ECE-412-Capstone-Sensor-Suite/Team-20-Sensor-Suite/Firmware/Py Scripts/readme.md

*OAP LOGGER* :
This is where we connect to the manager and receive and organize sensor data sent for the OAP(on-chip application) that we loaded onto the motes.
