ECE-412-Capstone-Sensor-Suite/Team-20-Sensor-Suite/Firmware/wind-sensor-to-PC-fan-Arduino--master/README.md

# wind-sensor-to-PC-fan-Arduino-
code for connecting wind sensor (Wind Sensor Rev. C) to array of PC fans with Arduino
