ECE-412-Capstone-Sensor-Suite/Team-20-Sensor-Suite/Project Weekly Meetings/412 Week 1  Meet .pptx

## 412 Week 1 Progress

by: Yousef Alkhelaifi, Calvin Xaybanha, Yikun Wang, Yudi Bao, Brandon Garcia

## Brandon’s Review

Completed:
- Added a paragraph on “Why” this device/system is being created.
- Added a paragraph on the Market analysis
- Created a rough draft of the Block 1 diagram.
- Added a few requirements
In progress:
- Research on what sensors to purchase
- Research on the Smartmesh IP
- Set schedule

## Yudi’s Review

Completed:
Search for smartmesh IP development environment
Search for several code samples about connecting sensors and arduino on github in order to build my things
(But still don’t know we should use smartmesh IP or arduino+wifi model to build system)
In progress:
Build the code frame according to requirements
Research different sensors that we should use

## Calvin’s Review

Completed:
- Added some project requirements
- Added a few sentences to the design specification
In Progress:
- Research on sensors + SmartMesh IP

## Yousef review

Completed:
- Created framework for PDS
- Rough Redrafted the Functional decomposition diagram to include a micro controller and highlight the interaction between the housing and the sensors
- Wrote an introduction to the PDS
In progress:
- Create a more detailed L1 diagram
- Finish the Gantt chart
- Decide which part of the project i want to lead

## Yikun Wang

Completed:
In progress:
- Research on low power supply(but still have no ideas of researching)
