ECE-412-Capstone-Sensor-Suite/Team-20-Sensor-Suite/Project Weekly Meetings/412 Week 4 Meet.pptx

## 412 Week 4 Progress

by: Yousef Alkhelaifi, Calvin Xaybanha, Yikun Wang, Yudi Bao, Brandon Garcia

## Yousef Al-Khelaifi

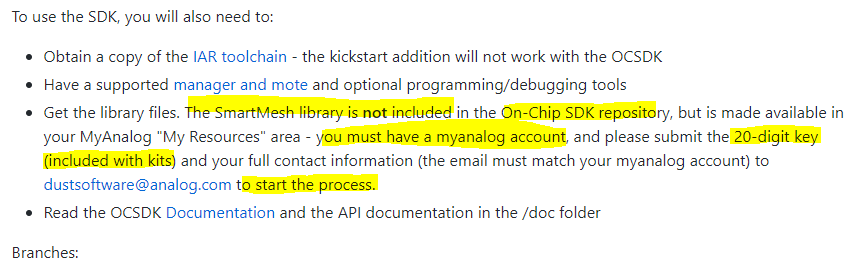
[picture p15: figure]

Completed
- Smartmesh IP BOM research to find get the basic set of components needed for cheapest price
- Microcontroller research [ Texas instruments - MSP432P401]
  - Development board - $19.99
  - Roughly 100 pins and great low power performance (80uA/Mhz)
  - TI supports debugging and programming only through Code composer studio
  - Might be too complex, if we are willing to invest the time of learning this complex chip, why not invest the time to learning using LTP5900 chip as primary microcontroller.
- Finalized initial peak-power consumption table
- Found some worrying thing on dust cloud

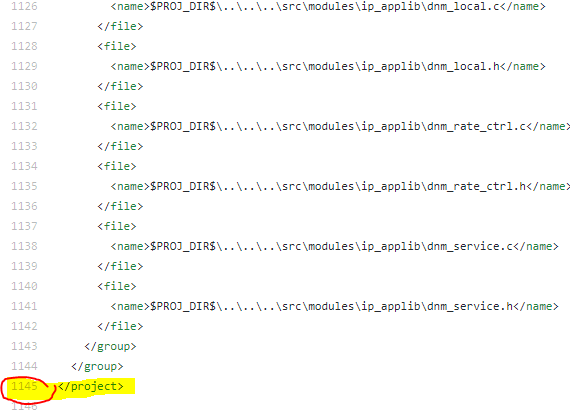
[picture p16: figure]
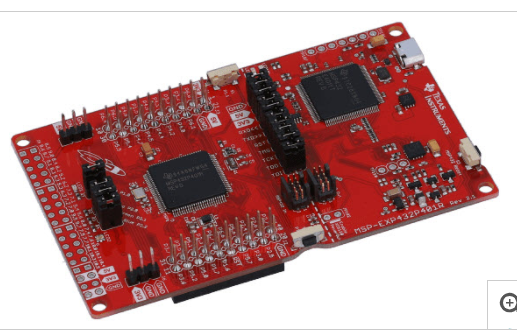
[picture p17: figure]

## Extra stuff

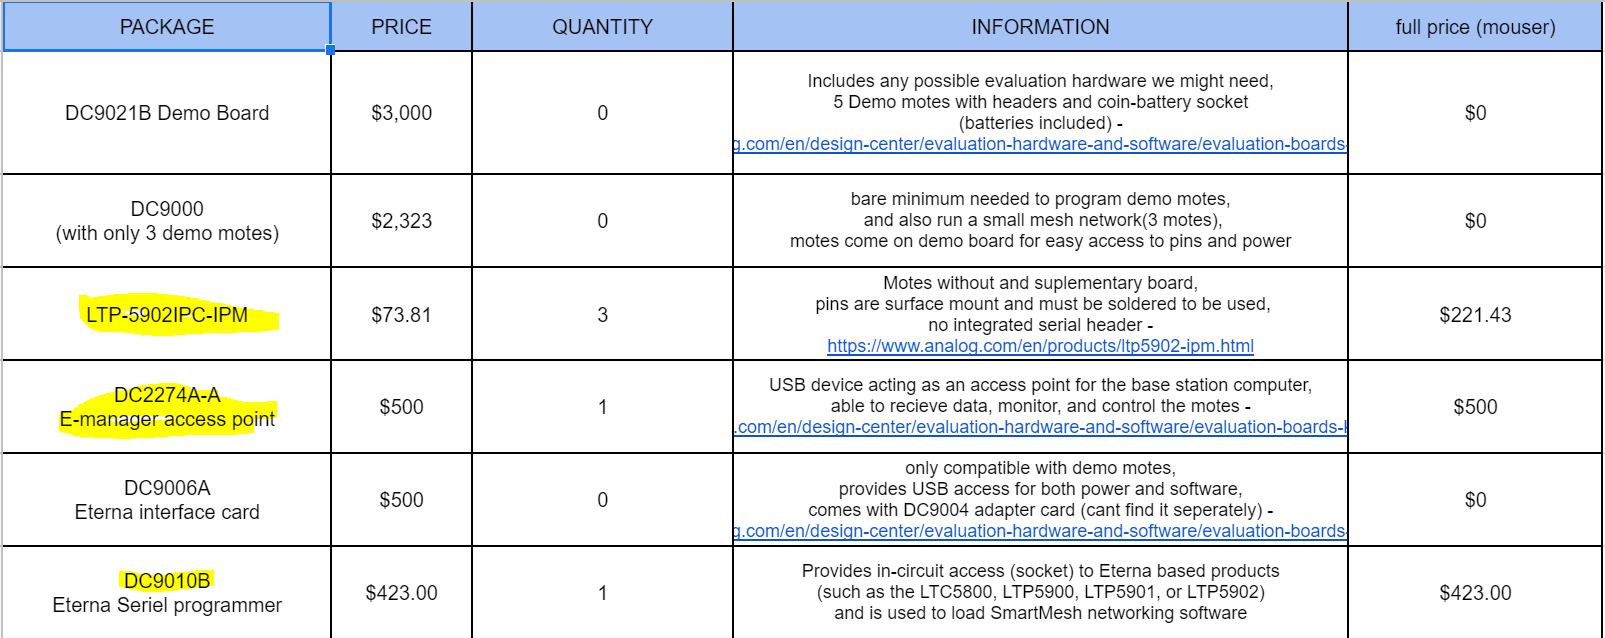
[picture p18: figure]

In Progress:
- Hands on testing with smart mesh hardware
- Researching SPI and I2C communication

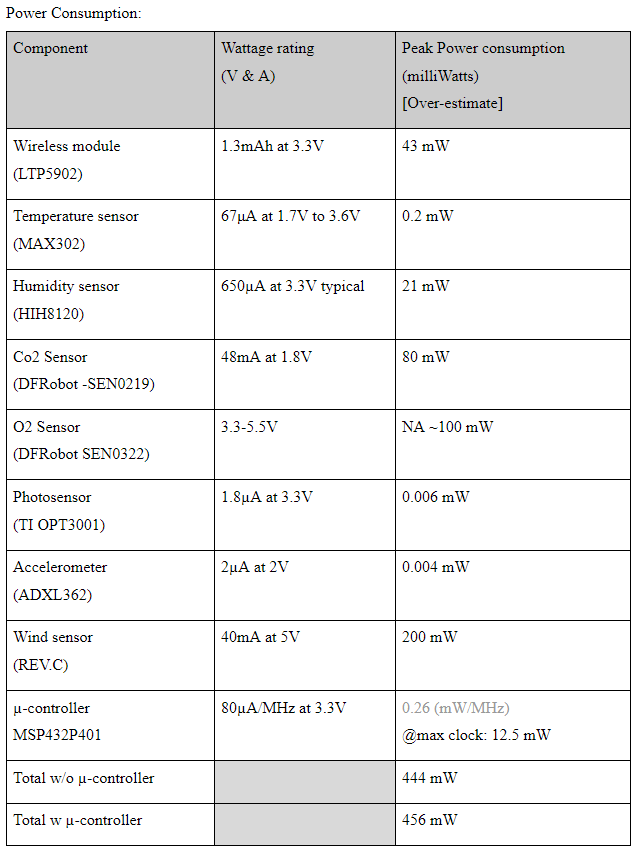
[picture p19: figure]

## Calvin Xaybanha

Completed:
- Rough Project Schedule outlined
Inprogress:
- Review and revise Project Design Specifications

## Yudi Bao

Completed:
- First version of Product Schedule
- Configure virtual machine for Emanager running
In progress:
- Continue to configure Smartmesh SDK part to
Win XP system by following the document of
SmartMesh WirelessHART Easy Start Guide

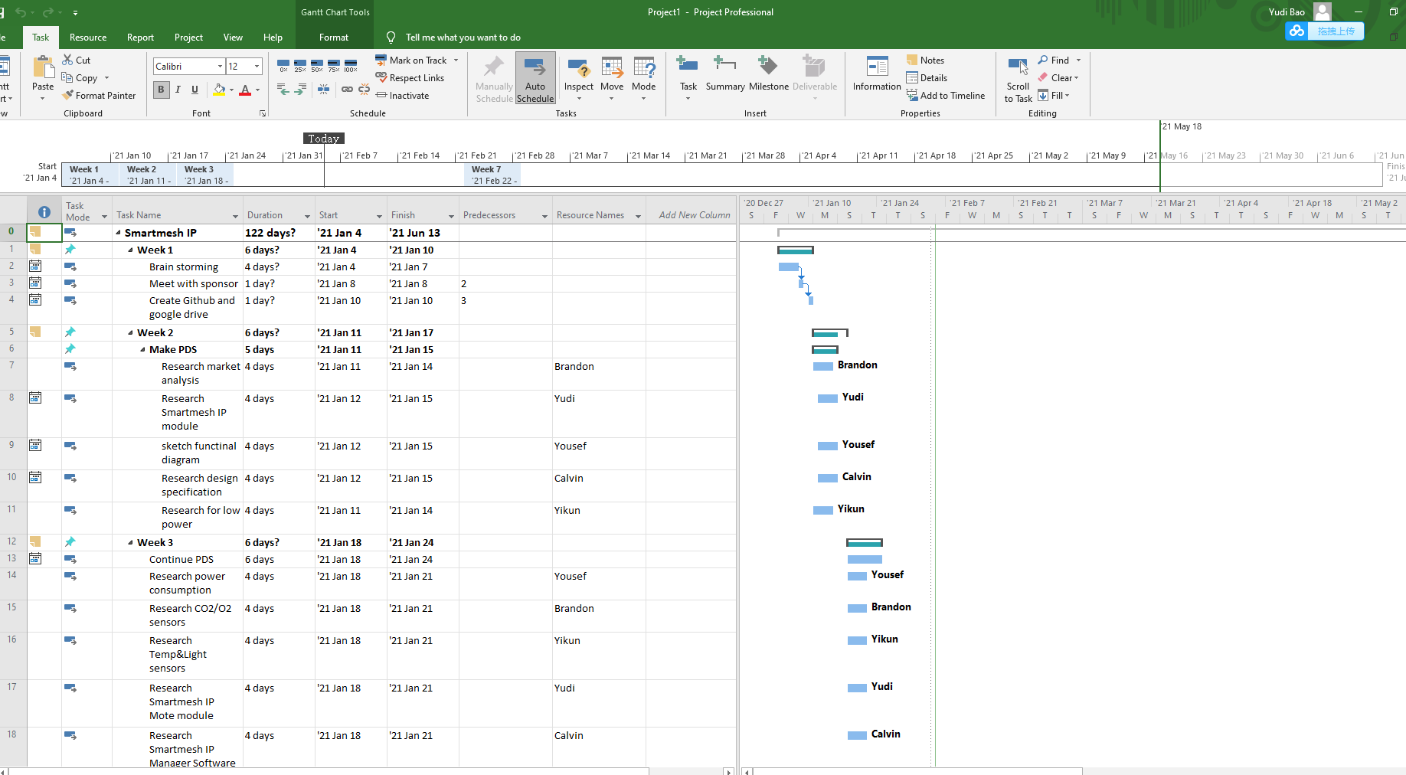
[picture p20: figure]
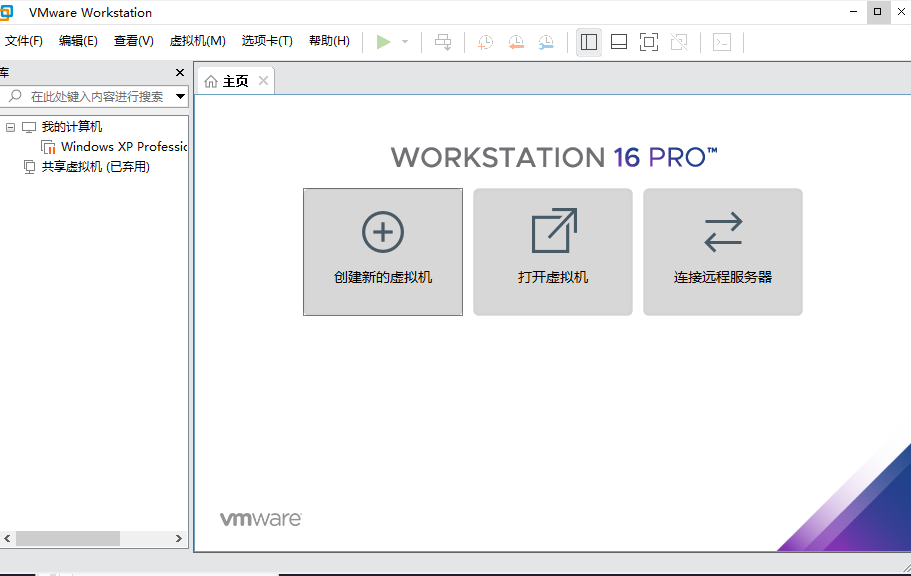
[picture p21: figure]

## Slide 6

The 1st project schedule:
1.Add missions from Week 1 to Week 22 to build frame of our work
2.Try to give all groups an even distribution of tasks

## VMware Workstation Pro 16 For Win XP operating system

According to document, Smartmesh SDK can match with Win XP, that’s why we need virtual machine(VM) to meet the requirement of software running.
1.find resource of .iso document 2. Search for activate code
3.upload Smartmesh SDK file to VM

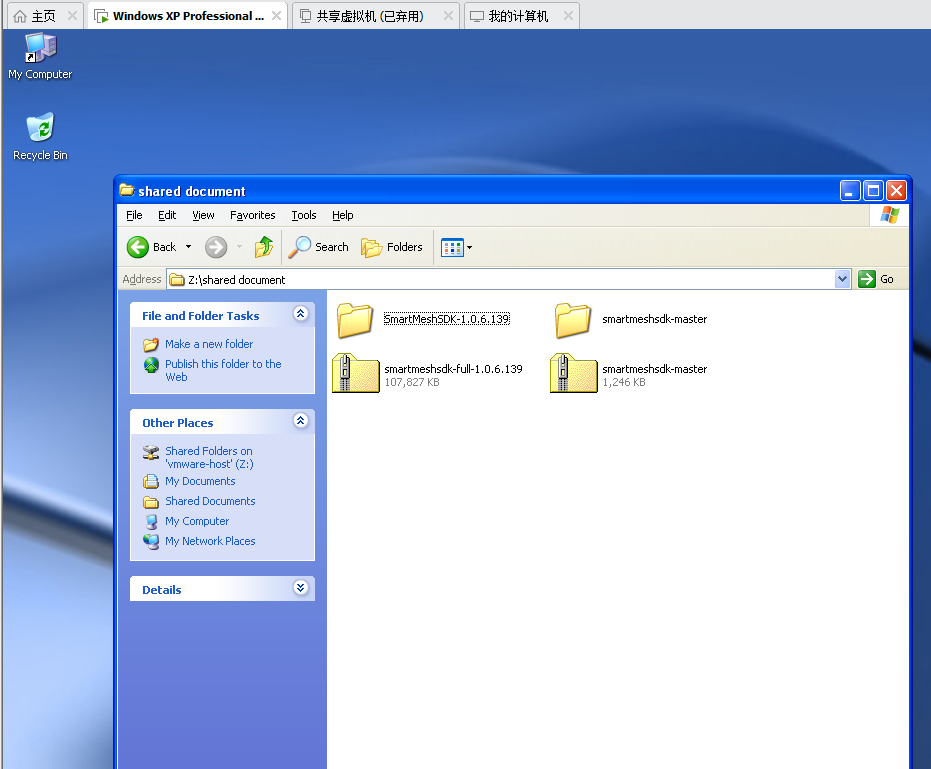
[picture p22: figure]
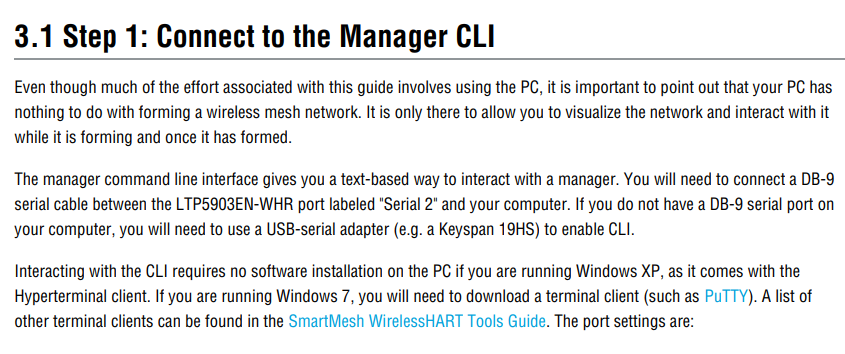
[picture p23: figure]

## Brandon Garcia

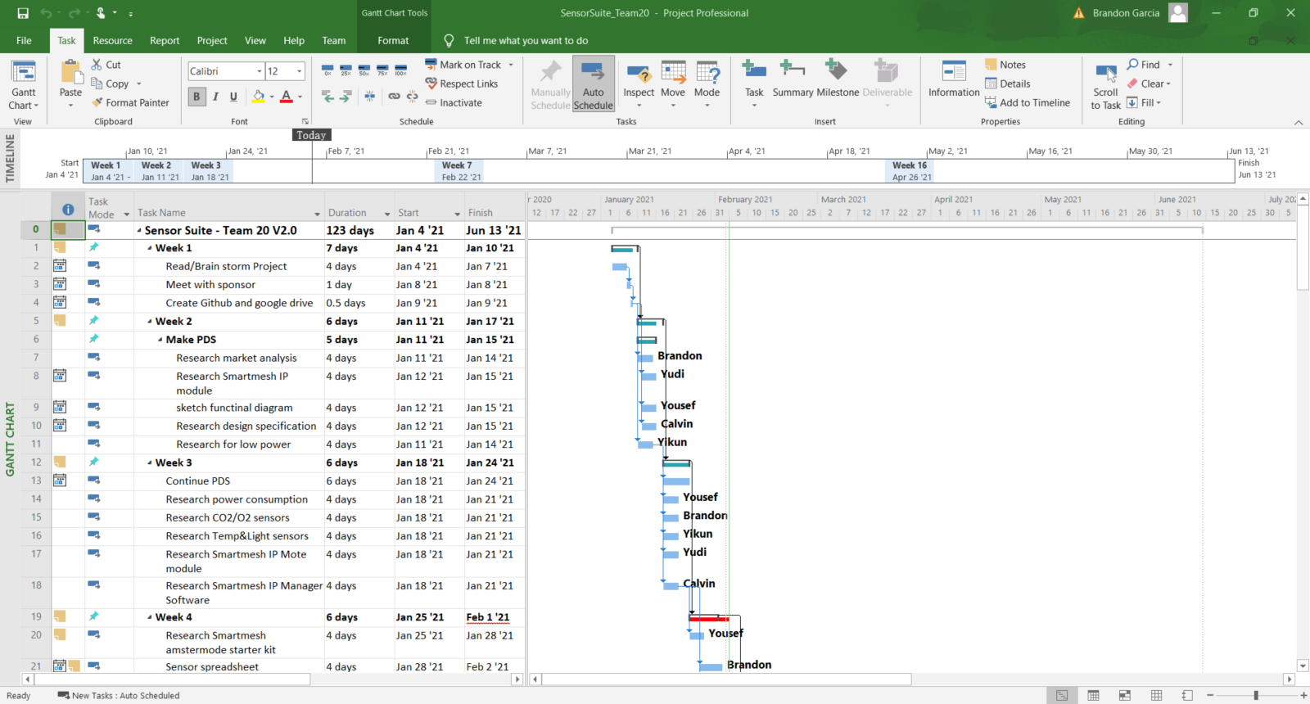
[picture p24: figure]

Completed:
- Final Draft of Project schedule
- Helped with Vibration Sensor search
- Finalize BOM for sensors
In Progress:
- Need PDS approval
- Github/Documentation Upload

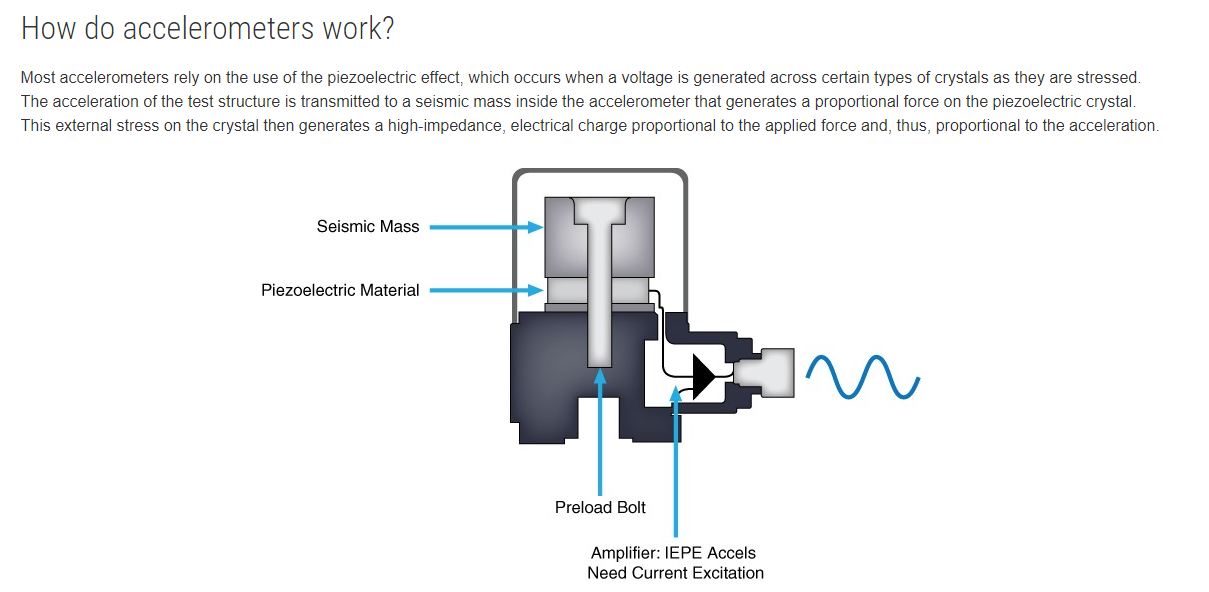
[picture p25: figure]

## CN CO2 Sensor- DFR Rebrand!

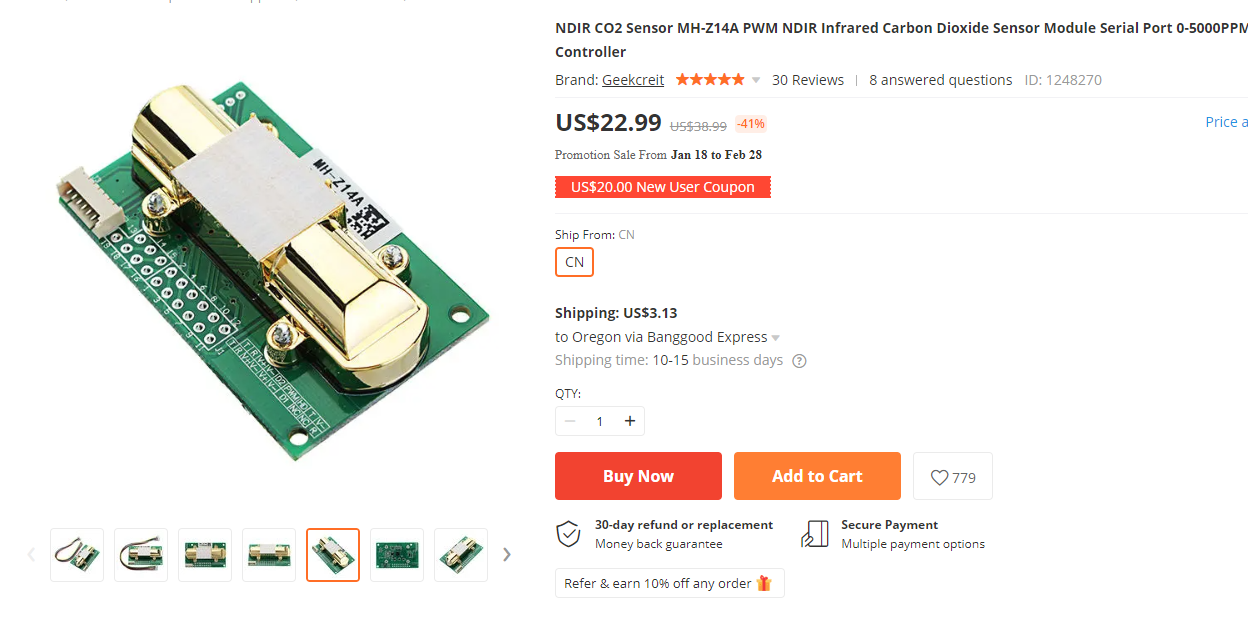
[picture p26: figure]

## Yikun Wang

Completed:
- Research on Vibration Sensor
Inprogress:
- Research on water contact sensor because of the supply power requirement
- Research on the code of our sensor_finding some similar examples

## Piezoelectric Sensor(Vibration)

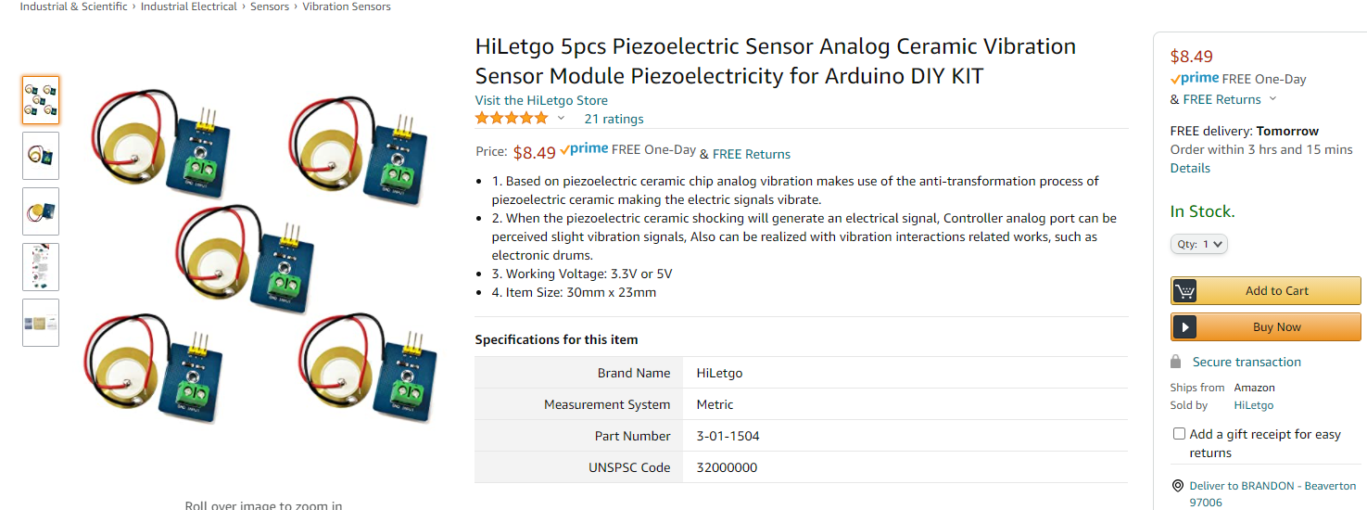
[picture p27: figure]
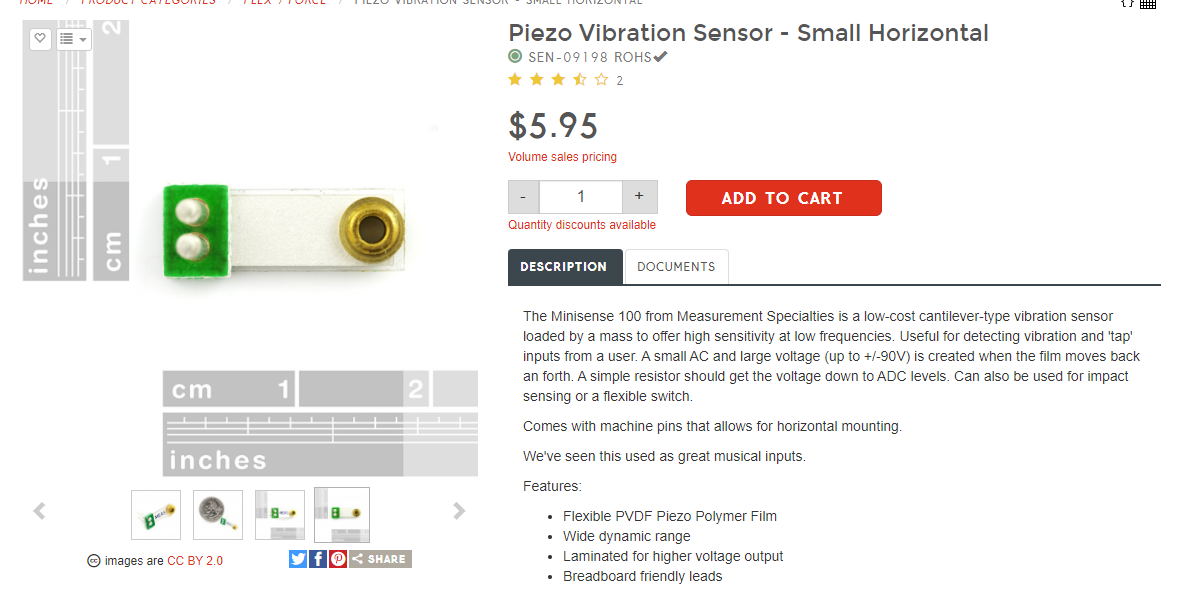
[picture p28: figure]
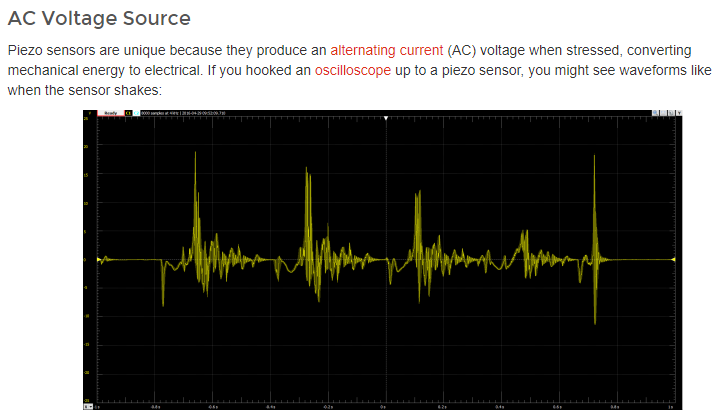
[picture p29: figure]
