ECE-412-Capstone-Sensor-Suite/Team-20-Sensor-Suite/Project Schedule/SensorSuite_Team20_V2.0.pdf

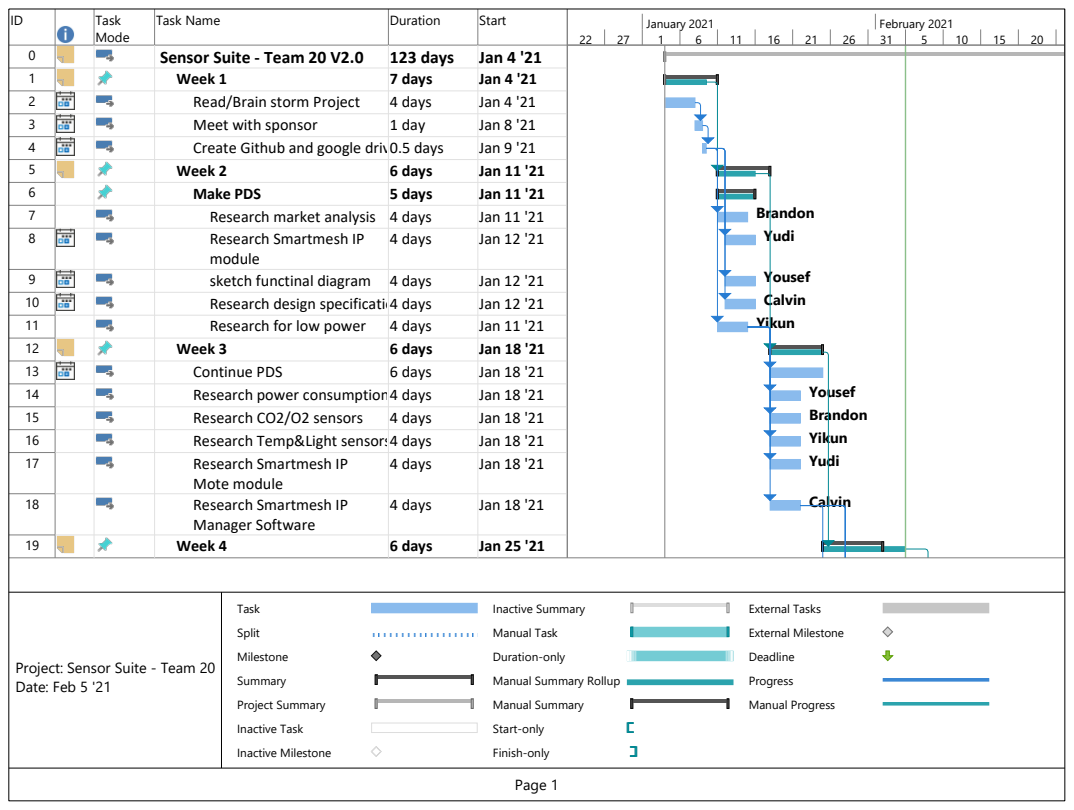
[picture p38: page 1]
Task; Mode; Task Name; Duration; Start; Sensor Suite - Team 20 V2.0; 123 days; Jan 4 '21; Week 1; 7 days; Read/Brain storm Project; 4 days; Meet with sponsor; 1 day; Jan 8 '21; Create Github and google drive0.5 days; Jan 9 '21; Week 2; 6 days; Jan 11 '21; Make PDS; 5 days; Research market analysis; Research Smartmesh IP; module; Jan 12 '21; sketch functinal diagram; Research design specification4 days; Research for low power; Week 3; Jan 18 '21; Continue PDS; Research power consumption4 days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

Project: Sensor Suite - Team 20
Date: Feb 5 '21

Manual Summary Rollup

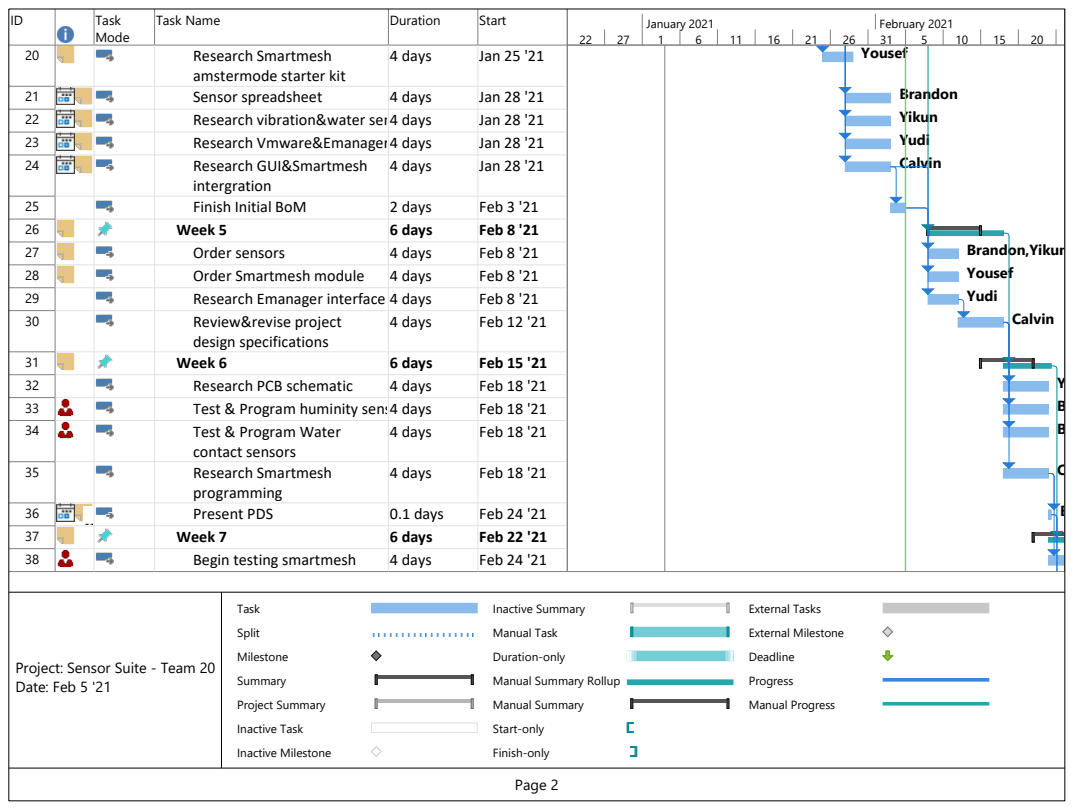
[picture p39: page 2]
Mode; Research Smartmesh; 4 days; Jan 25 '21; Sensor spreadsheet; Jan 28 '21; Research vibration&water sensors 4 days; Research Vmware&Emanager4 days; Research GUI&Smartmesh; intergration; Finish Initial BoM; 2 days; Feb 3 '21; Week 5; 6 days; Feb 8 '21; Order sensors; Order Smartmesh module; Research Emanager interface 4 days; Review&revise project; design specifications; Feb 12 '21; Week 6; Feb 15 '21; Research PCB schematic; Feb 18 '21; Test & Program huminity sensors 4 days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

amstermode starter kit

Brandon,Yikun,Yousef,Yudi,Calvin

Project: Sensor Suite - Team 20
Date: Feb 5 '21

Manual Summary Rollup

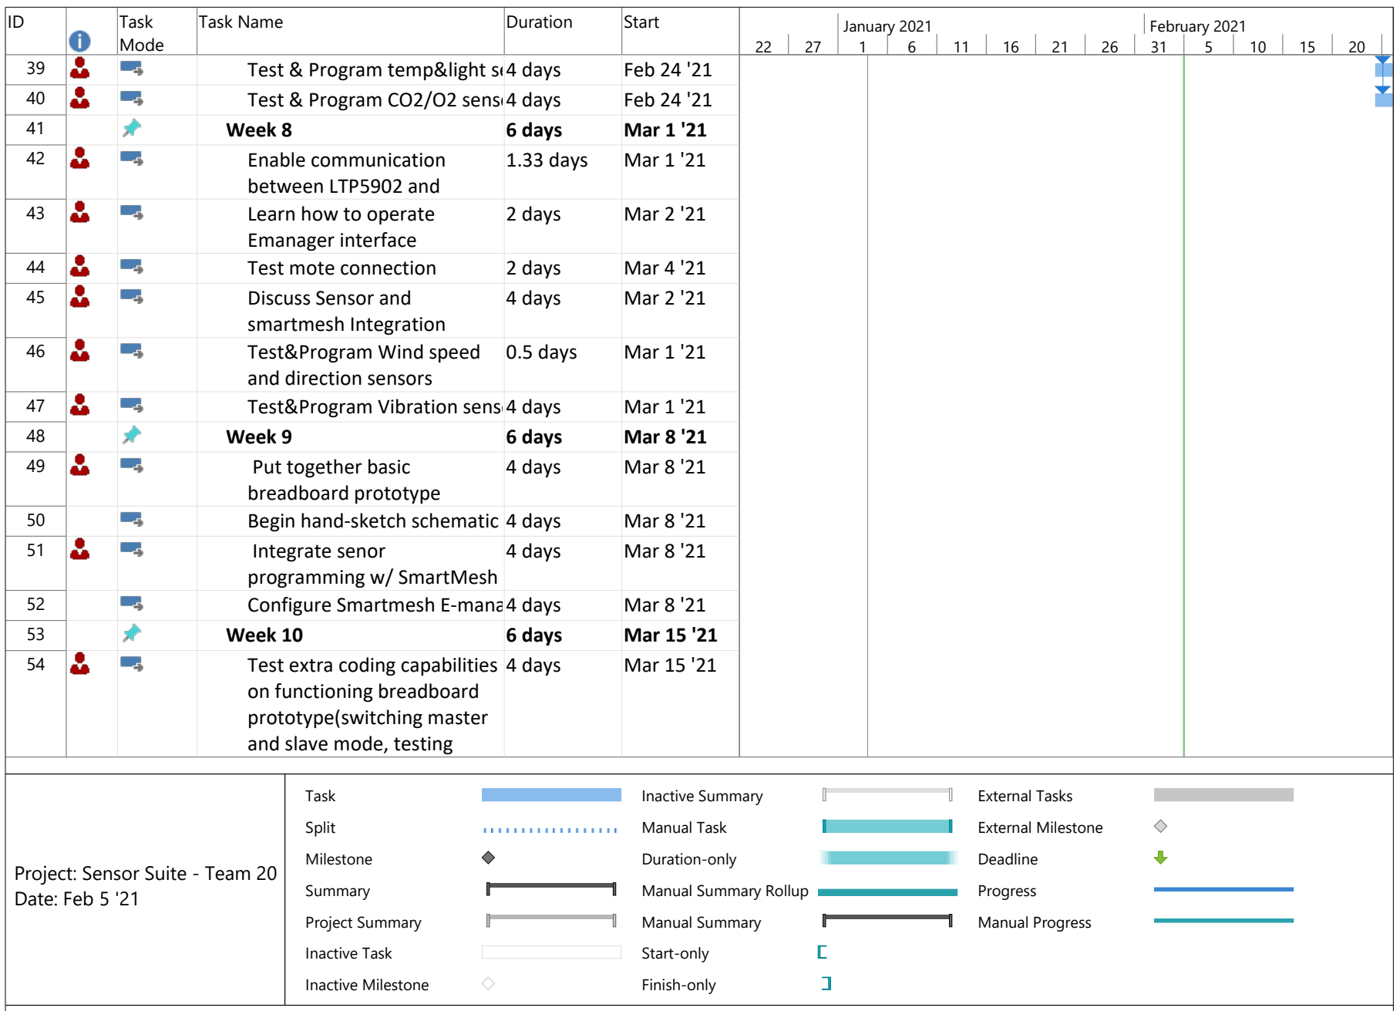
[picture p40: figure]
Mode; Week 8; 6 days; Mar 1 '21; Enable communication; between LTP5902 and; 1.33 days; Learn how to operate; Emanager interface; 2 days; Mar 2 '21; Test mote connection; Mar 4 '21; Discuss Sensor and; smartmesh Integration; 4 days; Test&Program Wind speed; and direction sensors; 0.5 days; Test&Program Vibration sensors 4 days; Week 9; Mar 8 '21; Put together basic; breadboard prototype; Begin hand-sketch schematic; Integrate senor; programming w/ SmartMesh; Configure Smartmesh E-manager 4 days; Week 10; Mar 15 '21; Test extra coding capabilities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

39 | Test & Program temp&light sensors 4 days | Feb 24 '21
40 | Test & Program CO2/O2 sensors 4 days | Feb 24 '21

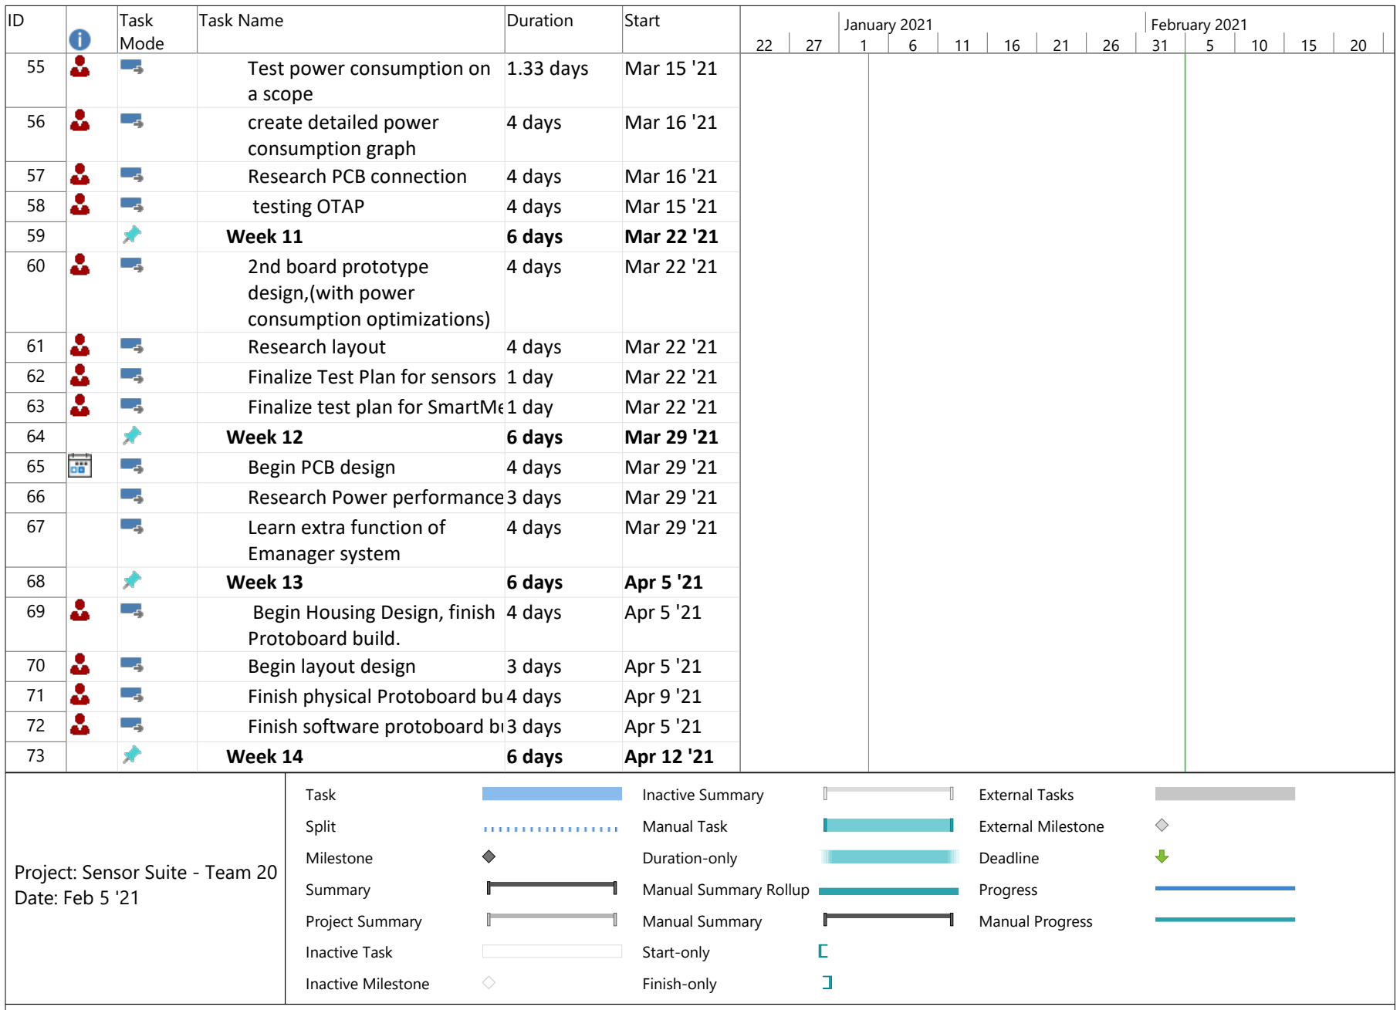
[picture p41: figure]
Mode; Test power consumption on; a scope; 1.33 days; Mar 15 '21; create detailed power; consumption graph; 4 days; Mar 16 '21; Research PCB connection; testing OTAP; Week 11; 6 days; Mar 22 '21; 2nd board prototype; design,(with power consumption optimizations); Research layout; Finalize Test Plan for sensors; 1 day; Week 12; Mar 29 '21; Begin PCB design; Research Power performance3 days; Learn extra function of; Emanager system; Week 13; Apr 5 '21; Begin Housing Design, finish; Protoboard build.; Begin layout design; 3 days; Finish physical Protoboard build4 days; Apr 9 '21; Week 14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

63 | Finalize test plan for SmartMesh1 day | Mar 22 '21
72 | Finish software protoboard build 3 ays | Apr 5 '21

Mode
74 | Begin Visual Dashboard | 4 days | Apr 12 '21
75 | Configure data-organizations system | 4 days | Apr 12 '21
76 | Finish coding on protoboard build | 4 days | Apr 12 '21
77 | Discuss PCB progress | 4 days | Apr 12 '21
78 | Week 15 | 6 days | Apr 19 '21
79 | Finalize PCB design and send files for fabrication | 4 days | Apr 19 '21
80 | FInalize Housing Design | 4 days | Apr 19 '21
81 | Finalize Power Source | 4 days | Apr 19 '21
82 | Discuss Documentation progress 1 day | Apr 19 '21
83 | Finish final BoM | 2 days | Apr 23 '21
84 | Week 16 | 6 days | Apr 26 '21
85 | Allow for shipping time for PCB fabrication | 4 days | Apr 27 '21
86 | Calculate theorical power consumption of 2nd propotype system | 4 days | Apr 27 '21
87 | Build 2nd prototype in real environment | 4 days | Apr 26 '21
88 | Week 17 | 6 days | May 3 '21
22 | 27 | 1 | 6 | 11 | 16 | 21 | 26 | 31 | 5 | 10 | 15 | 20

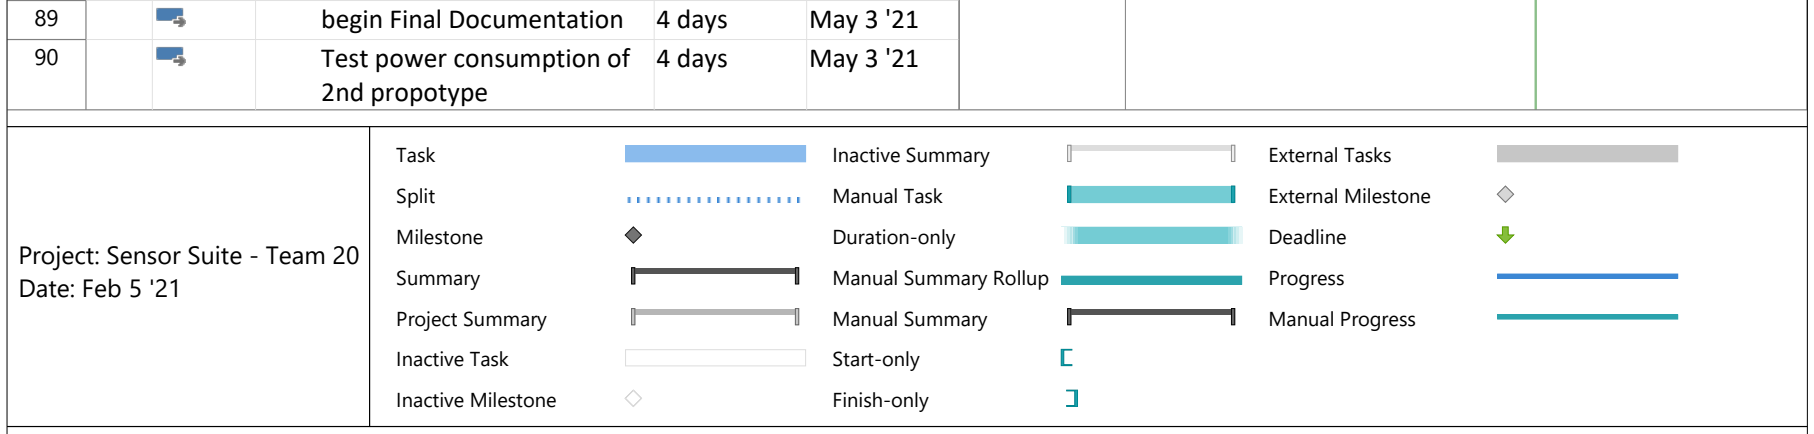
[picture p42: figure]
begin Final Documentation; 4 days; May 3 '21; Test power consumption of; 2nd propotype; Task; Split; Milestone; Summary; Project Summary; Inactive Task; Inactive Milestone; Inactive Summary; Manual Task; Duration-only; Manual Summary Rollup; Manual Summary; Start-only; Finish-only; External Tasks; External Milestone; Deadline; Progress; Manual Progress; Project: Sensor Suite - Team 20 Date: Feb 5 '21

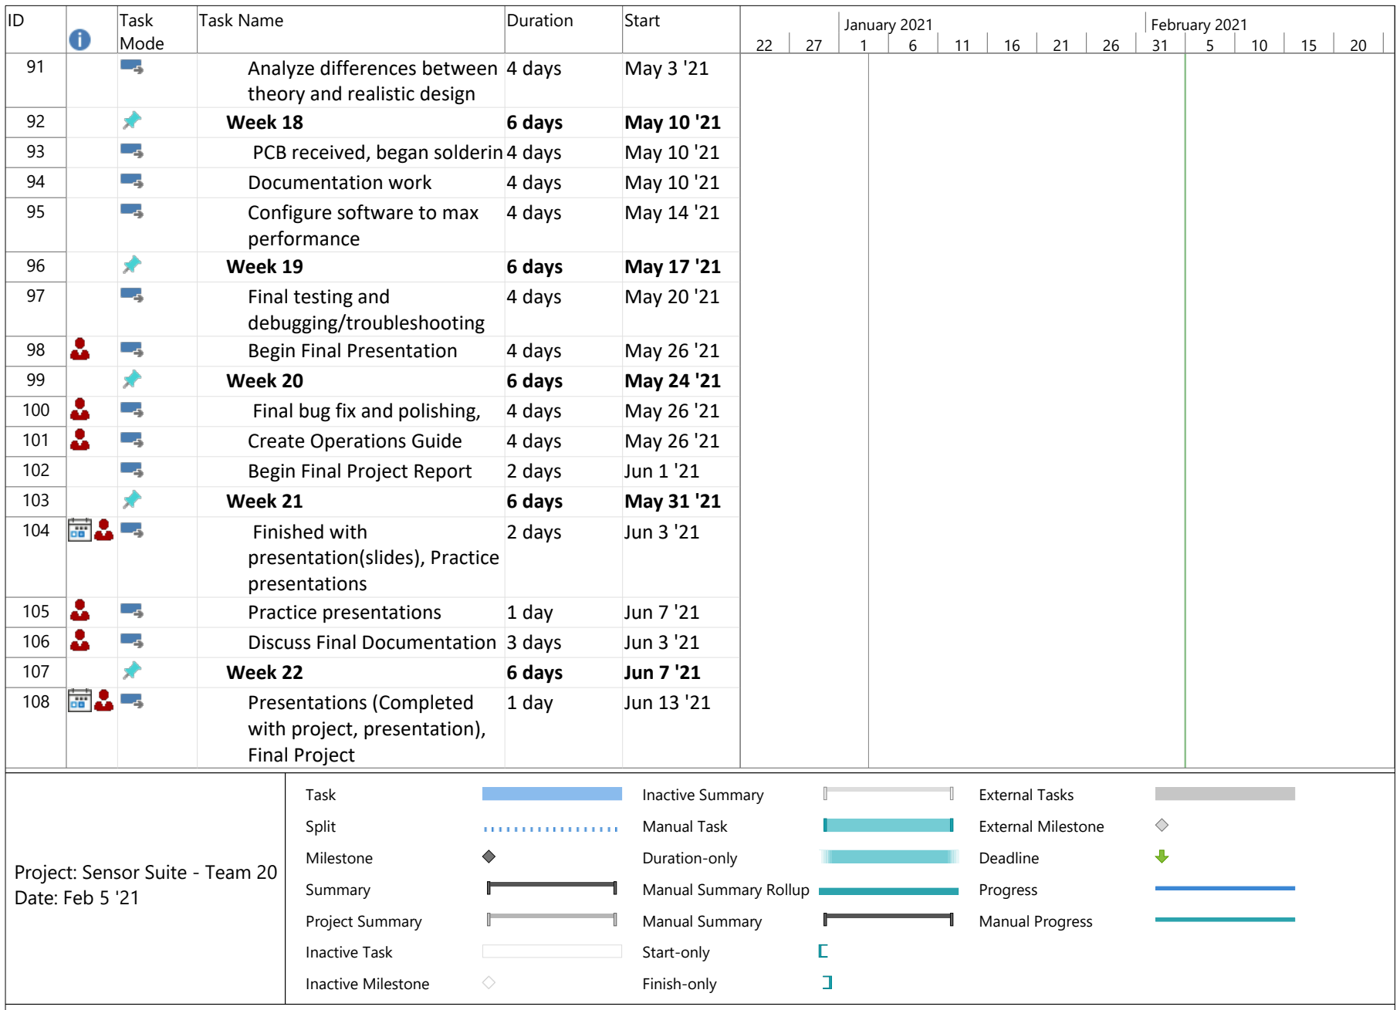
[picture p43: figure]
Mode; Analyze differences between; theory and realistic design; 4 days; May 3 '21; Week 18; 6 days; May 10 '21; PCB received, began soldering4 days; Documentation work; Configure software to max; performance; May 14 '21; Week 19; May 17 '21; Final testing and; debugging/troubleshooting; May 20 '21; Begin Final Presentation; May 26 '21; Week 20; May 24 '21; Final bug fix and polishing,; Create Operations Guide; Begin Final Project Report; 2 days; Jun 1 '21; Week 21; May 31 '21; Finished with; presentation(slides), Practice presentations; Jun 3 '21; Practice presentations; 1 day; Jun 7 '21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

Mode
109 | Second Team evaluation | 1 day | Jun 13 '21
22 | 27 | 1 | 6 | 11 | 16 | 21 | 26 | 31 | 5 | 10 | 15 | 20

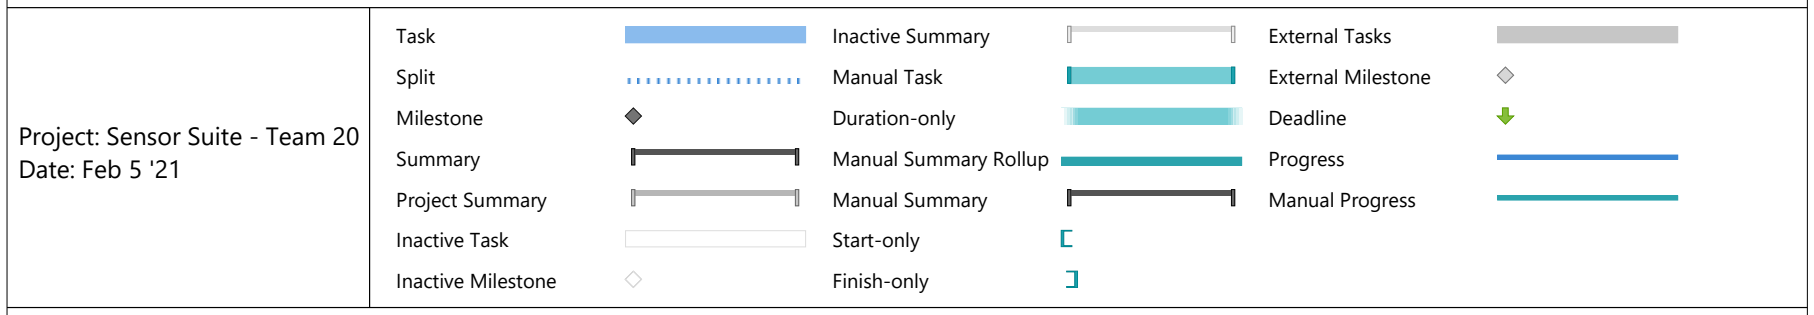
[picture p44: figure]
Task; Split; Milestone; Summary; Project Summary; Inactive Task; Inactive Milestone; Inactive Summary; Manual Task; Duration-only; Manual Summary Rollup; Manual Summary; Start-only; Finish-only; External Tasks; External Milestone; Deadline; Progress; Manual Progress; Project: Sensor Suite - Team 20 Date: Feb 5 '21

25 | 2 | 7 | 12 | 17 | 22 | 27 | 1 | 6 | 11 | 16 | 21 | 26 | 1 | 6 | 11 | 16 | 21 | 26 | 31 | 5 | 10 | 15 | 20 | 25 | 30 | 5 | 10
March 2021 | April 2021 | May 2021 | June 2021 | July 2021

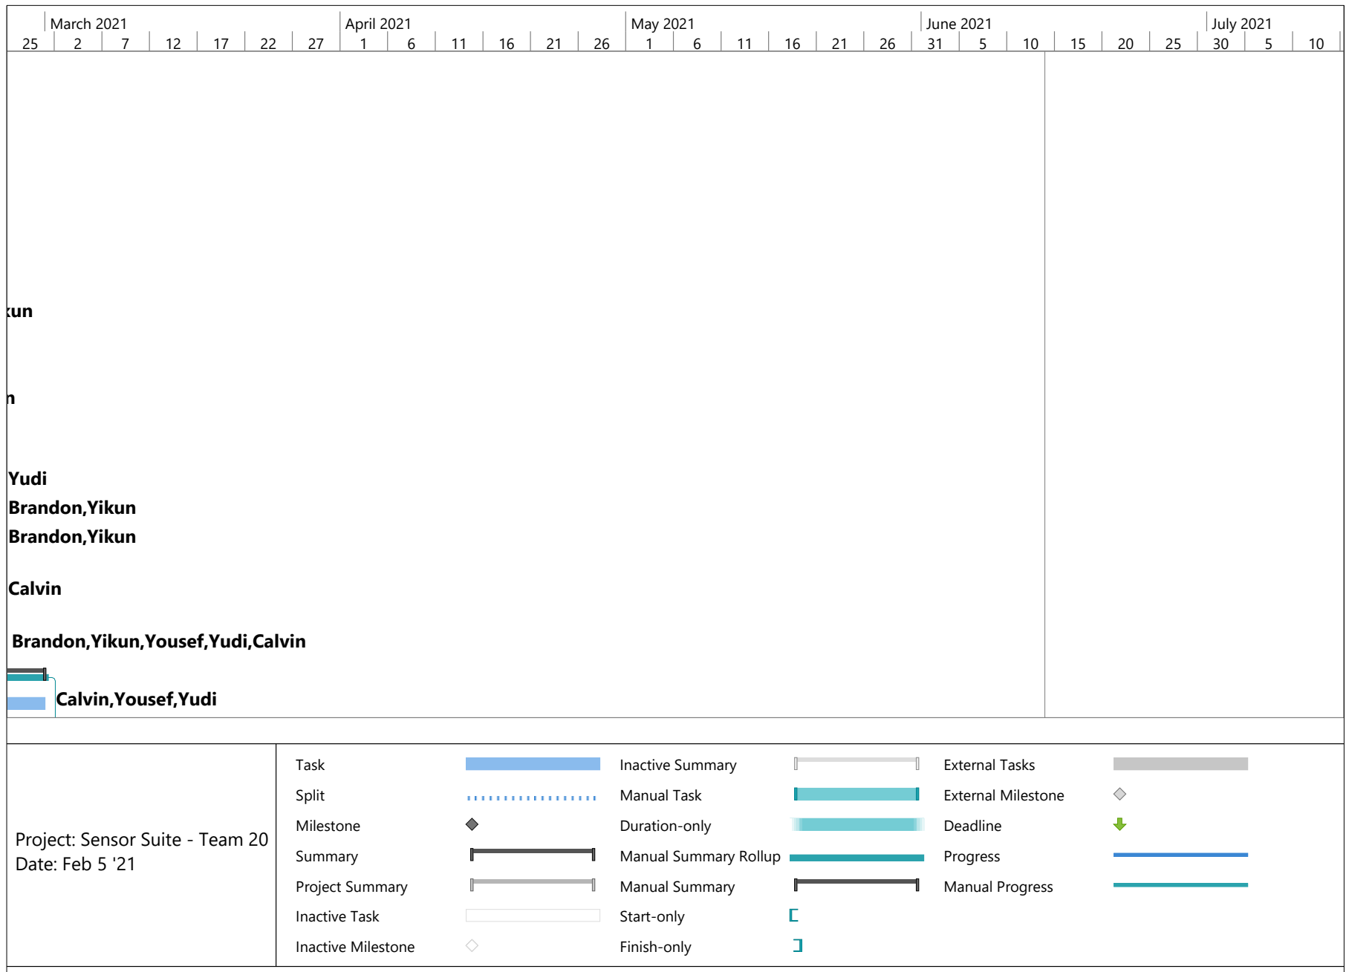
[picture p45: figure]
Brandon,Yikun; Yousef; Yudi; Calvin; Brandon,Yikun,Yousef,Yudi,Calvin; Calvin,Yousef,Yudi; Task; Split; Milestone; Summary; Project Summary; Inactive Task; Inactive Milestone; Inactive Summary; Manual Task; Duration-only; Manual Summary Rollup; Manual Summary; Start-only; Finish-only; External Tasks; External Milestone; Deadline; Progress; Manual Progress; Project: Sensor Suite - Team 20 Date: Feb 5 '21
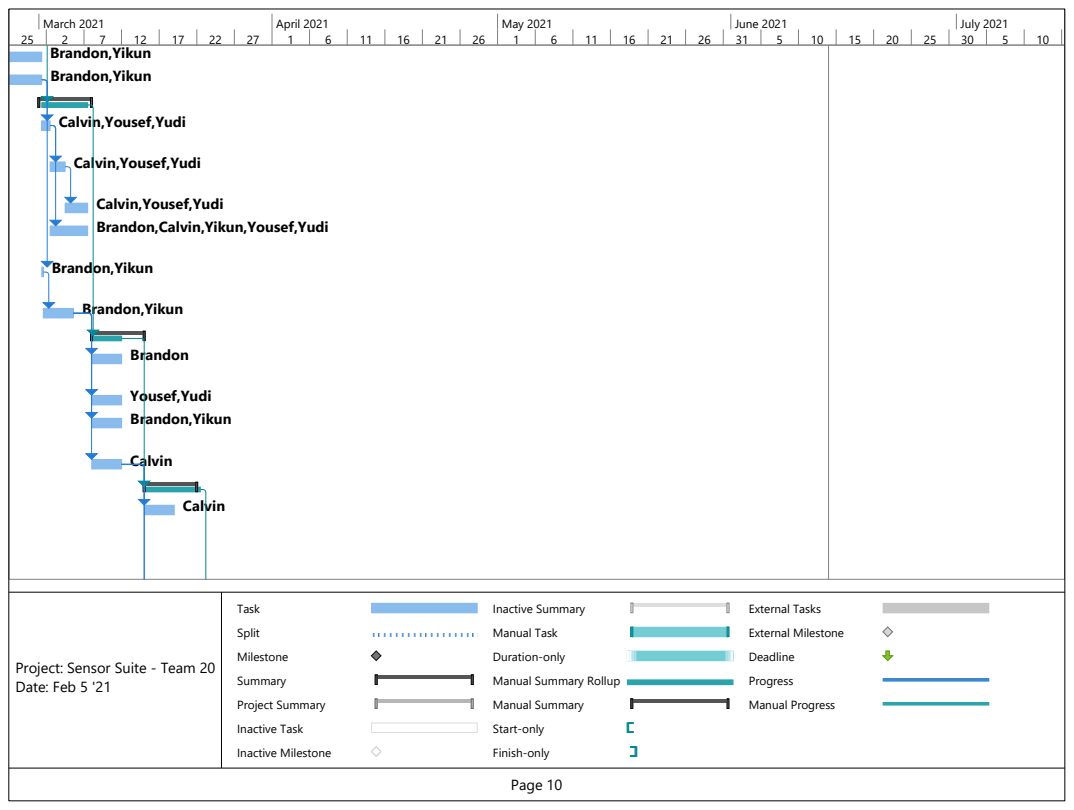
[picture p46: page 10]
Brandon,Yikun; Brandon; Yousef,Yudi; Calvin; Task; Split; Milestone; Summary; Project Summary; Inactive Task; Inactive Milestone; Inactive Summary; Manual Task; Duration-only; Manual Summary; Start-only; Finish-only; External Tasks; External Milestone; Deadline; Progress; Manual Progress

Calvin,Yousef,Yudi

Brandon,Calvin,Yikun,Yousef,Yudi

Project: Sensor Suite - Team 20
Date: Feb 5 '21

Manual Summary Rollup

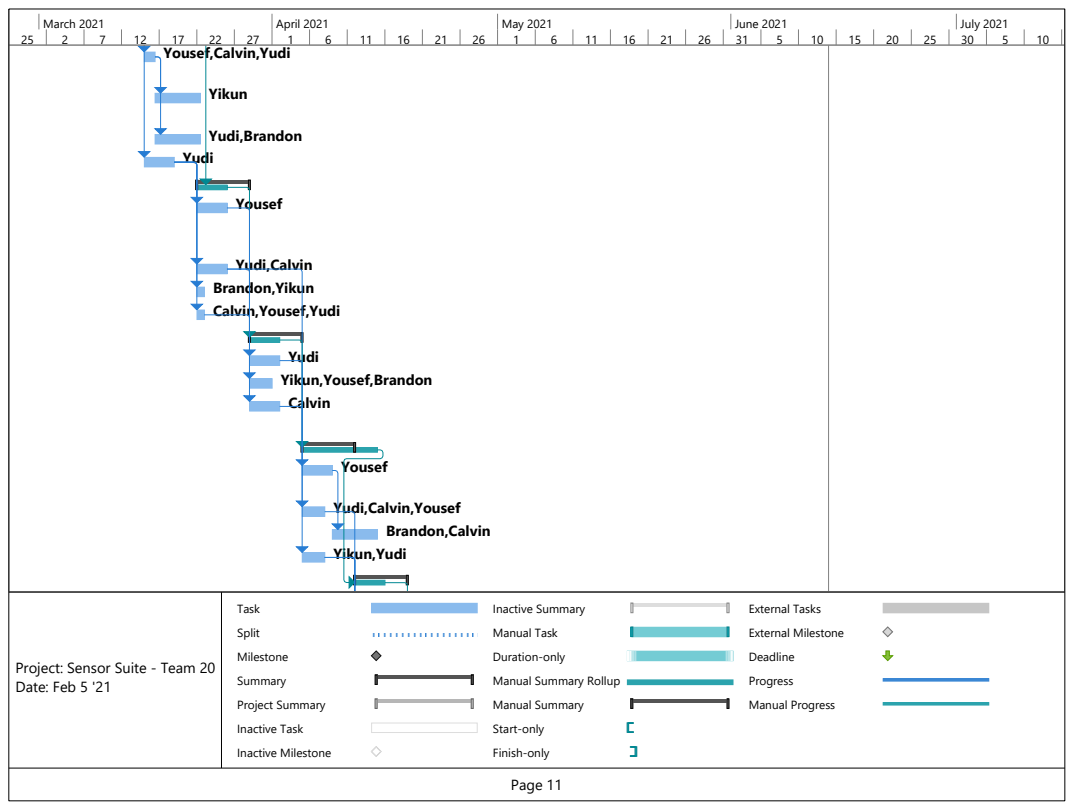
[picture p47: page 11]
Yikun; Yudi,Brandon; Yudi; Yousef; Brandon,Calvin; Yikun,Yudi; Task; Split; Milestone; Summary; Project Summary; Inactive Task; Inactive Milestone; Inactive Summary; Manual Task; Duration-only; Manual Summary; Start-only; Finish-only; External Tasks; External Milestone; Deadline; Progress; Manual Progress

Yousef,Calvin,Yudi

Yudi,Calvin
Brandon,Yikun
Calvin,Yousef,Yudi

Yudi
Yikun,Yousef,Brandon
Calvin

Yudi,Calvin,Yousef

Project: Sensor Suite - Team 20
Date: Feb 5 '21

Manual Summary Rollup

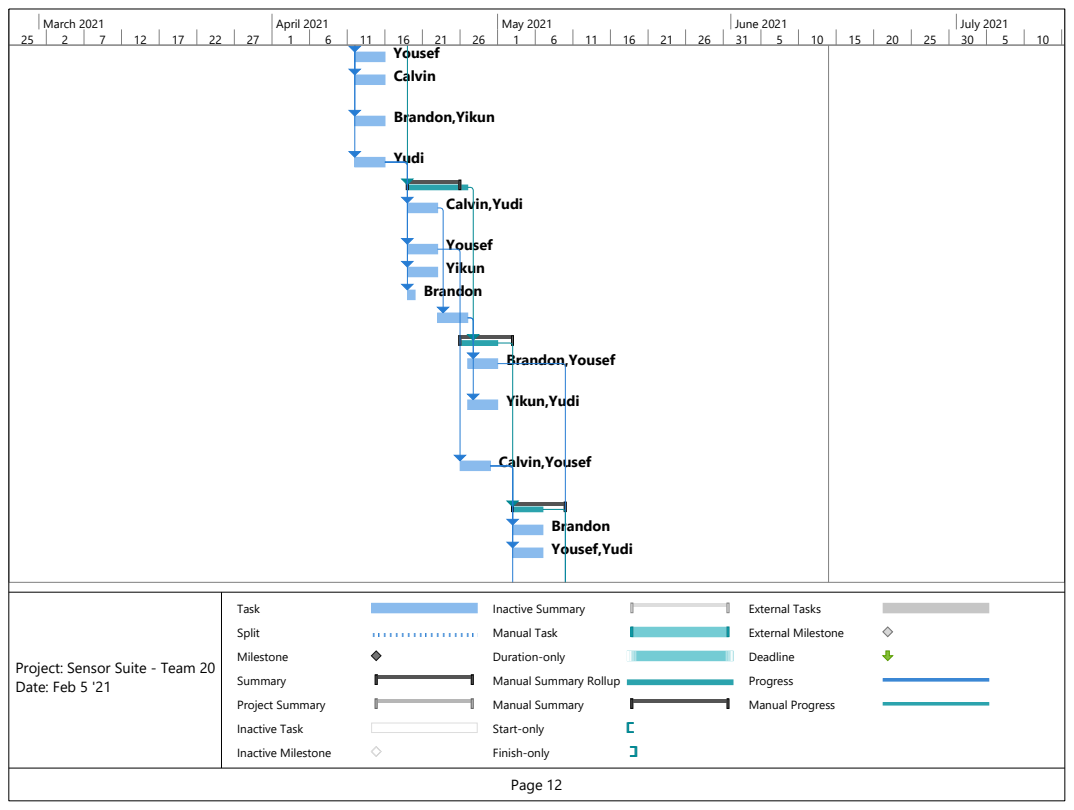
[picture p48: page 12]
Yousef; Calvin; Brandon,Yikun; Yudi; Calvin,Yudi; Yikun; Brandon; Brandon,Yousef; Yikun,Yudi; Calvin,Yousef; Yousef,Yudi; Task; Split; Milestone; Summary; Project Summary; Inactive Task; Inactive Milestone; Inactive Summary; Manual Task; Duration-only; Manual Summary; Start-only; Finish-only; External Tasks; External Milestone; Deadline; Progress; Manual Progress

Project: Sensor Suite - Team 20
Date: Feb 5 '21

Manual Summary Rollup

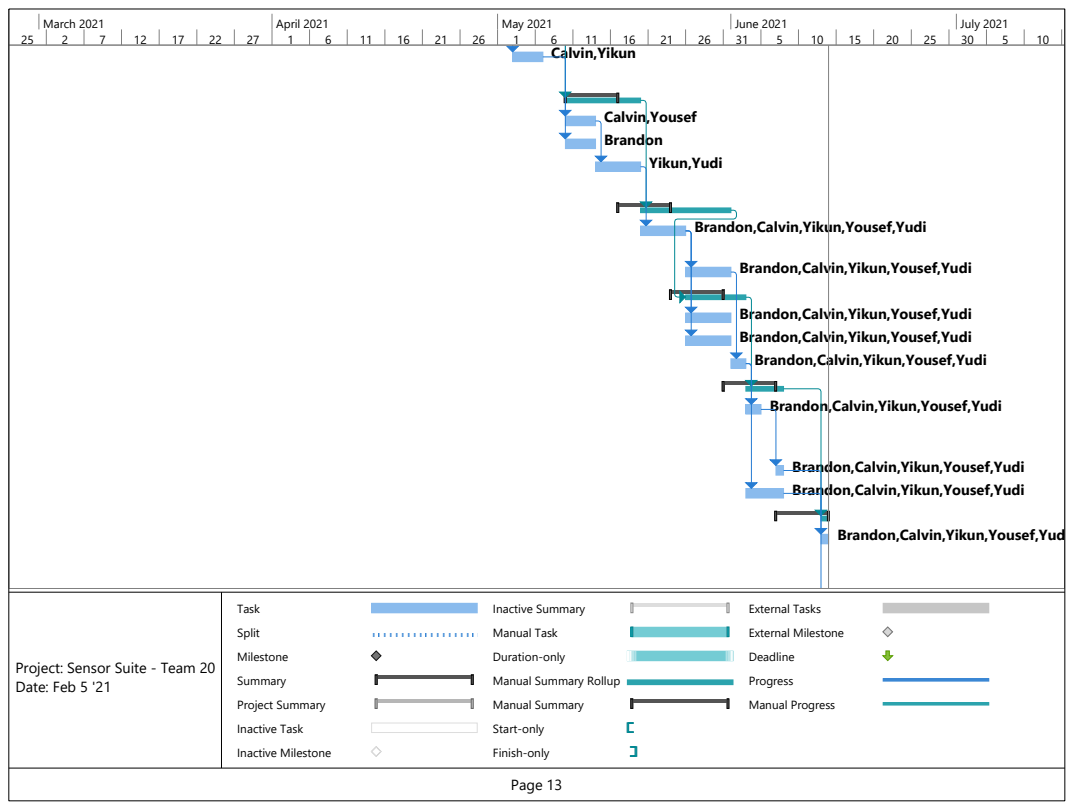
[picture p49: page 13]
Calvin,Yikun; Calvin,Yousef; Brandon; Yikun,Yudi; Task; Split; Milestone; Summary; Project Summary; Inactive Task; Inactive Milestone; Inactive Summary; Manual Task; Duration-only; Manual Summary; Start-only; Finish-only; External Tasks; External Milestone; Deadline; Progress; Manual Progress

Brandon,Calvin,Yikun,Yousef,Yudi

Project: Sensor Suite - Team 20
Date: Feb 5 '21

Manual Summary Rollup

Brandon,Calvin,Yikun,Yousef,Yudi

25 | 2 | 7 | 12 | 17 | 22 | 27 | 1 | 6 | 11 | 16 | 21 | 26 | 1 | 6 | 11 | 16 | 21 | 26 | 31 | 5 | 10 | 15 | 20 | 25 | 30 | 5 | 10
