ECE-412-Capstone-Sensor-Suite/Team-20-Sensor-Suite/Firmware/Network Back-end/node-red examples/Basic event flow.PNG

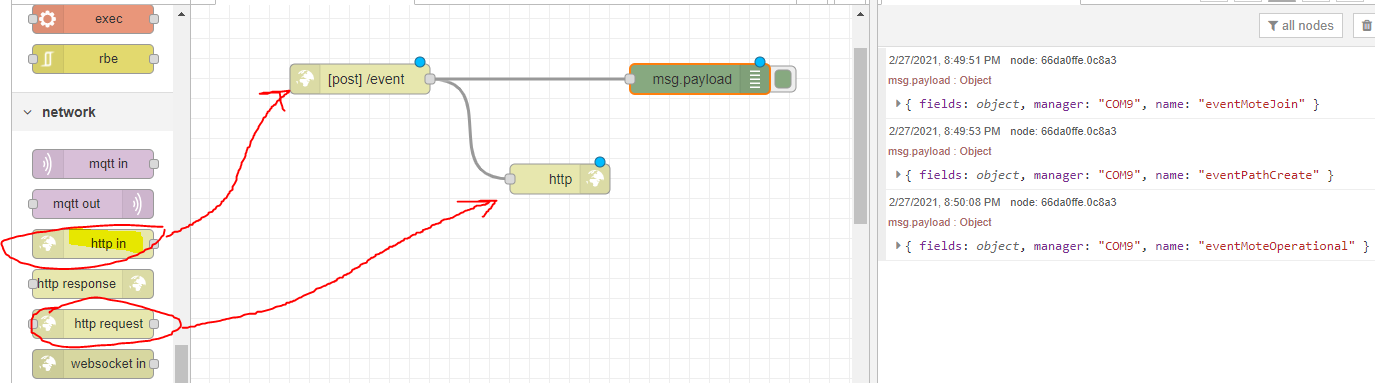
Firmware/Network Back-end/node-red examples/Basic event flow.PNG
