ECE-412-Capstone-Sensor-Suite/Team-20-Sensor-Suite/Firmware/Py Scripts/data visualization/Organization_Part_2.7/Temperature.png

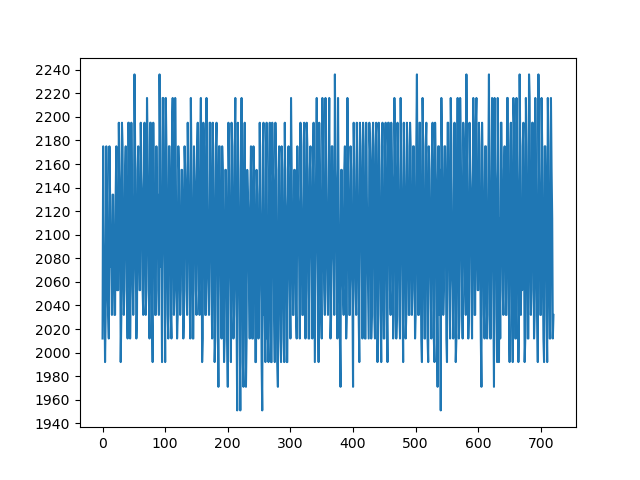
Firmware/Py Scripts/data visualization/Organization_Part_2.7/Temperature.png
