ECE-412-Capstone-Sensor-Suite/Team-20-Sensor-Suite/Firmware/Py Scripts/data visualization/Presenation_Part_2.7/plot_show.png

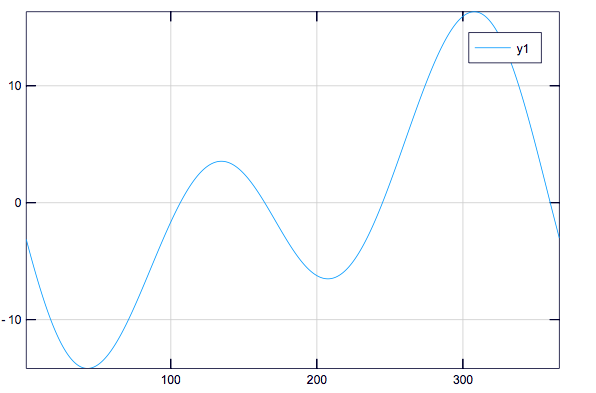
Firmware/Py Scripts/data visualization/Presenation_Part_2.7/plot_show.png
