ECE-412-Capstone-Sensor-Suite/Team-20-Sensor-Suite/Design Files/mote+cc3200_AutomaticBOM.txt

Partlist exported from C:/Users/Yesoooof/Documents/GitHub/Team-20-Sensor-Suite/Design Files/mote+cc3200.sch at 5/24/2021 5:36 PM

Part   Value             Device            Package                        Description                                                                                                                                              ALTERNATEPARTNUMBER ARROW_PART_NUMBER ARROW_PRICE-STOCK COMPTYPE CREATED_BY    DESCRIPTION                                                                                                                                              DIGIKEY_PART_NUMBER HEIGHT MANUF MANUFACTURER      MANUFACTURER_NAME     MANUFACTURER_PART_NUMBER MOUNTTYPE MOUSER_PART_NUMBER MOUSER_PRICE-STOCK                                                                                            MPN              PACKAGE  PACKAGEREFERENCE PARTNUM  PARTNUMBER     PIN_COUNT POPULARITY REFDES ROHS SPICEMODEL SPICEPREFIX TYPE VALUE   
AC1    ADXL345           ADXL345           CC-14-1                        3-Axis Accelerometer IC                                                                                                                                                                                                                 3-Axis Accelerometer IC                                                                                                                                                      mm                             Analog Devices        ADXL345                            N/A                https://www.mouser.co.uk/ProductDetail/Analog-Devices/ADXL345?qs=5aG0NVq1C4y%252BItyqaAF9pQ%3D%3D                                                                                                                                                     
BATT_1 BATTERY_BR1225/FA BATTERY_BR1225/FA BATTERY_BR1225/FA              BATT LITH COIN 3V                                                                                                                                                                                                                                                                                                                                                                                                                                                                                                                                                                                                                                                                                                                                                                     
BATT_2 12BH23P-GR        12BH23P-GR        12BH23PGR                      Cylindrical Battery Contacts, Clips, Holders & Springs CR123A HOLDER                                                                                                                                                                    Cylindrical Battery Contacts, Clips, Holders & Springs CR123A HOLDER                                                                                                         15.6mm                         Eagle Plastic Devices 12BH23P-GR                         12BH23P-GR         https://www.mouser.co.uk/ProductDetail/Eagle-Plastic-Devices/12BH23P-GR/?qs=AQlKX63v8RtoPEbnxYQ6dg%3D%3D                                                                                                                                              
C1     10 uF             CC1808            C1808                          CAPACITOR, European symbol                                                                                                                                                                                                                                                                                                                                                                                                                                                                                                                                                                                                                                                                                                                        NONE       C                        
C2     10 uF             CC1808            C1808                          CAPACITOR, European symbol                                                                                                                                                                                                                                                                                                                                                                                                                                                                                                                                                                                                                                                                                                                        NONE       C                        
C3     0.1uF             C5/3.5            C5B3.5                         CAPACITOR                                                                                                                                                                                                                                                                                                                                                                                                                                                                                                                                                                                                                                                                                                                  3                                                          
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
D1     SP1002-01JTG      SP1002-01JTG      SOT132P220X110-3N              Littelfuse SP1002-01JTG, Dual-Element Bi-Directional TVS Diode Array, 3-Pin SC-70                                                                                                                                                       Littelfuse SP1002-01JTG, Dual-Element Bi-Directional TVS Diode Array, 3-Pin SC-70                                                                                            1.1mm                          LITTELFUSE            SP1002-01JTG                       576-SP1002-01JTG   https://www.mouser.co.uk/ProductDetail/Littelfuse/SP1002-01JTG?qs=Xb8IjHhkxj6pIS6%252BgvMqKQ%3D%3D                                                                                                                                                    
HDR1   87831-1020        87831-1020        SHDR10W55P200_2X5_1265X630X640 Header 2.00mm Milli-Grid, vert, TH, 10w Molex MILLI-GRID Series, Series Number 87831, 2mm Pitch 10 Way 2 Row Straight PCB Header, Solder Termination, 2A                                                                                Header 2.00mm Milli-Grid, vert, TH, 10w Molex MILLI-GRID Series, Series Number 87831, 2mm Pitch 10 Way 2 Row Straight PCB Header, Solder Termination, 2A                     6.4mm                          Molex                 87831-1020                         538-87831-1020     https://www.mouser.co.uk/ProductDetail/Molex/87831-1020?qs=8PELaTI4Pt8k%2F%2FV9vKeYIg%3D%3D                                                                                                                                                           
IC1    TPS6306X          TPS6306X          S-PWSON-N10                    TPS6306x High Input Voltage, Buck-Boost Converter With 2-A Switch Current                                                                                                                                                                                                                                                                                                                                                   TI                                                                                                                                                                                                                                                           TPS6306X                                                                             TPS6306X
IC2    W25Q80DLSNIG_TR   W25Q80DLSNIG_TR   SOIC127P600X175-8N             2.5V AND 3V 8M-BIT SERIAL FLASH MEMORY WITH DUAL AND QUAD SPI                                                                                                                                                                           2.5V AND 3V 8M-BIT SERIAL FLASH MEMORY WITH DUAL AND QUAD SPI                                                                                                                1.75mm                         Winbond               W25Q80DLSNIG TR                    454-W25Q80DLSNIGTR https://www.mouser.co.uk/ProductDetail/Winbond/W25Q80DLSNIG-TR?qs=qSfuJ%252Bfl%2Fd4EQ3sPamYlCg%3D%3D                                                                                                                                                  
JP1                      PINHD-2X3/90      2X03/90                        PIN HEADER                                                                                                                                                                                                                                                                                                                                                                                                                                                                                                                                                                                                                                                                                                                 2                                                          
JP2                      RR0201            R0201                          RESISTOR, European symbol                                                                                                                                                                                                                                                                                                                                                                                                                                                                                                                                                                                                                                                                                                                         NONE       R                        
JP3                      RR0201            R0201                          RESISTOR, European symbol                                                                                                                                                                                                                                                                                                                                                                                                                                                                                                                                                                                                                                                                                                                         NONE       R                        
L1     1 uH              L0204/7           0204/7                         INDUCTOR, European symbol                                                                                                                                                                                                                                                                                                                                                                                                                                                                                                                                                                                                                                                                                                                         NONE       L                        
L2     2.2 uH            L-EUL3216C        L3216C                         INDUCTOR, European symbol                                                                                                                                                                                                                                                                                                                                                                                                                                                                                                                                                                                                                                                                                                  2                                 L                        
L3     2.2 uH            L-EUL3216C        L3216C                         INDUCTOR, European symbol                                                                                                                                                                                                                                                                                                                                                                                                                                                                                                                                                                                                                                                                                                  2                                 L                        
LED1   156120RS75000     156120RS75000     LEDM3216X130N                  Wurth Elektronik 156120RS75000, WL-SMRW Series Red LED, 624 nm, 3216 (1206) Clear, Rectangle Lens SMD Package                                                                                                                           Wurth Elektronik 156120RS75000, WL-SMRW Series Red LED, 624 nm, 3216 (1206) Clear, Rectangle Lens SMD Package                                                                1.3mm                          Wurth Elektronik      156120RS75000                      710-156120RS75000  https://www.mouser.co.uk/ProductDetail/Wurth-Elektronik/156120RS75000?qs=2kOmHSv6VfTlw4DhG%252BTIQw%3D%3D                                                                                                                                             
PB1    FSMSM             FSMSM             FSMSM                          Tactile switch,SMT,SPST,rect black act Black Button Tactile Switch, SPST 50 mA@ 24 V dc 1.07mm                                                                                                                                          Tactile switch,SMT,SPST,rect black act Black Button Tactile Switch, SPST 50 mA@ 24 V dc 1.07mm                                                                               mm                             TE Connectivity       FSMSM                              506-FSMSM          https://www.mouser.co.uk/ProductDetail/TE-Connectivity-Alcoswitch/FSMSM?qs=UhRTNahLC3yPLf3YjzjKAA%3D%3D                                                                                                                                               
Q1     FQU20N06LTU       FQU20N06LTU       TO229P250X658X985-3P           Trans MOSFET N-CH 60V 17.2A 3-Pin IPAK                                                                                                                                                                                                  Trans MOSFET N-CH 60V 17.2A 3-Pin IPAK                                                                                                                                       2.5mm                          ON Semiconductor      FQU20N06LTU                        512-FQU20N06LTU    https://www.mouser.co.uk/ProductDetail/ON-Semiconductor-Fairchild/FQU20N06LTU?qs=bfRUmXT2lZisvT2ROxlO3Q%3D%3D                                                                                                                                         
Q2     FQU20N06LTU       FQU20N06LTU       TO229P250X658X985-3P           Trans MOSFET N-CH 60V 17.2A 3-Pin IPAK                                                                                                                                                                                                  Trans MOSFET N-CH 60V 17.2A 3-Pin IPAK                                                                                                                                       2.5mm                          ON Semiconductor      FQU20N06LTU                        512-FQU20N06LTU    https://www.mouser.co.uk/ProductDetail/ON-Semiconductor-Fairchild/FQU20N06LTU?qs=bfRUmXT2lZisvT2ROxlO3Q%3D%3D                                                                                                                                         
Q3     FQU20N06LTU       FQU20N06LTU       TO229P250X658X985-3P           Trans MOSFET N-CH 60V 17.2A 3-Pin IPAK                                                                                                                                                                                                  Trans MOSFET N-CH 60V 17.2A 3-Pin IPAK                                                                                                                                       2.5mm                          ON Semiconductor      FQU20N06LTU                        512-FQU20N06LTU    https://www.mouser.co.uk/ProductDetail/ON-Semiconductor-Fairchild/FQU20N06LTU?qs=bfRUmXT2lZisvT2ROxlO3Q%3D%3D                                                                                                                                         
Q4     FQU20N06LTU       FQU20N06LTU       TO229P250X658X985-3P           Trans MOSFET N-CH 60V 17.2A 3-Pin IPAK                                                                                                                                                                                                  Trans MOSFET N-CH 60V 17.2A 3-Pin IPAK                                                                                                                                       2.5mm                          ON Semiconductor      FQU20N06LTU                        512-FQU20N06LTU    https://www.mouser.co.uk/ProductDetail/ON-Semiconductor-Fairchild/FQU20N06LTU?qs=bfRUmXT2lZisvT2ROxlO3Q%3D%3D                                                                                                                                         
Q5     DMN2004WK-7       DMN2004WK-7       SC70-3_DCK                                                                                                                                                                                                                                                                                                                                                                                                                                                                                                                                                                                                                                                                                                                                                                                                           
R1     100K              R-US_0207/10      0207/10                        RESISTOR, American symbol                                                                                                                                                                                                                                                                                                                                                                                                                                                                                                                                                                                                                                                                                                                                                             
R2     270               WSLP1206R0500FEA  RES_1206                       RES 0.05 OHM 1% 1W 1206                                                                                                                                                                                                   PCBLayout.com                                                                                                                                                          WSLP-.05TR-ND                    Vishay Dale                                                                                                                                                                                                 WSLP1206R0500FEA SMD 1206                                                                                                               
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
S1     EG1224            EG1224            EG1224                         E-SWITCH - EG1224 - SWITCH, SLIDE, SPDT, 500mA, 15V, PCB                                                                                                                                                                                E-SWITCH - EG1224 - SWITCH, SLIDE, SPDT, 500mA, 15V, PCB                                                                                                                     8.5mm                          E-Switch              EG1224                             612-EG1224         https://www.mouser.co.uk/ProductDetail/E-Switch/EG1224/?qs=HKd%2Fp3M7KlUMARNITVNimA%3D%3D                                                                                                                                                             
U2     Value             CC3200R1M2RGCR    RGC0064A                                                                                                                                                                                CC3200R1M2RGC                                           IC                                                                                                                                                                                                               Texas Instruments                                                SMT                                                                                                                                                                  RGC0064A                  CC3200R1M2RGCR 65                   RefDes Y                           TYPE Value   
U3     LTP5902           LTP5902           LTP5902-MMCX                                                                                                                                                                                                                                                                                                                                                                                                                                                                                                                                                                                                                                                                                                                                                                                                         
U4     WIND              WIND              WIND                                                                                                                                                                                                                                                                                                                                                                                                                                                                                                                                                                                                                                                                                                                                                                                                                 
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
Y1     32.768 KHz        KX-13             7.0X5.0                        Quartz Crystals (MHz) SMD:
