ECE-412-Capstone-Sensor-Suite/Team-20-Sensor-Suite/Design Files/mote+cc3200v8.pdf

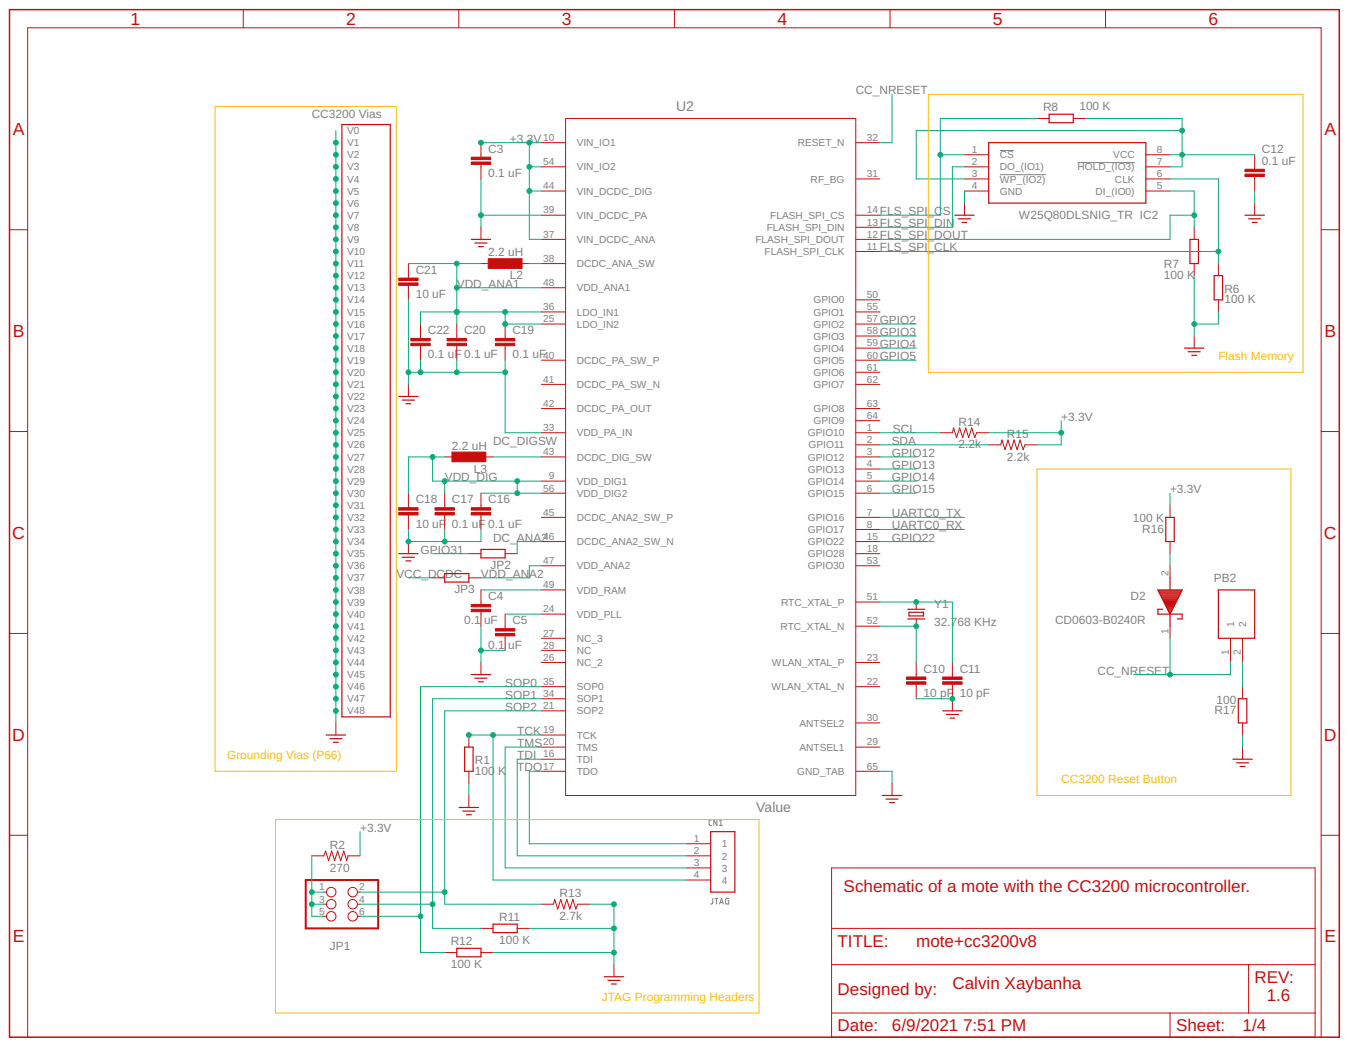
[picture p70: page 1]

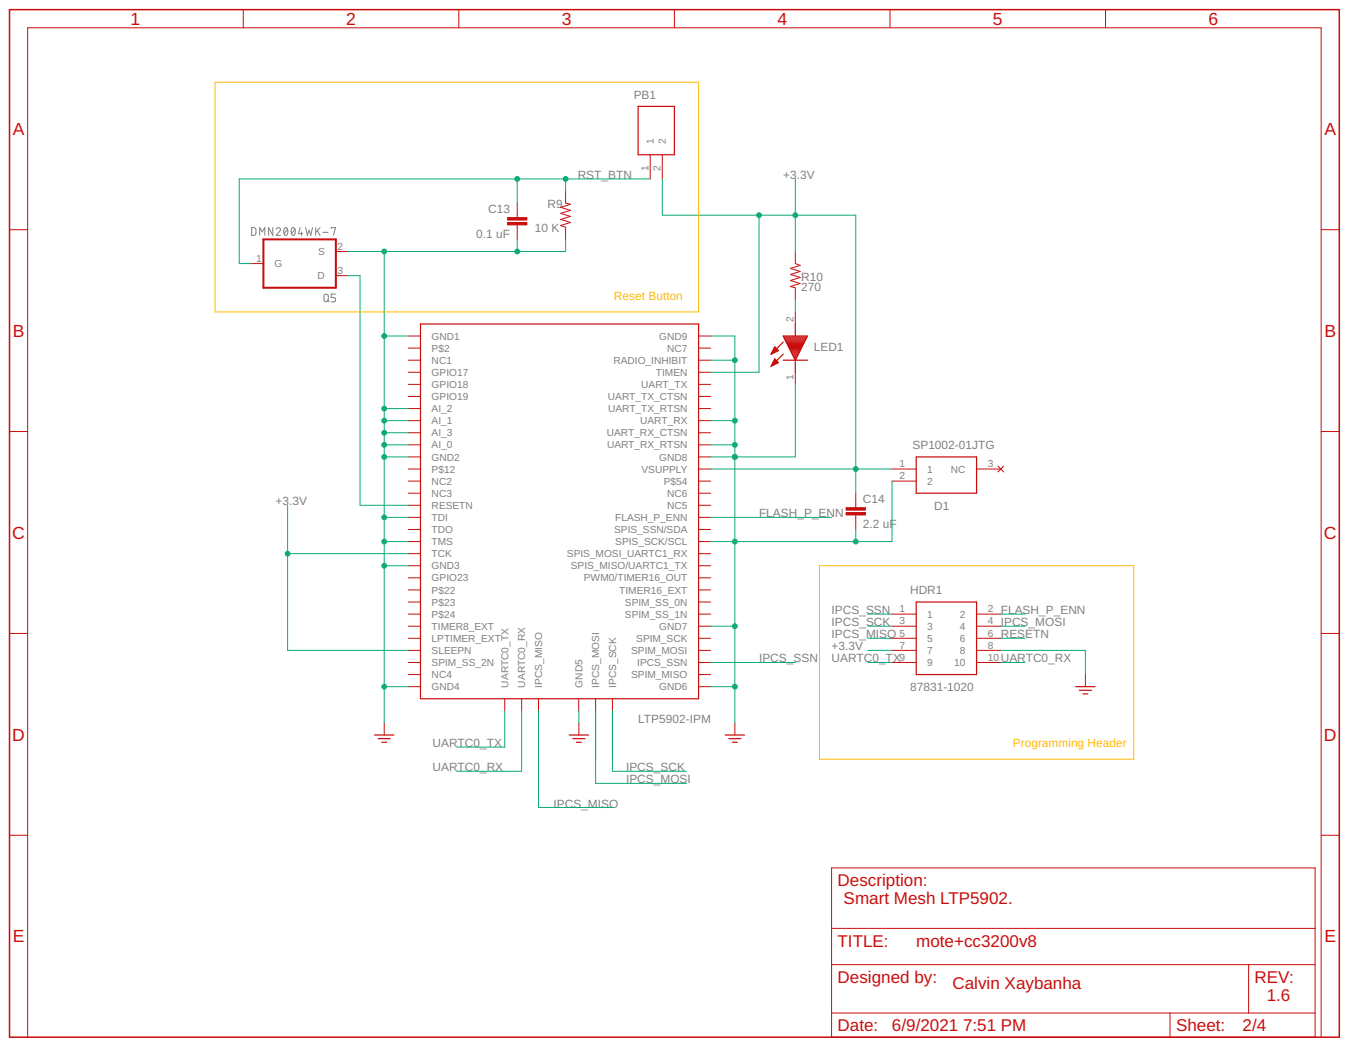
[picture p71: page 2]

Designed by: Calvin Xaybanha | REV: 1.6

Date: 6/9/2021 7:51 PM | Sheet: 2/4

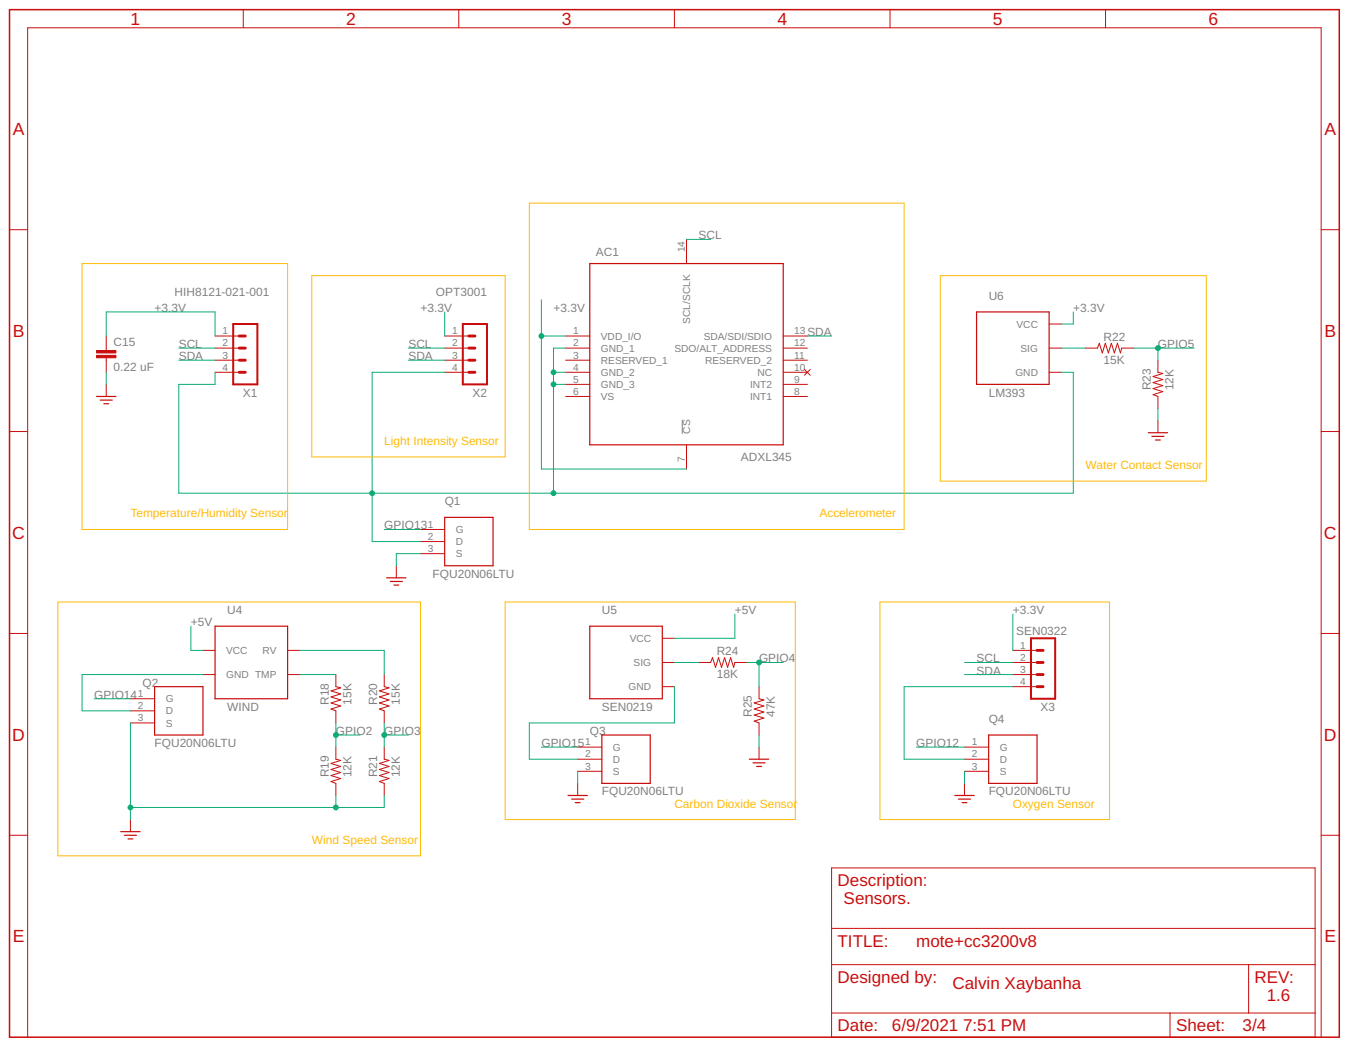
[picture p72: page 3]

Designed by: Calvin Xaybanha | REV: 1.6

Date: 6/9/2021 7:51 PM | Sheet: 3/4

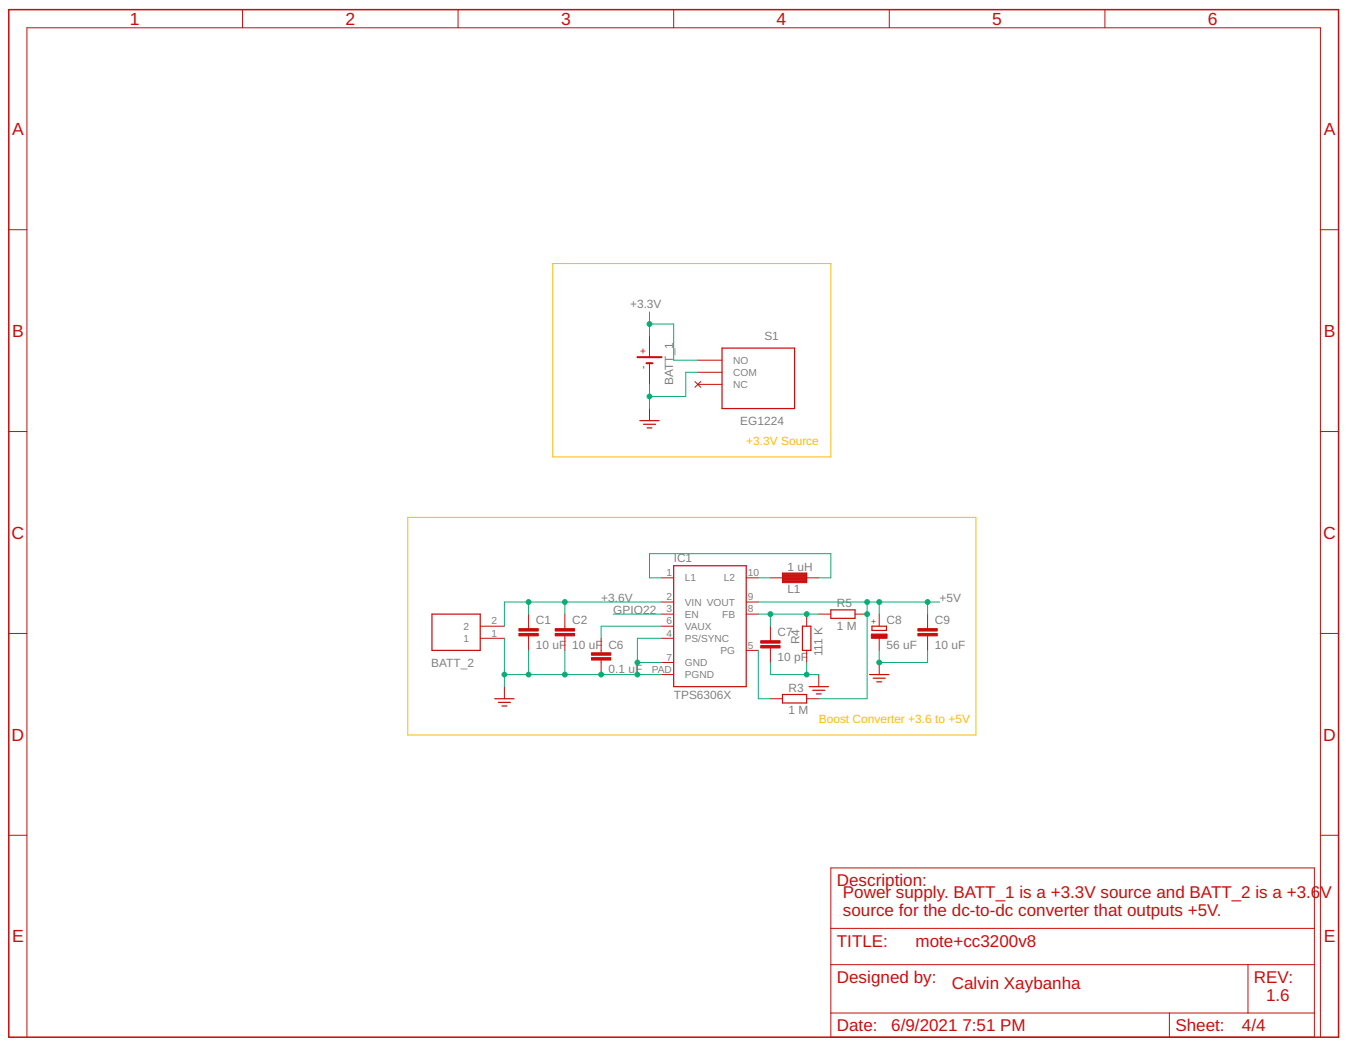
[picture p73: page 4]

Description:
Power supply. BATT_1 is a +3.3V source and BATT_2 is a +3.6V
source for the dc-to-dc converter that outputs +5V.

Designed by: Calvin Xaybanha | REV: 1.6

Date: 6/9/2021 7:51 PM | Sheet: 4/4
