ECE-412-Capstone-Sensor-Suite/Team-20-Sensor-Suite/Design Files/mote+cc3200v7.pdf

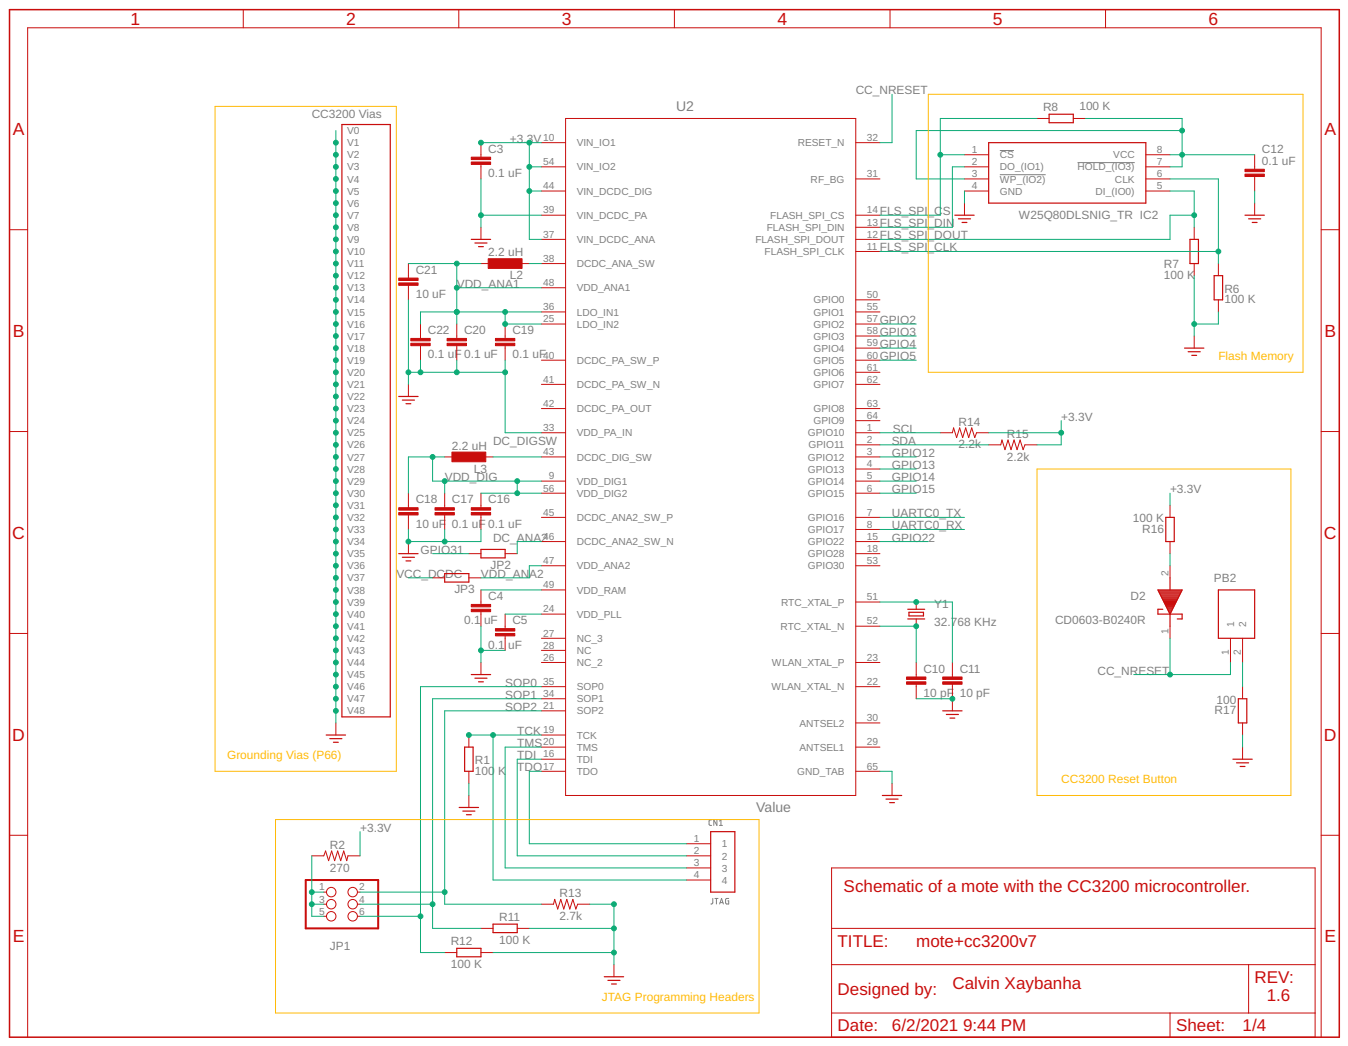
[picture p74: page 1]

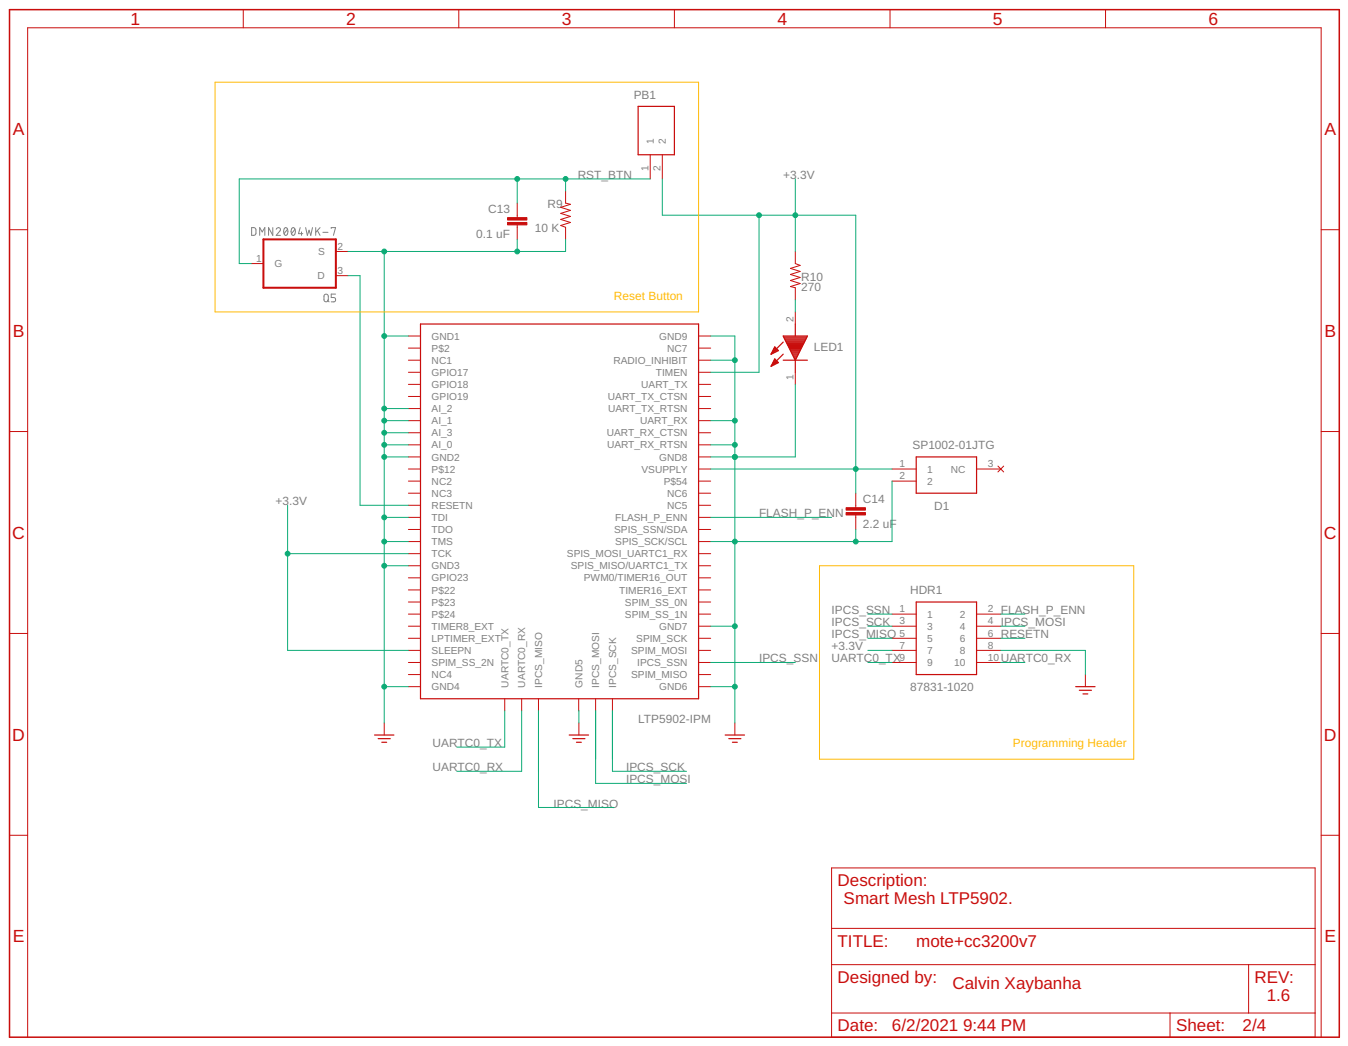
[picture p75: page 2]

Designed by: Calvin Xaybanha | REV: 1.6

Date: 6/2/2021 9:44 PM | Sheet: 2/4

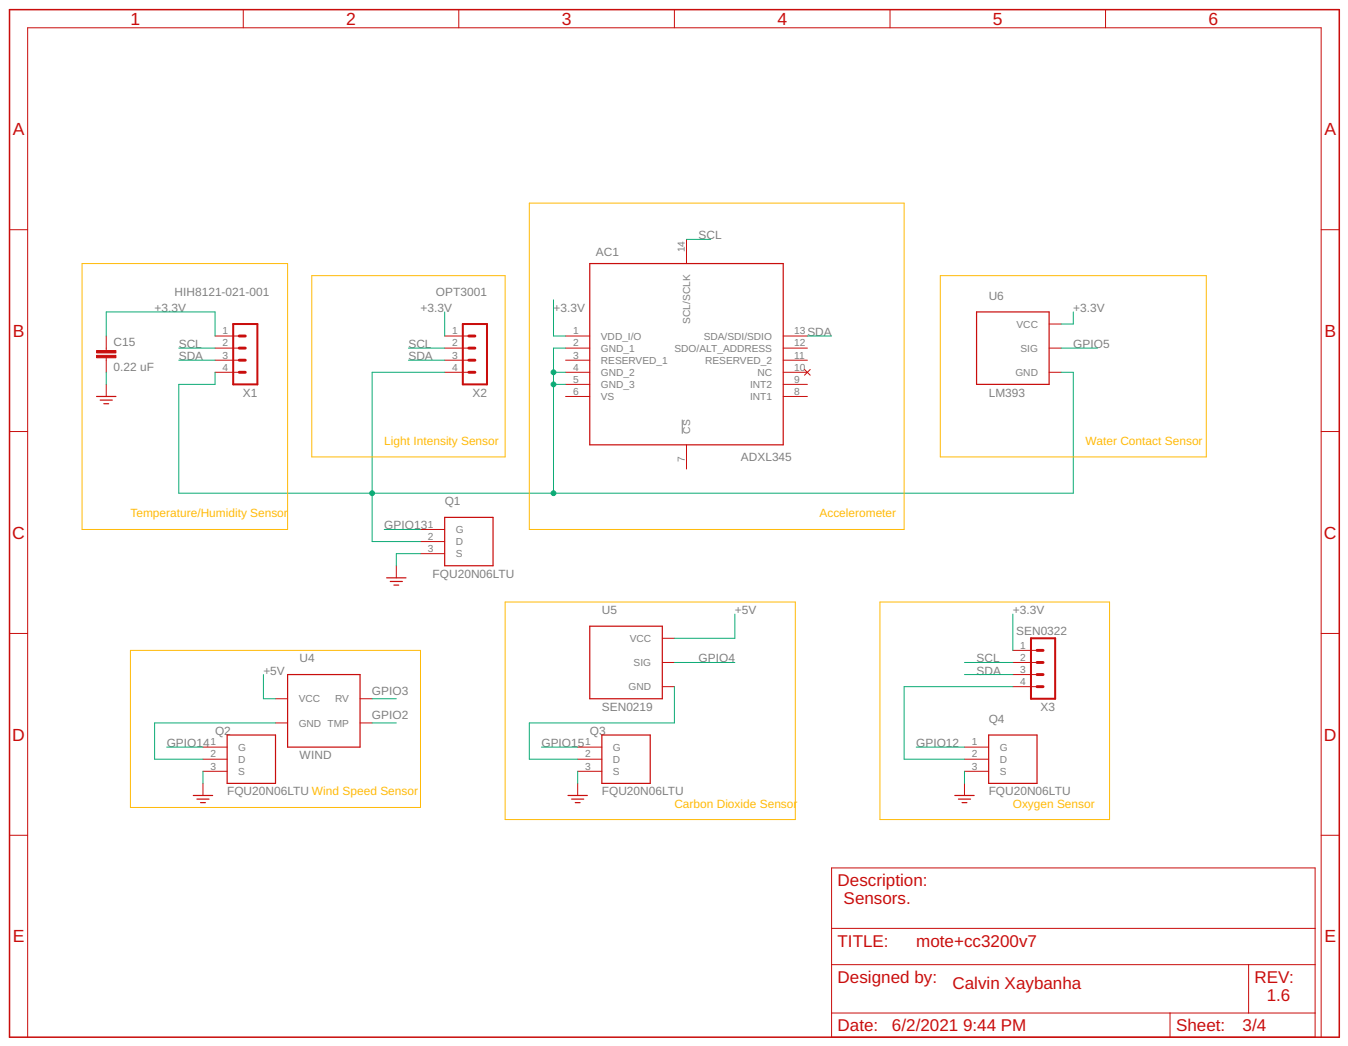
[picture p76: page 3]

Designed by: Calvin Xaybanha | REV: 1.6

Date: 6/2/2021 9:44 PM | Sheet: 3/4

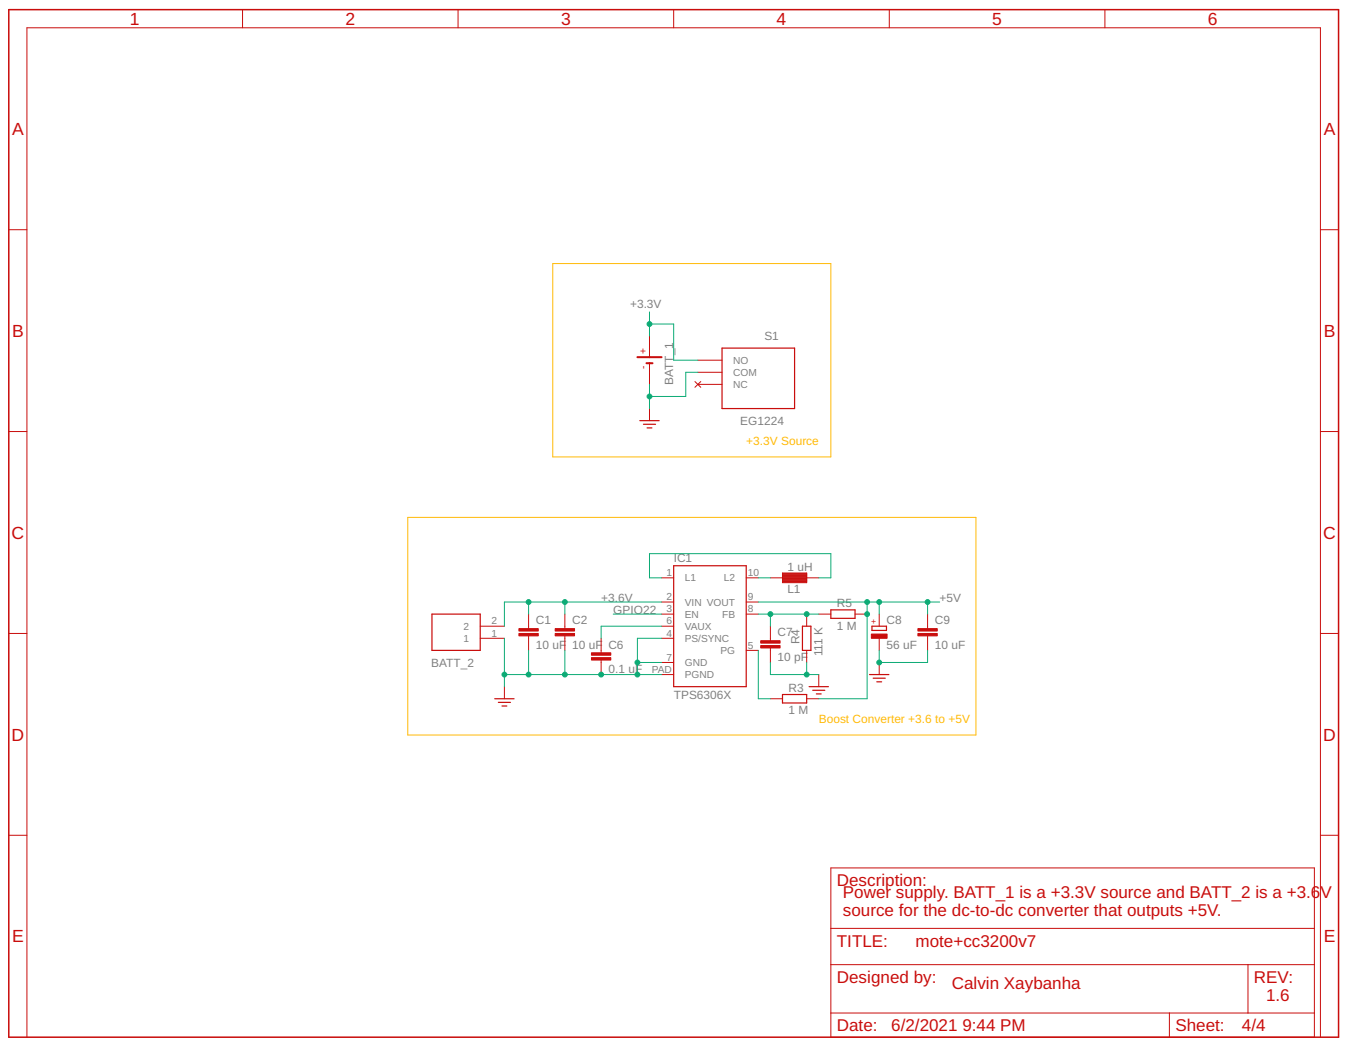
[picture p77: page 4]

Description:
Power supply. BATT_1 is a +3.3V source and BATT_2 is a +3.6V
source for the dc-to-dc converter that outputs +5V.

Designed by: Calvin Xaybanha | REV: 1.6

Date: 6/2/2021 9:44 PM | Sheet: 4/4
