ECE-412-Capstone-Sensor-Suite/Team-20-Sensor-Suite/Design Files/mote+cc3200v6.pdf

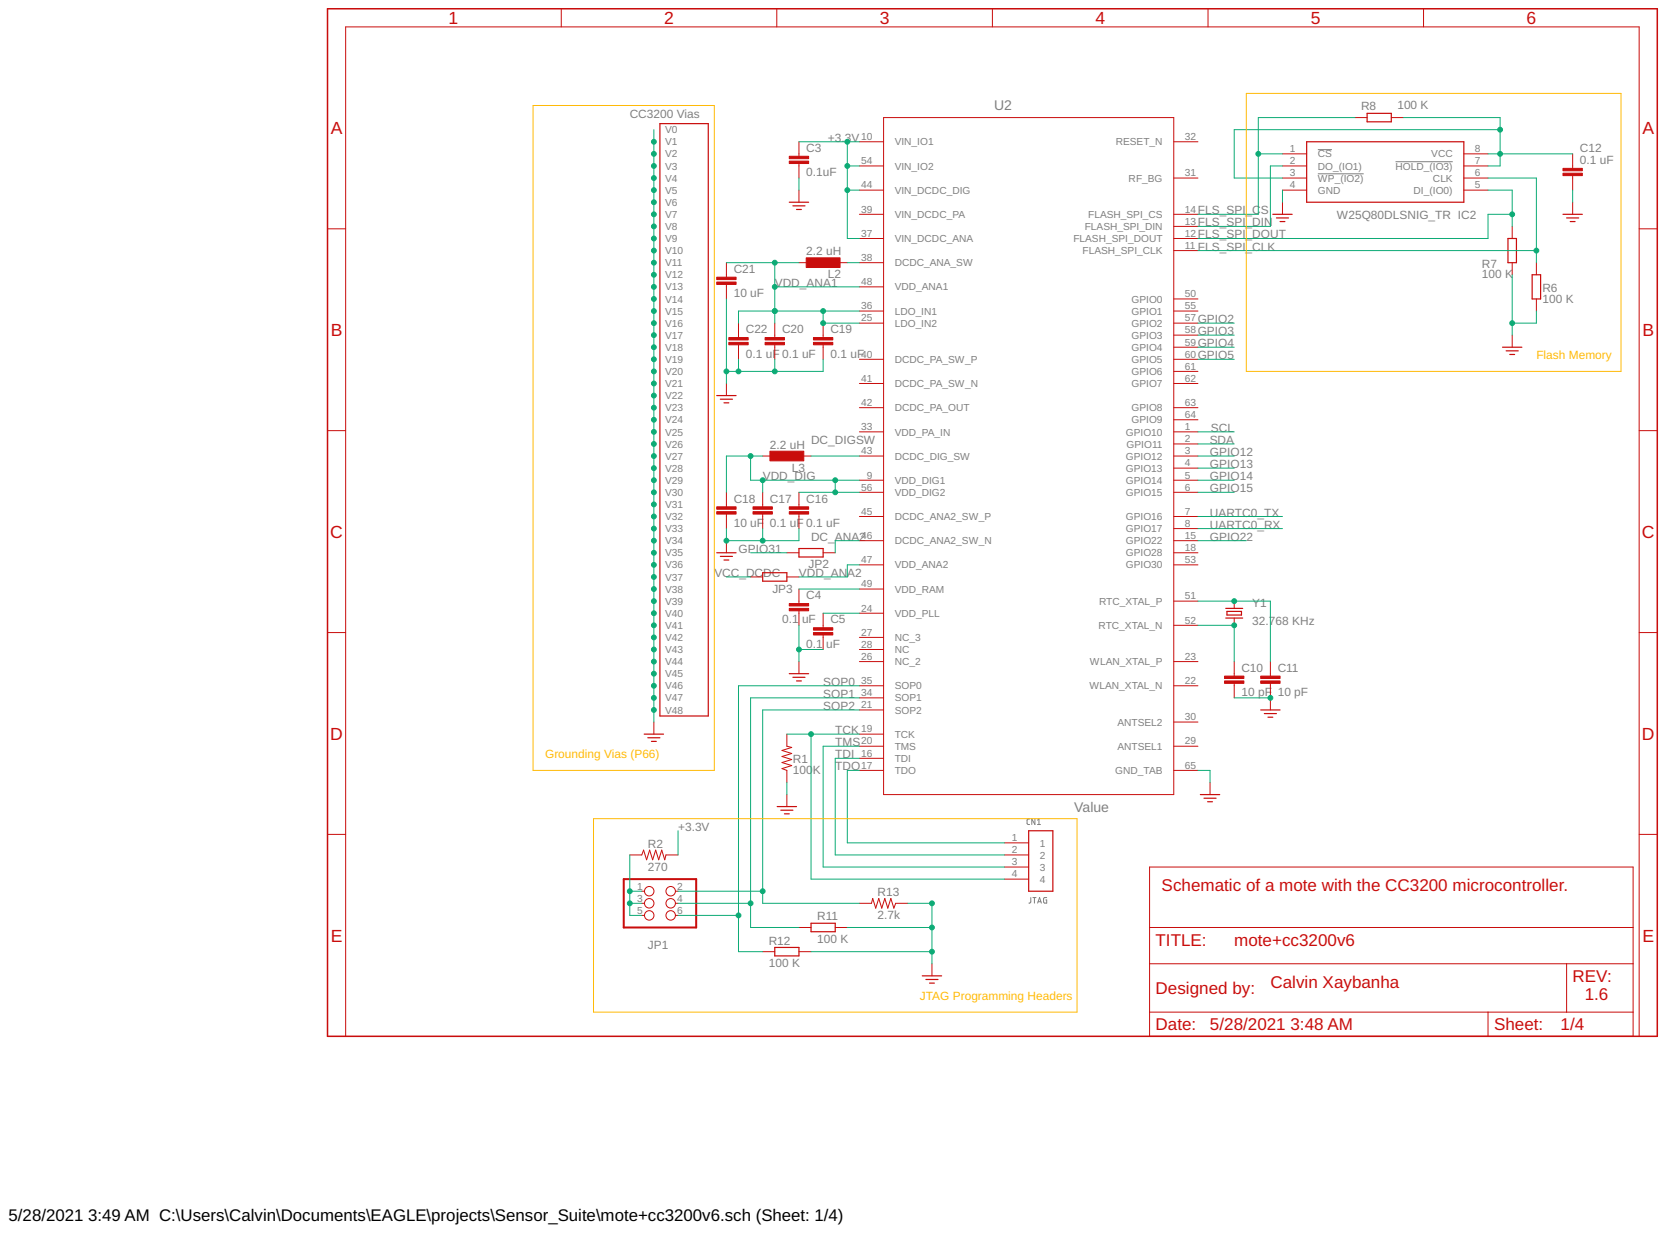
[picture p78: page 1]

50 55 57 GPIO3 GPIO2

Designed by: | REV:

Date: 5/28/2021 3:48 AM | Sheet: 1/4

5/28/2021 3:49 AM C:\Users\Calvin\Documents\EAGLE\projects\Sensor_Suite\mote+cc3200v6.sch (Sheet: 1/4)

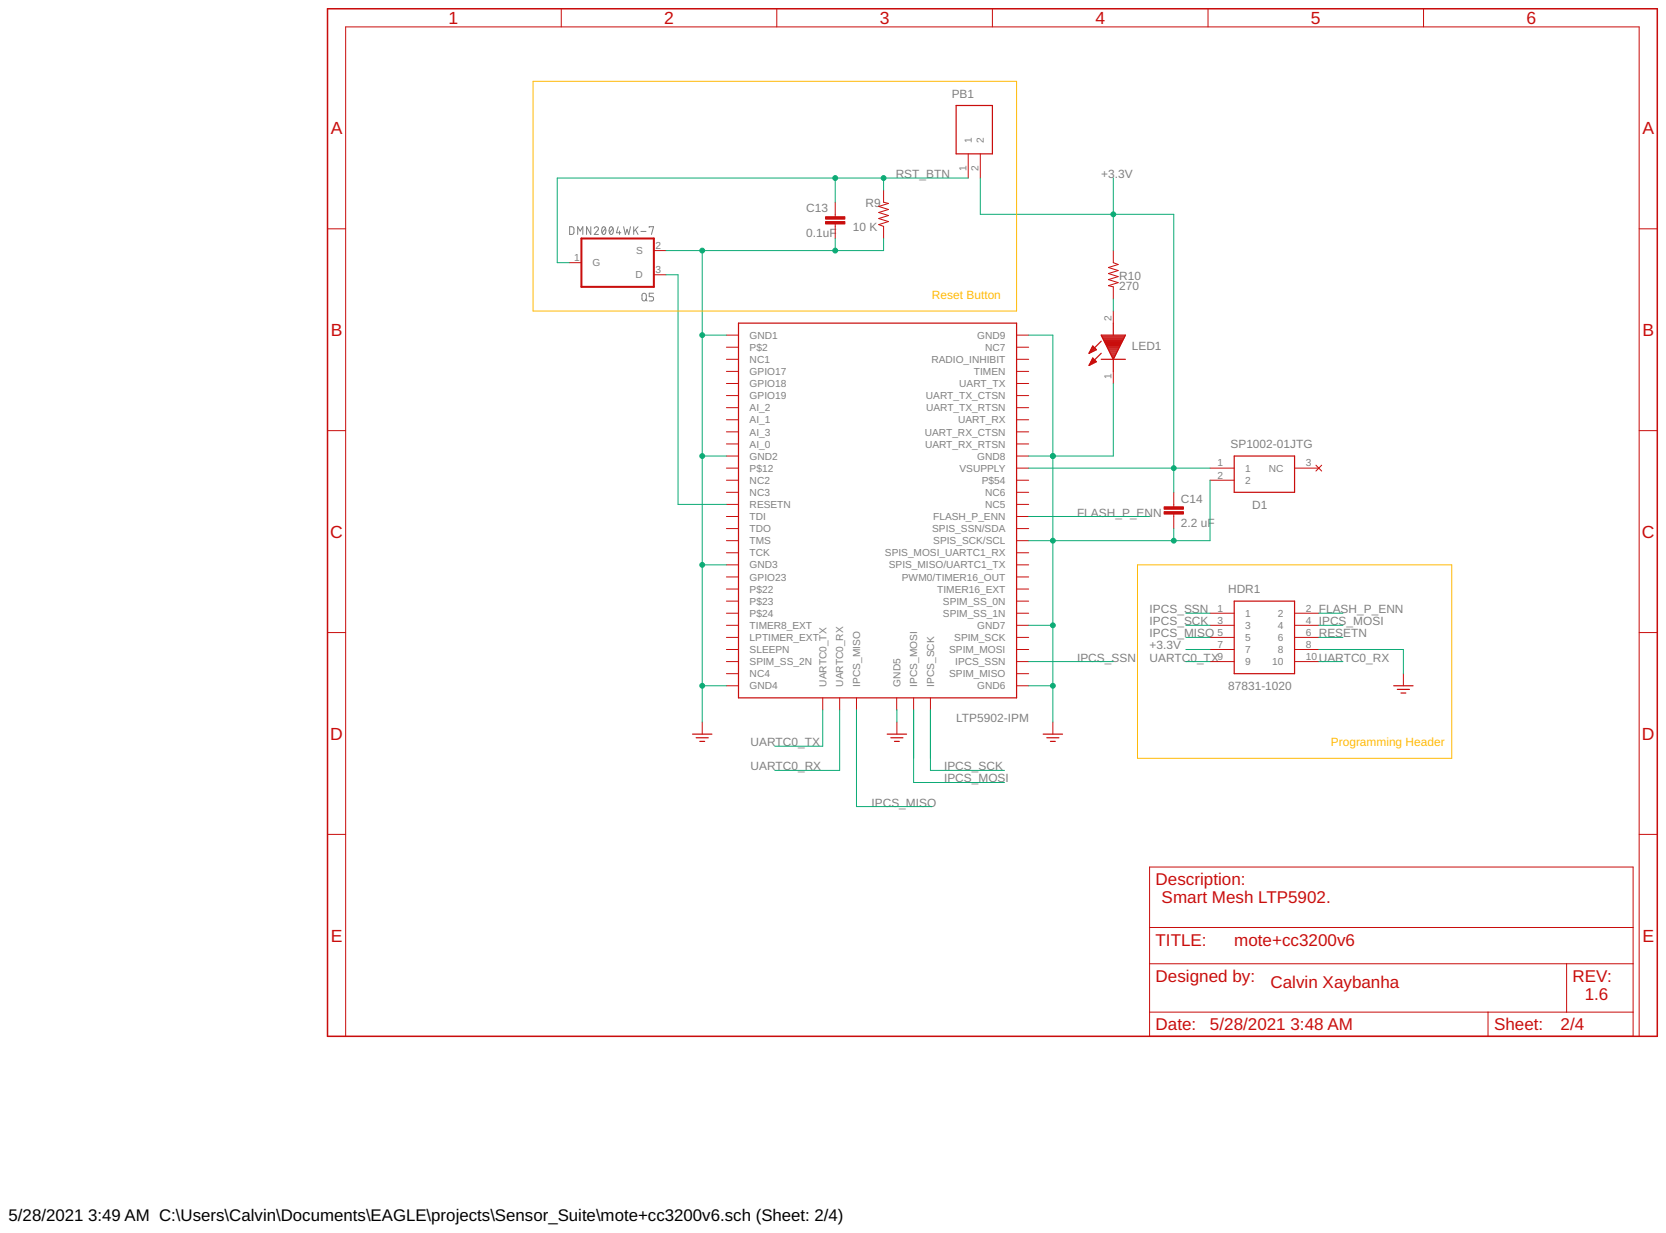
[picture p79: page 2]

Designed by: Calvin Xaybanha | REV: 1.6

Date: 5/28/2021 3:48 AM | Sheet: 2/4

5/28/2021 3:49 AM C:\Users\Calvin\Documents\EAGLE\projects\Sensor_Suite\mote+cc3200v6.sch (Sheet: 2/4)

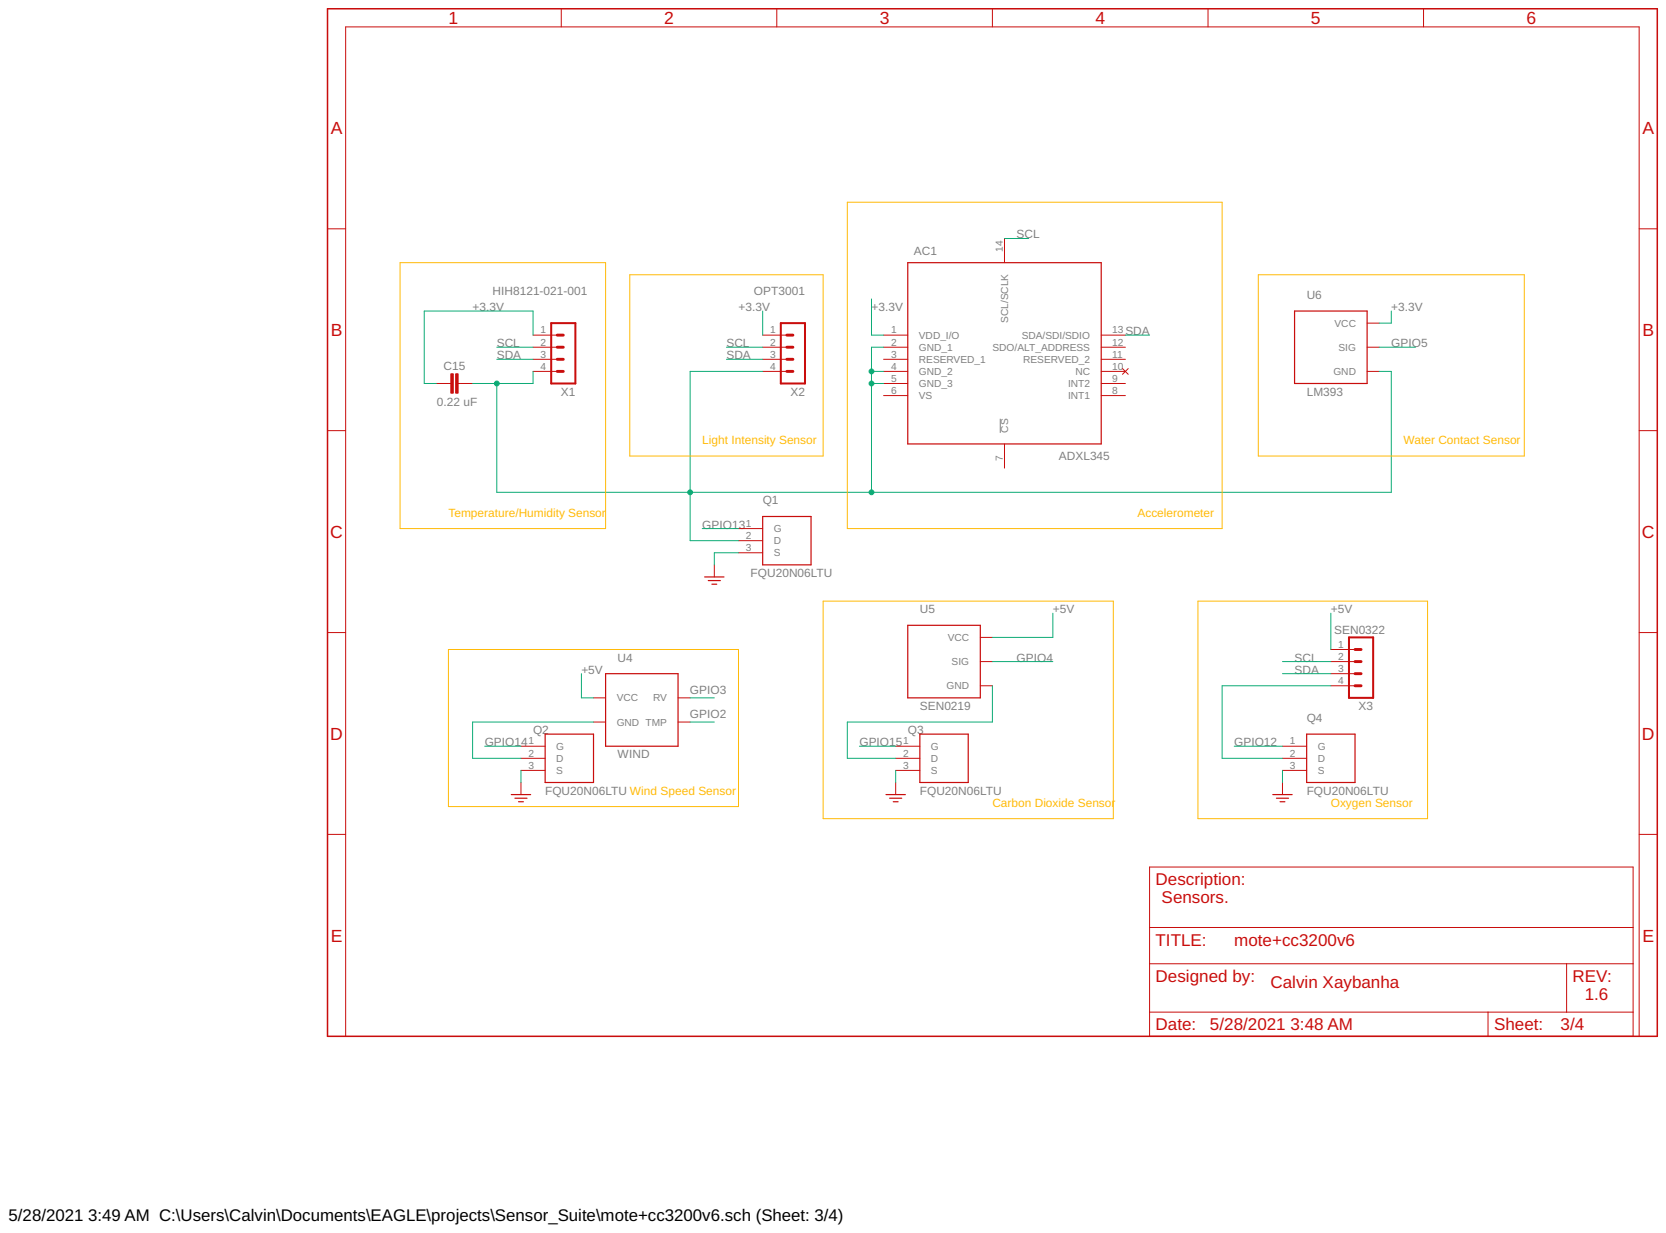
[picture p80: page 3]

Designed by: Calvin Xaybanha | REV: 1.6

Date: 5/28/2021 3:48 AM | Sheet: 3/4

5/28/2021 3:49 AM C:\Users\Calvin\Documents\EAGLE\projects\Sensor_Suite\mote+cc3200v6.sch (Sheet: 3/4)

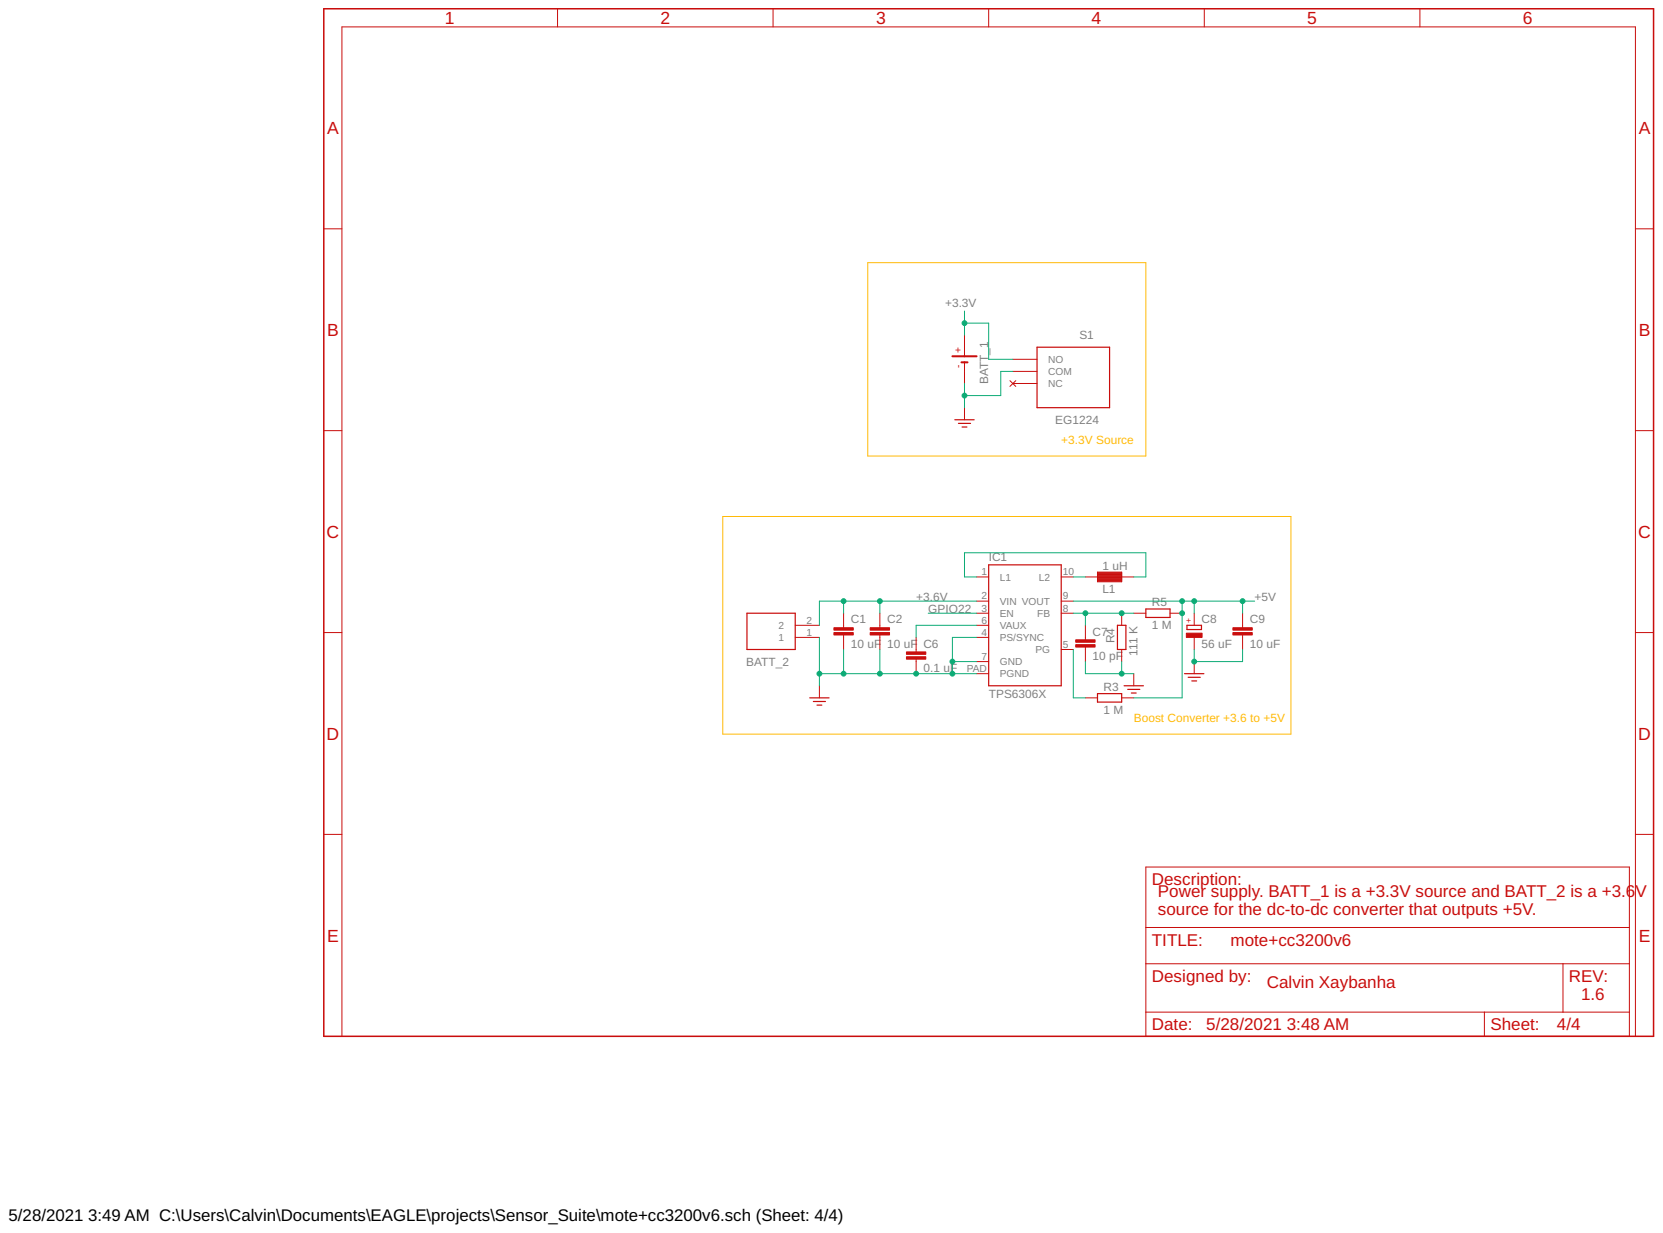
[picture p81: page 4]

Description:
Power supply. BATT_1 is a +3.3V source and BATT_2 is a +3.6V
source for the dc-to-dc converter that outputs +5V.

Designed by: Calvin Xaybanha | REV: 1.6

Date: 5/28/2021 3:48 AM | Sheet: 4/4

5/28/2021 3:49 AM C:\Users\Calvin\Documents\EAGLE\projects\Sensor_Suite\mote+cc3200v6.sch (Sheet: 4/4)
