ECE-412-Capstone-Sensor-Suite/Team-20-Sensor-Suite/Design Files/mote+cc3200v6_board.pdf

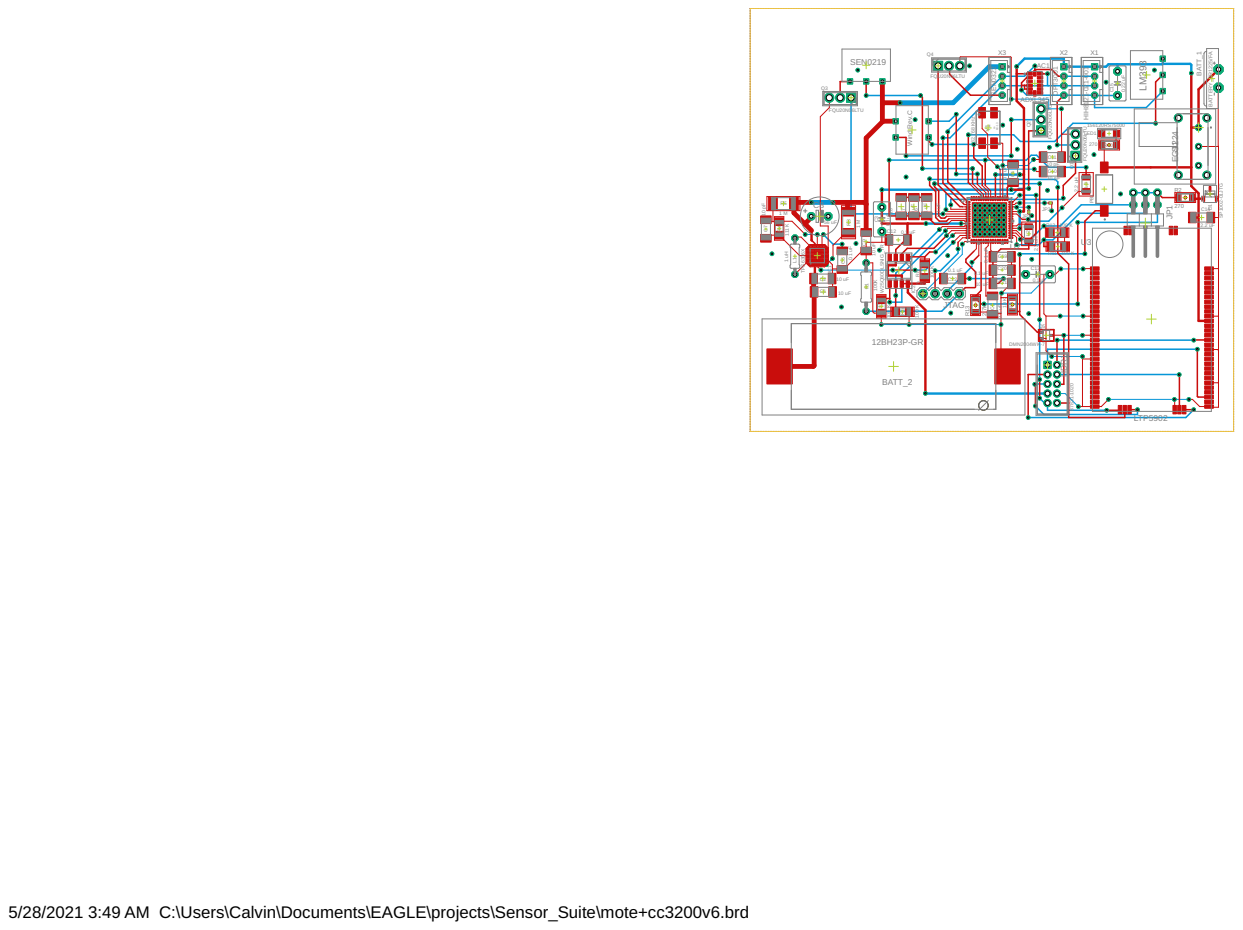
[picture p82: page 1]

5/28/2021 3:49 AM C:\Users\Calvin\Documents\EAGLE\projects\Sensor_Suite\mote+cc3200v6.brd
