ECE-412-Capstone-Sensor-Suite/Team-20-Sensor-Suite/Design Files/mote+cc3200.pdf

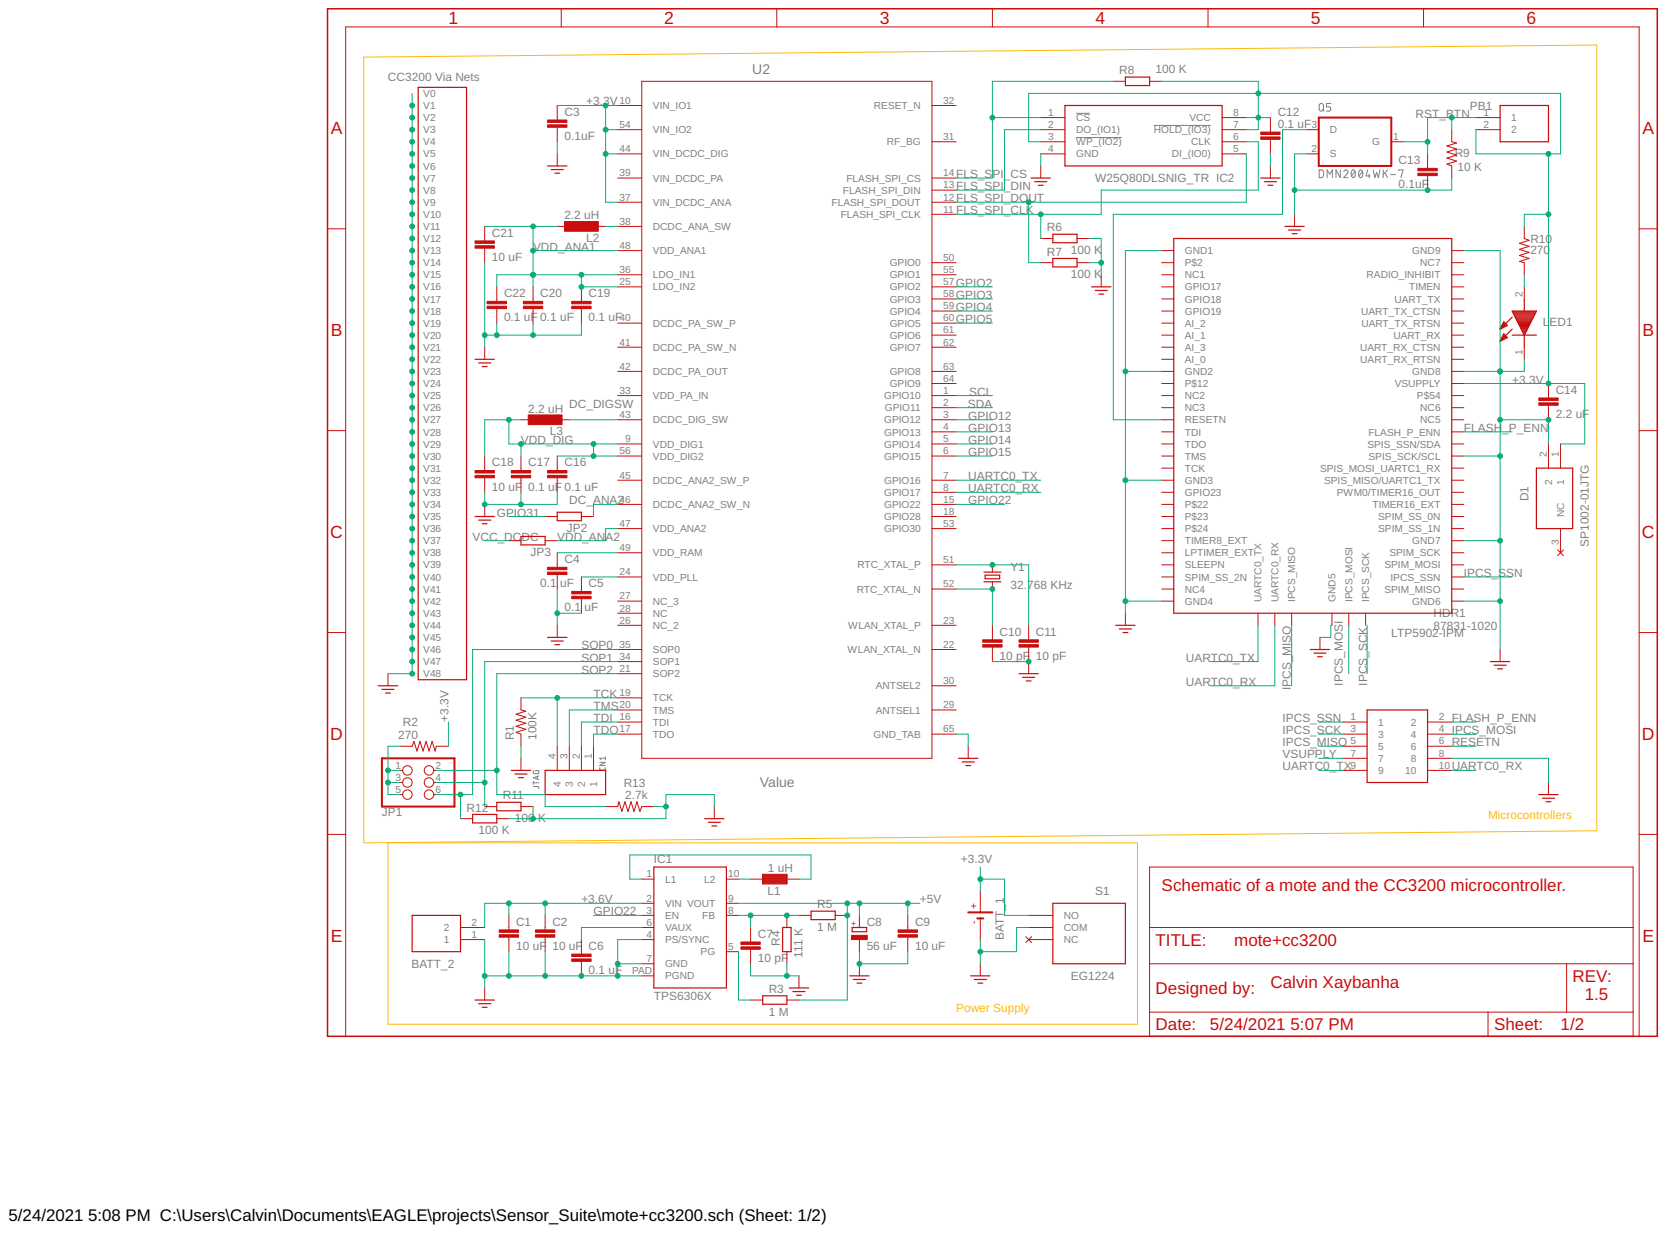
[picture p83: page 1]

11 FLASH_SPI_DOUT FLS_SPI_CLK

Date: 5/24/2021 5:07 PM | Sheet: 1/2

5/24/2021 5:08 PM C:\Users\Calvin\Documents\EAGLE\projects\Sensor_Suite\mote+cc3200.sch (Sheet: 1/2)

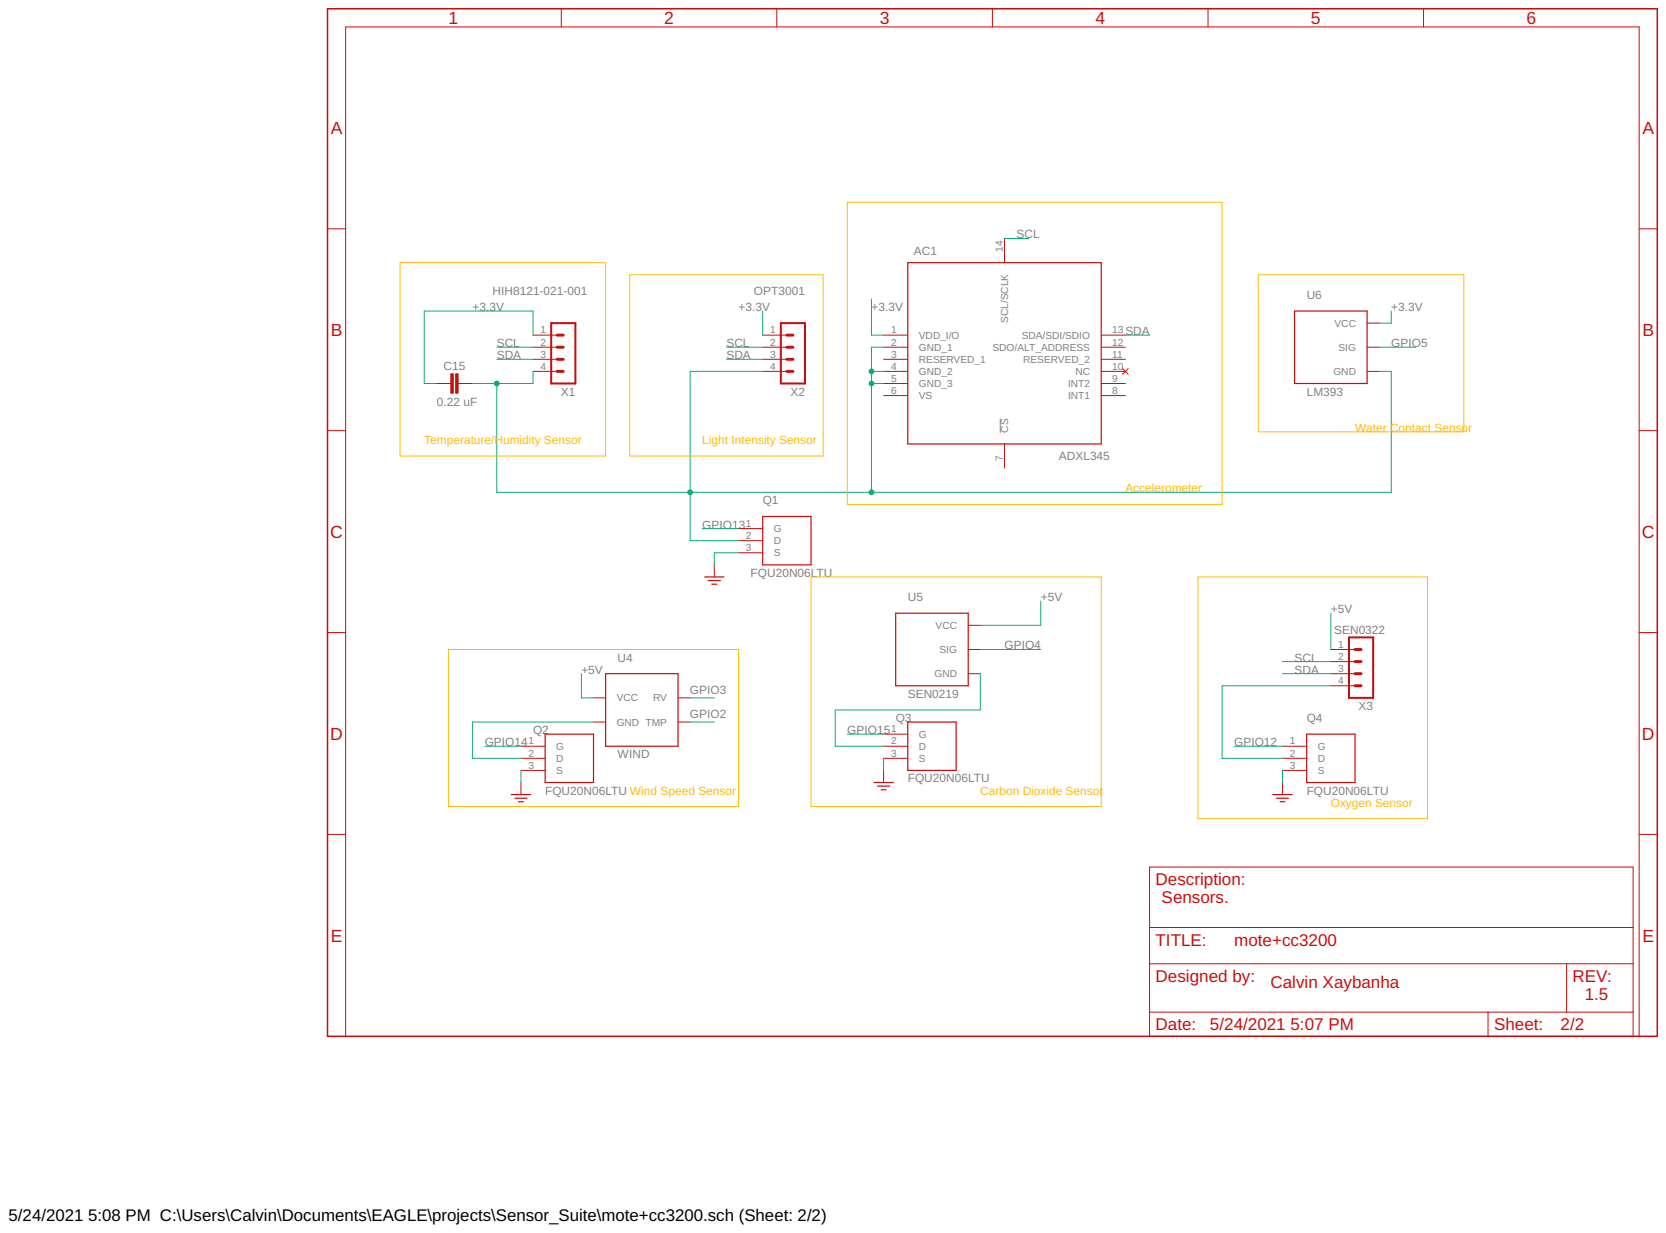
[picture p84: page 2]

Designed by: Calvin Xaybanha | REV: 1.5

Date: 5/24/2021 5:07 PM | Sheet: 2/2

5/24/2021 5:08 PM C:\Users\Calvin\Documents\EAGLE\projects\Sensor_Suite\mote+cc3200.sch (Sheet: 2/2)
