ECE-412-Capstone-Sensor-Suite/Team-20-Sensor-Suite/Design Files/mote+cc3200_board.pdf

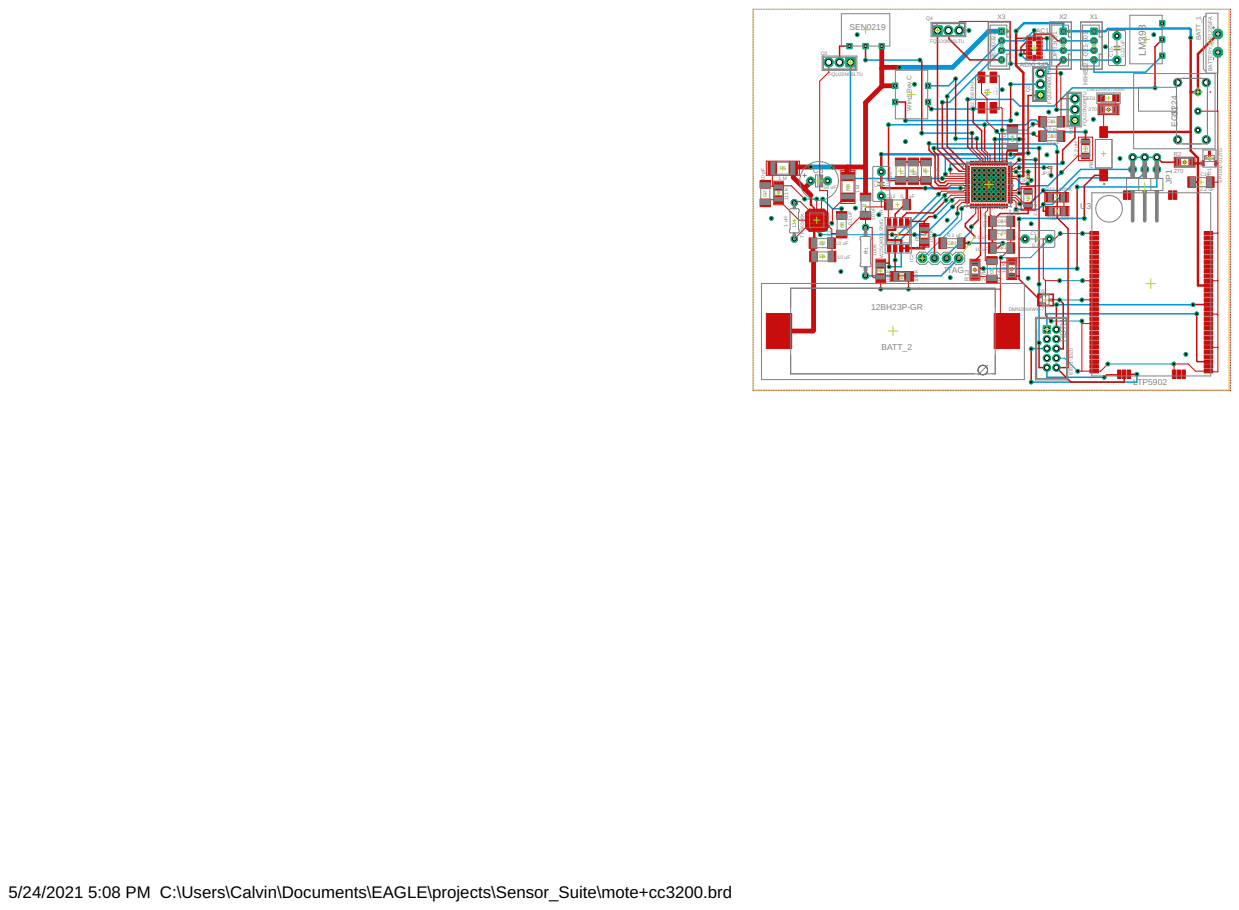
[picture p85: page 1]

5/24/2021 5:08 PM C:\Users\Calvin\Documents\EAGLE\projects\Sensor_Suite\mote+cc3200.brd
