ECE-412-Capstone-Sensor-Suite/Team-20-Sensor-Suite/Design Files/mote+cc3200v4.pdf

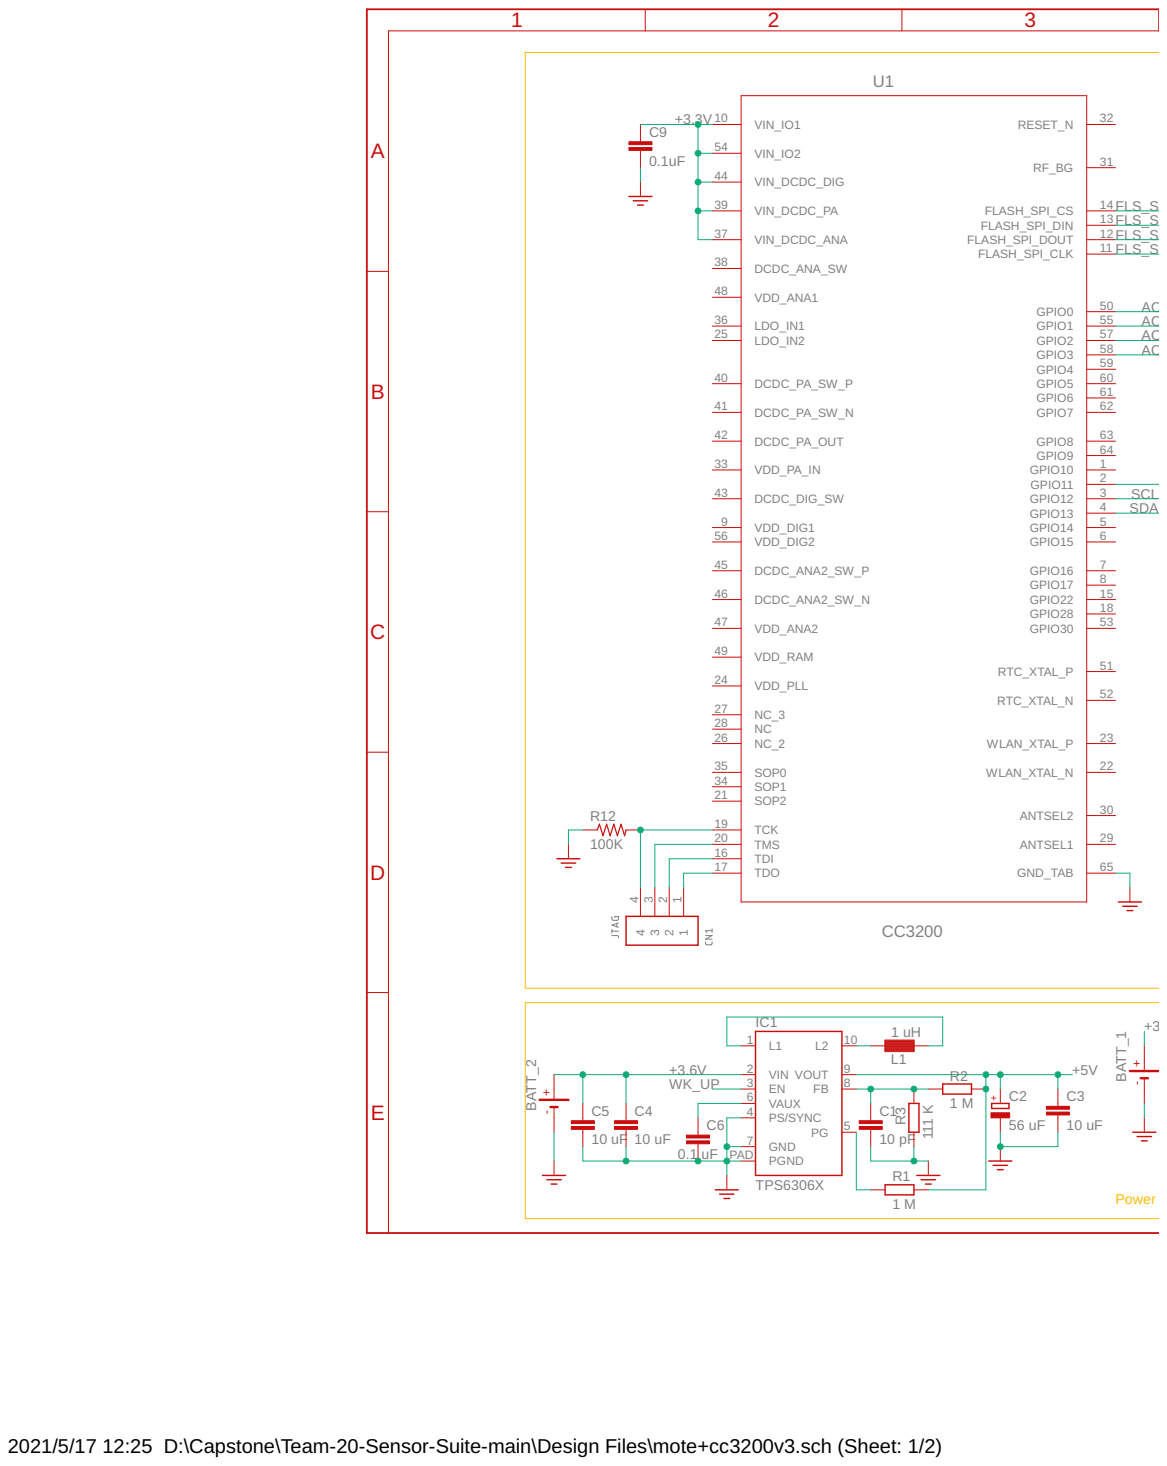
[picture p86: page 1]

2021/5/17 12:25 D:\Capstone\Team-20-Sensor-Suite-main\Design Files\mote+cc3200v3.sch (Sheet: 1/2)

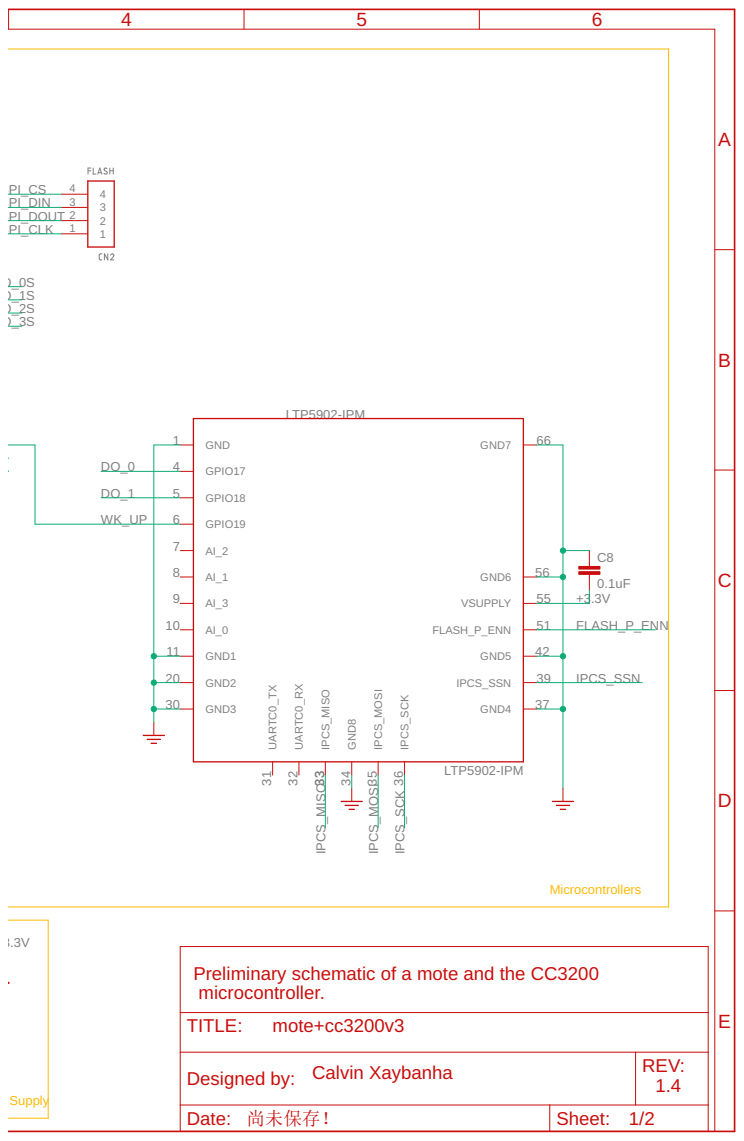
[picture p87: page 2]

Preliminary schematic of a mote and the CC3200

Calvin Xaybanha Designed by: | REV:

Date: 尚未保存！ | Sheet: 1/2
