ECE-412-Capstone-Sensor-Suite/Team-20-Sensor-Suite/Design Files/schematic1.pdf

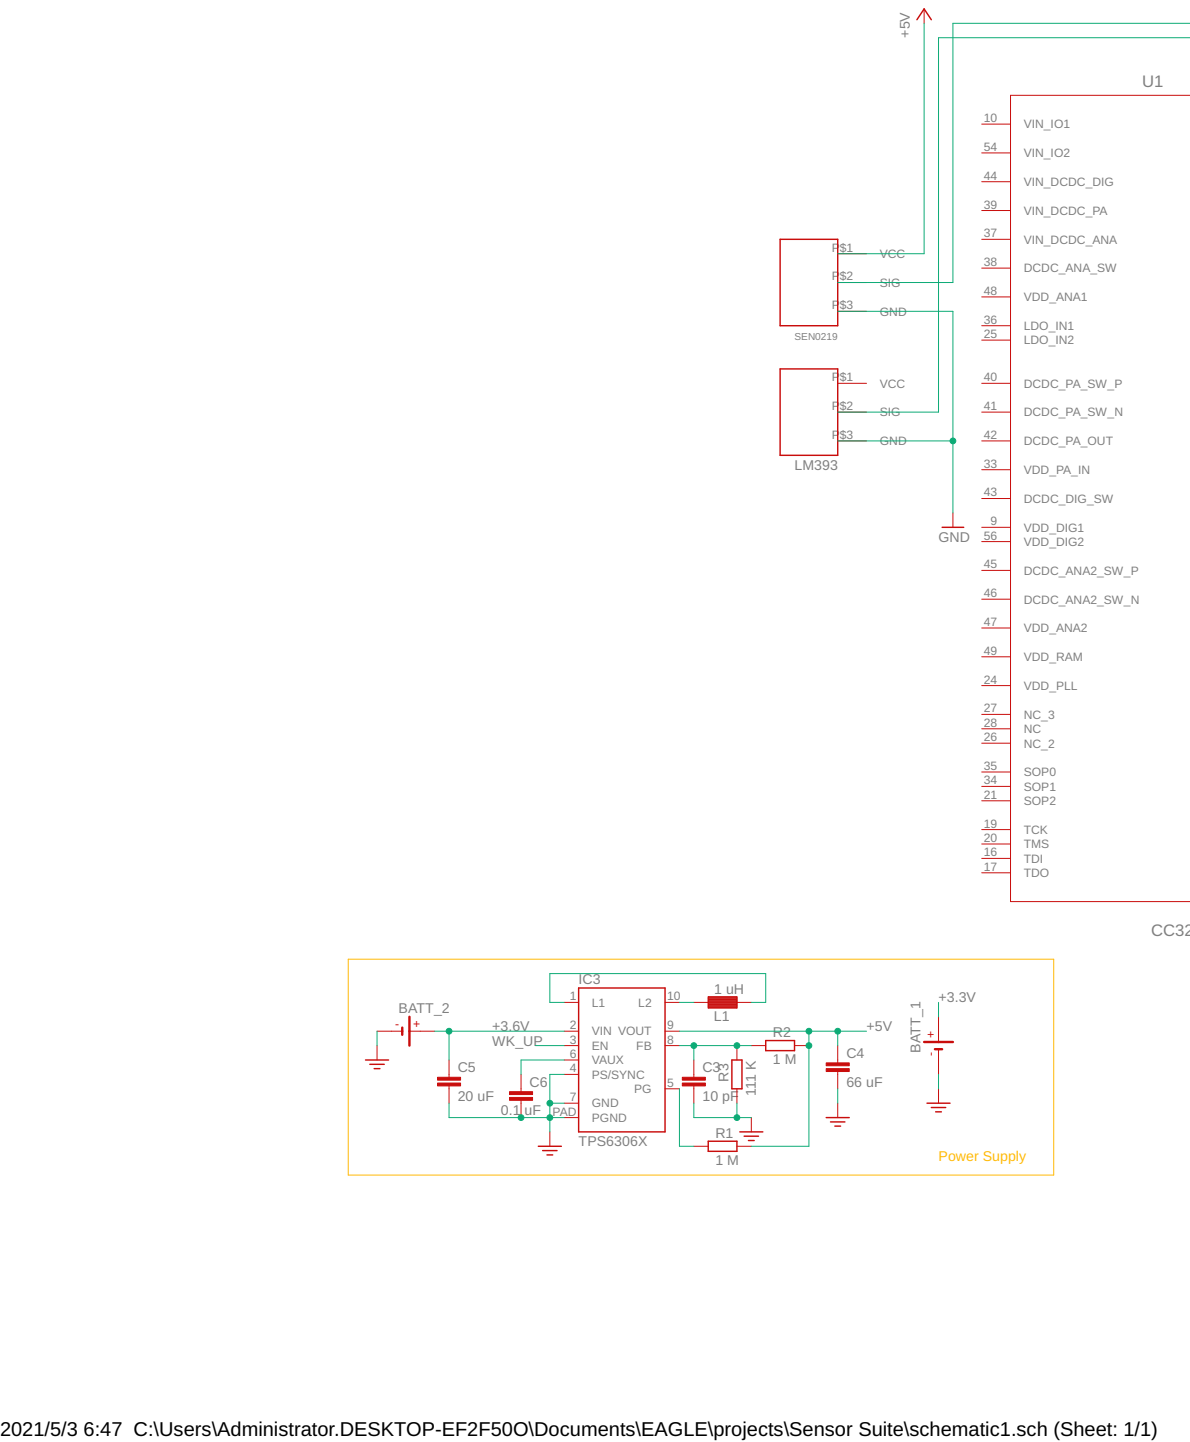
[picture p88: page 1]

2021/5/3 6:47 C:\Users\Administrator.DESKTOP-EF2F50O\Documents\EAGLE\projects\Sensor Suite\schematic1.sch (Sheet: 1/1)

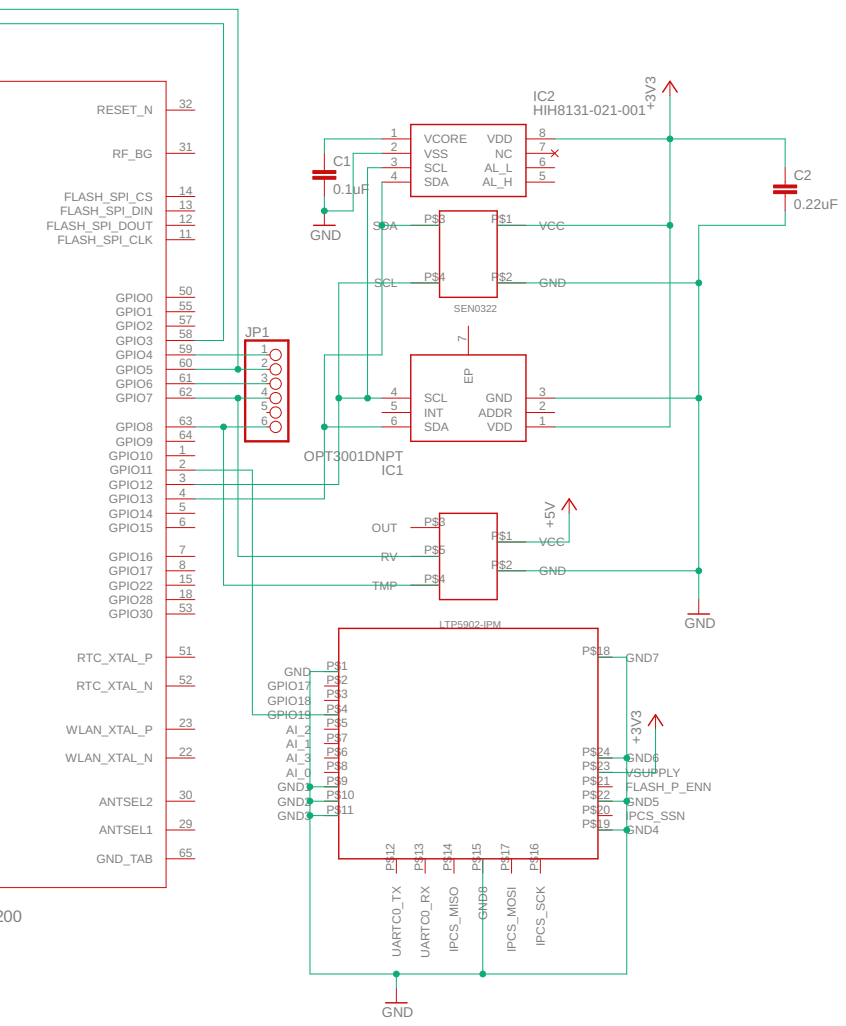
[picture p89: page 2]
