ECE-412-Capstone-Sensor-Suite/Team-20-Sensor-Suite/Design Files/mote+cc3200v7_board.pdf

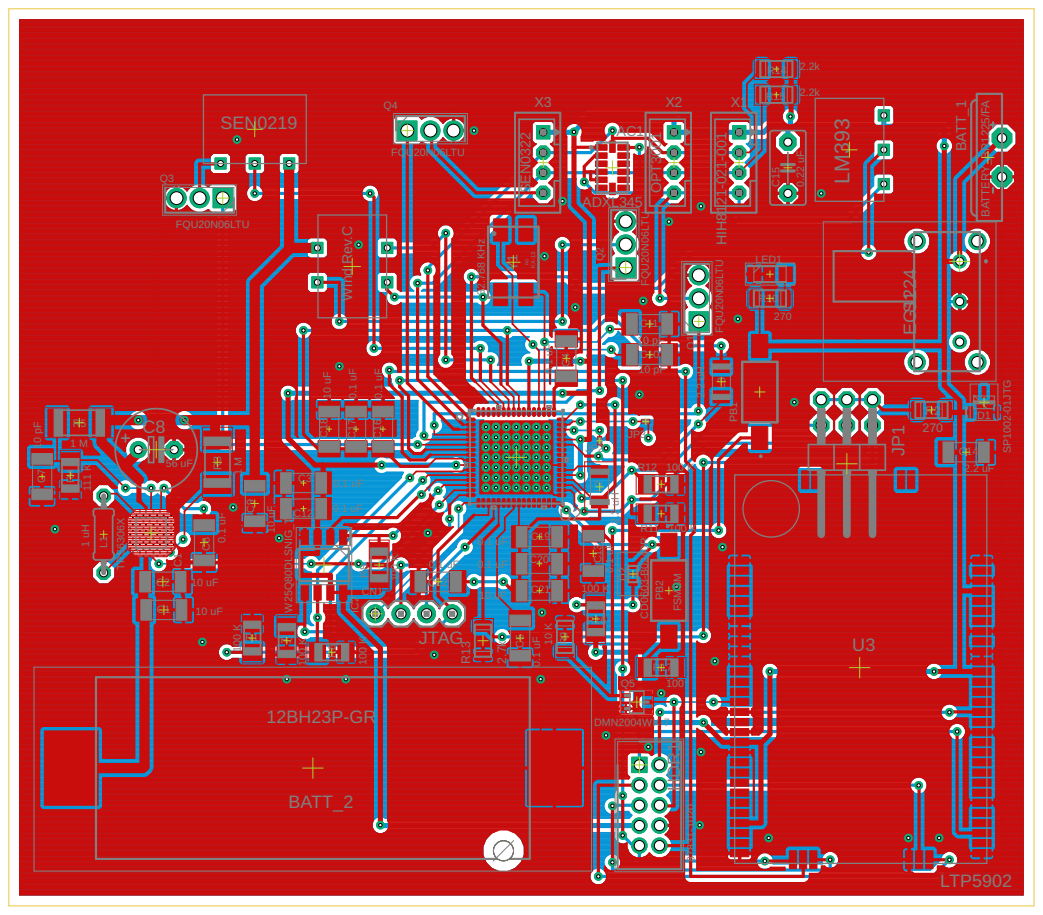
[picture p91: page 1]

56 uF 0.1 uF JTAG | 2.2 uF
