ECE-412-Capstone-Sensor-Suite/Team-20-Sensor-Suite/Design Files/mote+cc3200v8.brd

## EAGLE design Design Files/mote+cc3200v8.brd (2021-06-11)

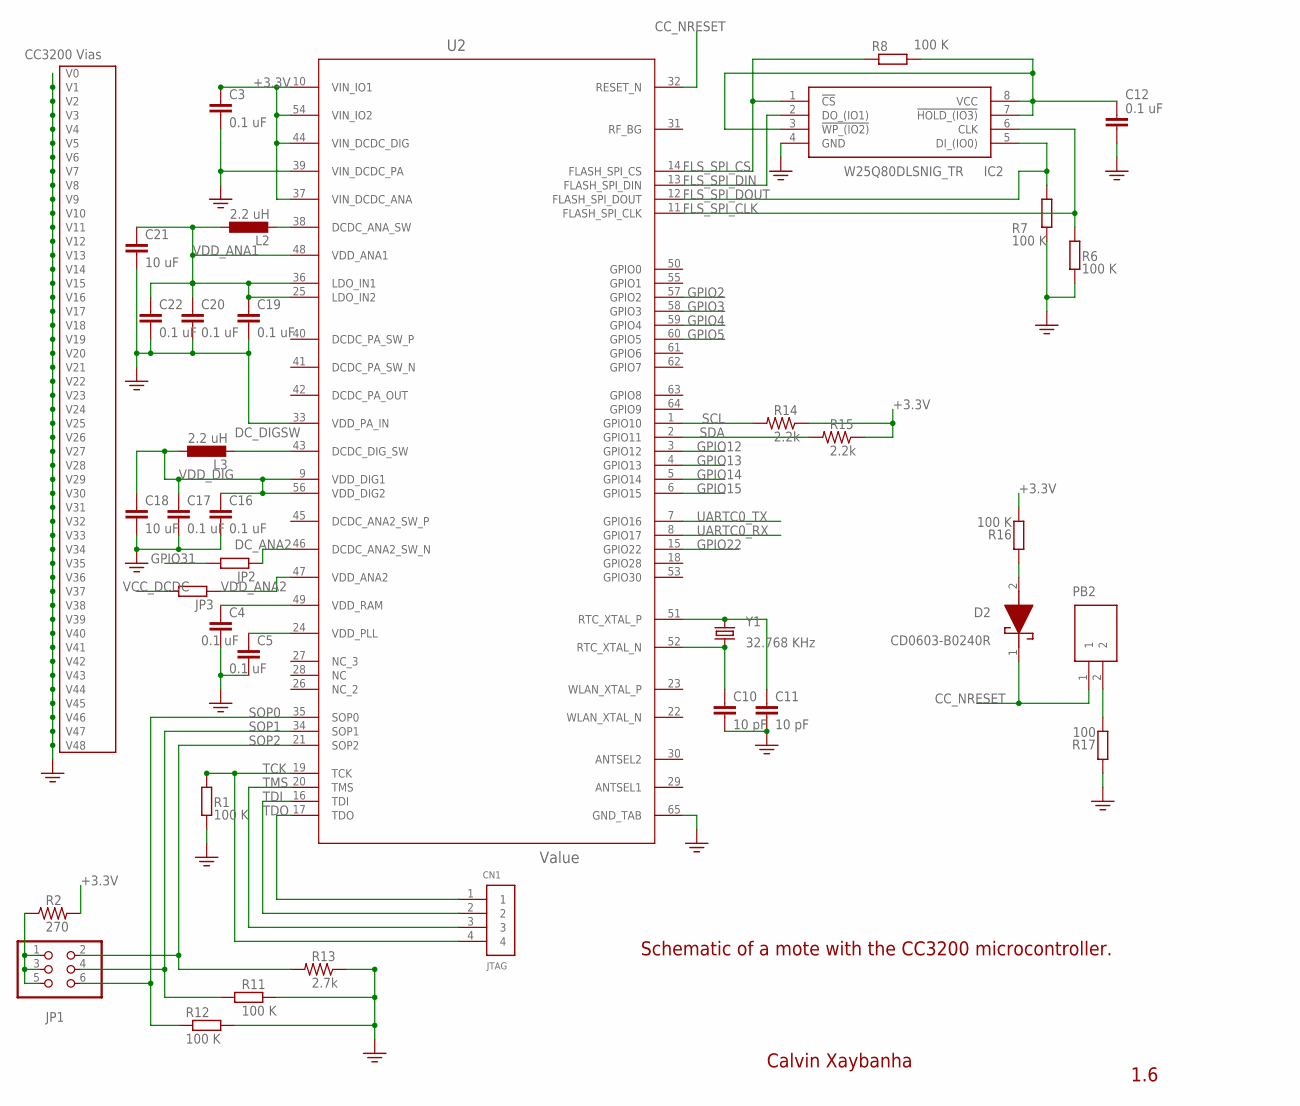
[picture p92: schematic mote+cc3200v8.sch, sheet 1, CC3200]

Parts:
C3, C4, C5, C12, C16, C17, C19, C20, C22: 0.1 uF; C1808
C10, C11: 10 pF; C1808
C18, C21: 10 uF; C1808
CN1: JTAG; 1X04-BIG
D2: CD0603-B0240R; CD0603B0240R
IC2: W25Q80DLSNIG_TR; SOIC127P600X175-8N
JP1: PINHD-2X3/90; 2X03/90
JP2, JP3: RR0201; R0201
L2, L3: 2.2 uH; L3216C
PB2: FSMSM
R1, R6, R7, R8, R11, R12, R16: 100 K; R1206
R2: 270; RES_1206
R13: 2.7k; RES_1206
R14, R15: 2.2k; RES_1206
R17: 100; R1206
U2: Value; RGC0064A
Y1: 32.768 KHz; 7.0X5.0

Connections:
+3.3V: C3.1, C12.1, IC2.3 (!WP_(IO2)), IC2.7 (!HOLD_(IO3)), IC2.8 (VCC), R2.2, R8.2, R14.1, R15.1, R16.2, U2.10 (VIN_IO1), U2.37 (VIN_DCDC_ANA), U2.44 (VIN_DCDC_DIG), U2.54 (VIN_IO2); also elsewhere on the board
CC_NRESET: D2.1 (K), PB2.1, U2.32 (RESET_N)
D2_P2: D2.2 (A), R16.1
DCDC_PA_OUT: U2.42 (DCDC_PA_OUT)
DCDC_PA_SW_N: U2.41 (DCDC_PA_SW_N)
DCDC_PA_SW_P: U2.40 (DCDC_PA_SW_P)
DC_ANA2: JP2.1, U2.46 (DCDC_ANA2_SW_N)
DC_DIGSW: L3.2, U2.43 (DCDC_DIG_SW)
FLS_SPI_CLK: IC2.6 (CLK), R6.1, U2.11 (FLASH_SPI_CLK)
FLS_SPI_CS: IC2.1 (!CS), R8.1, U2.14 (FLASH_SPI_CS)
FLS_SPI_DIN: IC2.2 (DO_(IO1)), U2.13 (FLASH_SPI_DIN)
FLS_SPI_DOUT: IC2.5 (DI_(IO0)), R7.1, U2.12 (FLASH_SPI_DOUT)
GND: C3.2, C4.2, C5.2, C10.2, C11.2, C12.2, C16.2, C17.2, C18.2, C19.2, C20.2, C21.2, C22.2, IC2.4 (GND), R1.2, R6.2, R7.2, R11.2, R12.2, R13.1, R17.1, U2.33 (VDD_PA_IN), U2.39 (VIN_DCDC_PA), U2.65 (GND_TAB), U2.V (V0), U2.V_1 (V1), U2.V_2 (V2), U2.V_3 (V3), U2.V_4 (V4), U2.V_5 (V5), U2.V_6 (V6), U2.V_7 (V7), U2.V_8 (V8), U2.V_9 (V9), U2.V_10 (V10), U2.V_11 (V11), U2.V_12 (V12), U2.V_13 (V13), U2.V_14 (V14), U2.V_15 (V15), U2.V_16 (V16), U2.V_17 (V17), U2.V_18 (V18), U2.V_19 (V19), U2.V_20 (V20), U2.V_21 (V21), U2.V_22 (V22), U2.V_23 (V23), U2.V_24 (V24), U2.V_25 (V25), U2.V_26 (V26), U2.V_27 (V27), U2.V_28 (V28), U2.V_29 (V29), U2.V_30 (V30), U2.V_31 (V31), U2.V_32 (V32), U2.V_33 (V33), U2.V_34 (V34), U2.V_35 (V35), U2.V_36 (V36), U2.V_37 (V37), U2.V_38 (V38), U2.V_39 (V39), U2.V_40 (V40), U2.V_41 (V41), U2.V_42 (V42), U2.V_43 (V43), U2.V_44 (V44), U2.V_45 (V45), U2.V_46 (V46), U2.V_47 (V47), U2.V_48 (V48); also elsewhere on the board
GPIO2: U2.57 (GPIO2); also elsewhere on the board
GPIO3: U2.58 (GPIO3); also elsewhere on the board
GPIO4: U2.59 (GPIO4); also elsewhere on the board
GPIO5: U2.60 (GPIO5); also elsewhere on the board
GPIO12: U2.3 (GPIO12); also elsewhere on the board
GPIO13: U2.4 (GPIO13); also elsewhere on the board
GPIO14: U2.5 (GPIO14); also elsewhere on the board
GPIO15: U2.6 (GPIO15); also elsewhere on the board
GPIO22: U2.15 (GPIO22); also elsewhere on the board
GPIO31: JP2.2
JP1_PWR: JP1.1, JP1.3, JP1.5, R2.1
L2_ANA: L2.2, U2.38 (DCDC_ANA_SW)
PB2_2: PB2.2, R17.2
SCL: R14.2, U2.1 (GPIO10); also elsewhere on the board
SDA: R15.2, U2.2 (GPIO11); also elsewhere on the board
SOP0: JP1.6, R12.1, U2.35 (SOP0)
SOP1: JP1.4, R11.1, U2.34 (SOP1)
SOP2: JP1.2, R13.2, U2.21 (SOP2)
TCK: CN1.4, R1.1, U2.19 (TCK)
TDI: CN1.2, U2.16 (TDI)
TDO: CN1.1, U2.17 (TDO)
TMS: CN1.3, U2.20 (TMS)
UARTC0_RX: U2.8 (GPIO17); also elsewhere on the board
UARTC0_TX: U2.7 (GPIO16); also elsewhere on the board
VCC_DCDC: JP3.2
VDD_ANA1: C19.1, C20.1, C21.1, C22.1, L2.1, U2.25 (LDO_IN2), U2.36 (LDO_IN1), U2.48 (VDD_ANA1)
VDD_ANA2: JP3.1, U2.47 (VDD_ANA2)
VDD_DIG: C16.1, C17.1, C18.1, L3.1, U2.9 (VDD_DIG1), U2.56 (VDD_DIG2)
VDD_PULL: C5.1, U2.24 (VDD_PLL)
VDD_RAM: C4.1, U2.49 (VDD_RAM)
XTAL1: C11.1, U2.51 (RTC_XTAL_P), Y1.3 (2)
XTAL2: C10.1, U2.52 (RTC_XTAL_N), Y1.1

Notes on the sheet:
Schematic of a mote with the CC3200 microcontroller.
1.6
Calvin Xaybanha
CC3200 Vias

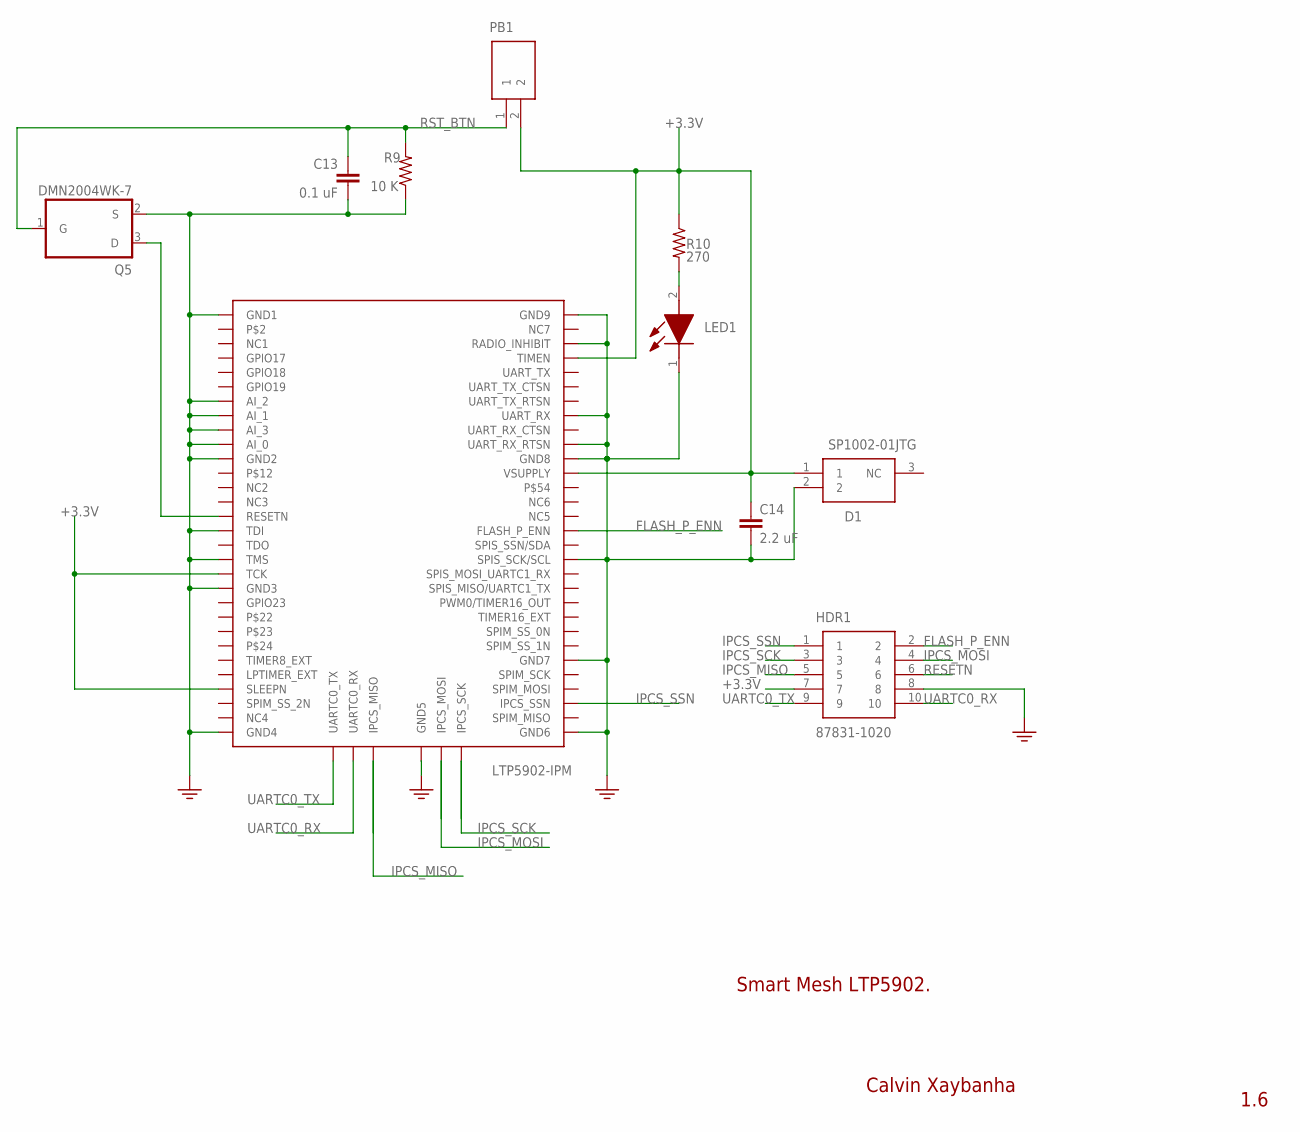
[picture p93: schematic mote+cc3200v8.sch, sheet 2, Smart Mesh]

Parts:
C13: 0.1 uF; C1808
C14: 2.2 uF; C1808
D1: SP1002-01JTG; SOT132P220X110-3N
HDR1: 87831-1020; SHDR10W55P200_2X5_1265X630X640
LED1: 156120RS75000; LEDM3216X130N
PB1: FSMSM
Q5: DMN2004WK-7; SC70-3_DCK
R9: 10 K; RES_1206
R10: 270; RES_1206
U3: LTP5902; LTP5902-MMCX

Connections:
+3.3V: C14.1, D1.1, HDR1.7, PB1.2, R10.1, U3.P19 (TCK), U3.P27 (SLEEPN), U3.P55 (VSUPPLY), U3.P63 (TIMEN); also elsewhere on the board
FLASH_P_ENN: HDR1.2, U3.P51 (FLASH_P_ENN)
GND: C13.2, C14.2, D1.2, HDR1.8, LED1.1 (K), Q5.2 (S), R9.1, U3.P1 (GND1), U3.P7 (AI_2), U3.P8 (AI_1), U3.P9 (AI_3), U3.P10 (AI_0), U3.P11 (GND2), U3.P16 (TDI), U3.P18 (TMS), U3.P20 (GND3), U3.P30 (GND4), U3.P34 (GND5), U3.P37 (GND6), U3.P42 (GND7), U3.P49 (SPIS_SCK/SCL), U3.P56 (GND8), U3.P57 (UART_RX_RTSN), U3.P59 (UART_RX), U3.P64 (RADIO_INHIBIT), U3.P66 (GND9); also elsewhere on the board
IPCS_MISO: HDR1.5, U3.P33 (IPCS_MISO)
IPCS_MOSI: HDR1.4, U3.P35 (IPCS_MOSI)
IPCS_SCK: HDR1.3, U3.P36 (IPCS_SCK)
IPCS_SSN: HDR1.1, U3.P39 (IPCS_SSN)
LED1: LED1.2 (A), R10.2
RESETN: HDR1.6, Q5.3 (D), U3.P15 (RESETN)
RST_BTN: C13.1, PB1.1, Q5.1 (G), R9.2
UARTC0_RX: HDR1.10, U3.P32 (UARTC0_RX); also elsewhere on the board
UARTC0_TX: HDR1.9, U3.P31 (UARTC0_TX); also elsewhere on the board

Notes on the sheet:
Calvin Xaybanha
1.6
Smart Mesh LTP5902.
LTP5902-IPM

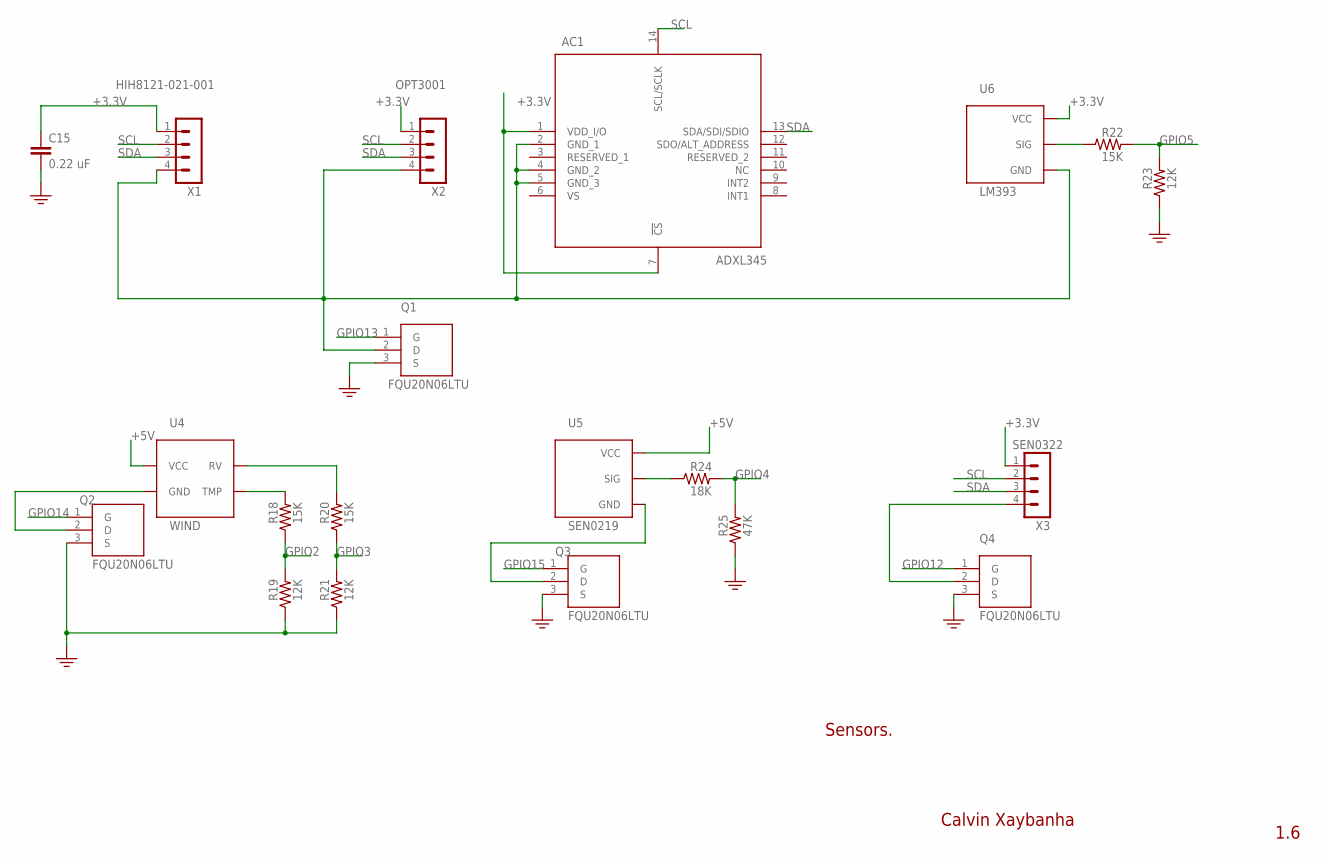
[picture p94: schematic mote+cc3200v8.sch, sheet 3, Sensors]

Parts:
AC1: ADXL345; CC-14-1
C15: 0.22 uF; C1808
Q1, Q2, Q3, Q4: FQU20N06LTU; TO229P250X658X985-3P
R18, R20, R22: 15K; RES_1206
R19, R21, R23: 12K; RES_1206
R24: 18K; RES_1206
R25: 47K; RES_1206
U4: WIND
U5: SEN0219
U6: LM393
X1: HIH8121-021-001; B4B-PH-K-S
X2: OPT3001; B4B-PH-K-S
X3: SEN0322; B4B-PH-K-S

Connections:
+3.3V: AC1.1 (VDD_I/O), AC1.7 (!CS), C15.1, U6.P$1 (VCC), X1.1, X2.1, X3.1; also elsewhere on the board
+5V: U4.P$1 (VCC), U5.P$1 (VCC); also elsewhere on the board
GND: C15.2, Q1.3 (S), Q2.3 (S), Q3.3 (S), Q4.3 (S), R19.1, R21.1, R23.1, R25.1; also elsewhere on the board
GPIO2: R18.1, R19.2; also elsewhere on the board
GPIO3: R20.1, R21.2; also elsewhere on the board
GPIO4: R24.2, R25.2; also elsewhere on the board
GPIO5: R22.2, R23.2; also elsewhere on the board
GPIO12: Q4.1 (G); also elsewhere on the board
GPIO13: Q1.1 (G); also elsewhere on the board
GPIO14: Q2.1 (G); also elsewhere on the board
GPIO15: Q3.1 (G); also elsewhere on the board
Q1+: AC1.2 (GND_1), AC1.4 (GND_2), AC1.5 (GND_3), Q1.2 (D), U6.P$3 (GND), X1.4, X2.4
Q2+: Q2.2 (D), U4.P$2 (GND)
Q3+: Q3.2 (D), U5.P$3 (GND)
Q4+: Q4.2 (D), X3.4
R18_1: R18.2, U4.P$4 (TMP)
R20_1: R20.2, U4.P$3 (RV)
R22_1: R22.1, U6.P$2 (SIG)
R24_1: R24.1, U5.P$2 (SIG)
SCL: AC1.14 (SCL/SCLK), X1.2, X2.2, X3.2; also elsewhere on the board
SDA: AC1.13 (SDA/SDI/SDIO), X1.3, X2.3, X3.3; also elsewhere on the board

Notes on the sheet:
Calvin Xaybanha
1.6
Sensors.

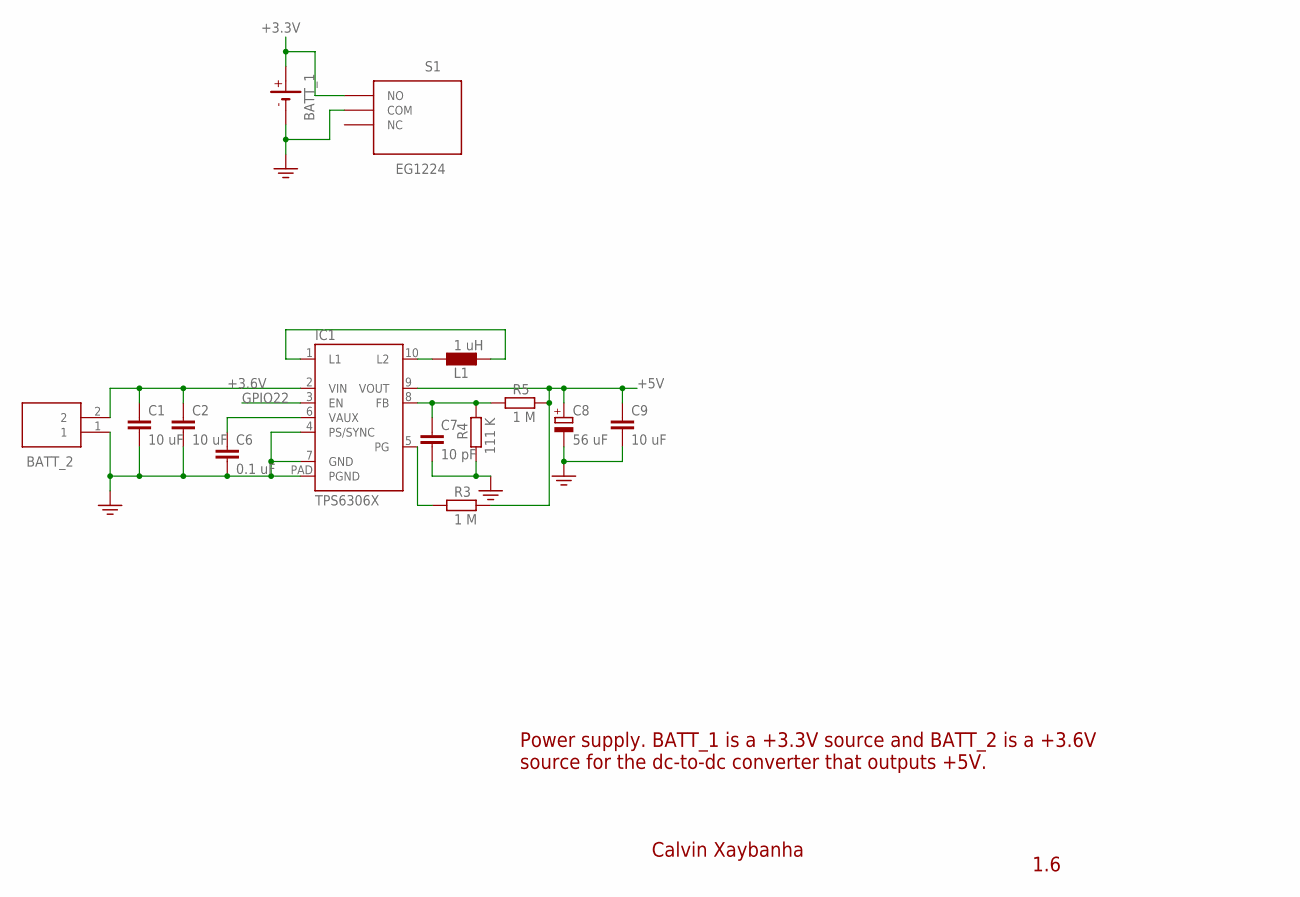
[picture p95: schematic mote+cc3200v8.sch, sheet 4, Power Supply]

Parts:
BATT_1: BATTERY_BR1225/FA
BATT_2: 12BH23P-GR; 12BH23PGR
C1, C2, C9: 10 uF; C1808
C6: 0.1 uF; C1808
C7: 10 pF; C1808
C8: 56 uF; E3,5-8
IC1: TPS6306X; S-PWSON-N10
L1: 1 uH; 0204/7
R3, R5: 1 M; R5025
R4: 111 K; R1206
S1: EG1224

Connections:
+3.3V: BATT_1.+, S1.1 (NO); also elsewhere on the board
+3.6V: BATT_2.2, C1.1, C2.1, IC1.2 (VIN)
+5V: C8.+, C9.1, IC1.9 (VOUT), R3.2, R5.2; also elsewhere on the board
FB_TPS: C7.1, IC1.8 (FB), R4.2, R5.1
GND: BATT_1.-, BATT_2.1, C1.2, C2.2, C6.2, C7.2, C8.-, C9.2, IC1.4 (PS/SYNC), IC1.7 (GND), IC1.PAD (PGND), R4.1, S1.2 (COM); also elsewhere on the board
GPIO22: IC1.3 (EN); also elsewhere on the board
L_TPS1: IC1.1 (L1), L1.2
L_TPS2: IC1.10 (L2), L1.1
PG_TPS: IC1.5 (PG), R3.1
VAUX_TPS: C6.1, IC1.6 (VAUX)

Notes on the sheet:
Calvin Xaybanha
1.6
Power supply. BATT_1 is a +3.3V source and BATT_2 is a +3.6V source for the dc-to-dc converter that outputs +5V.

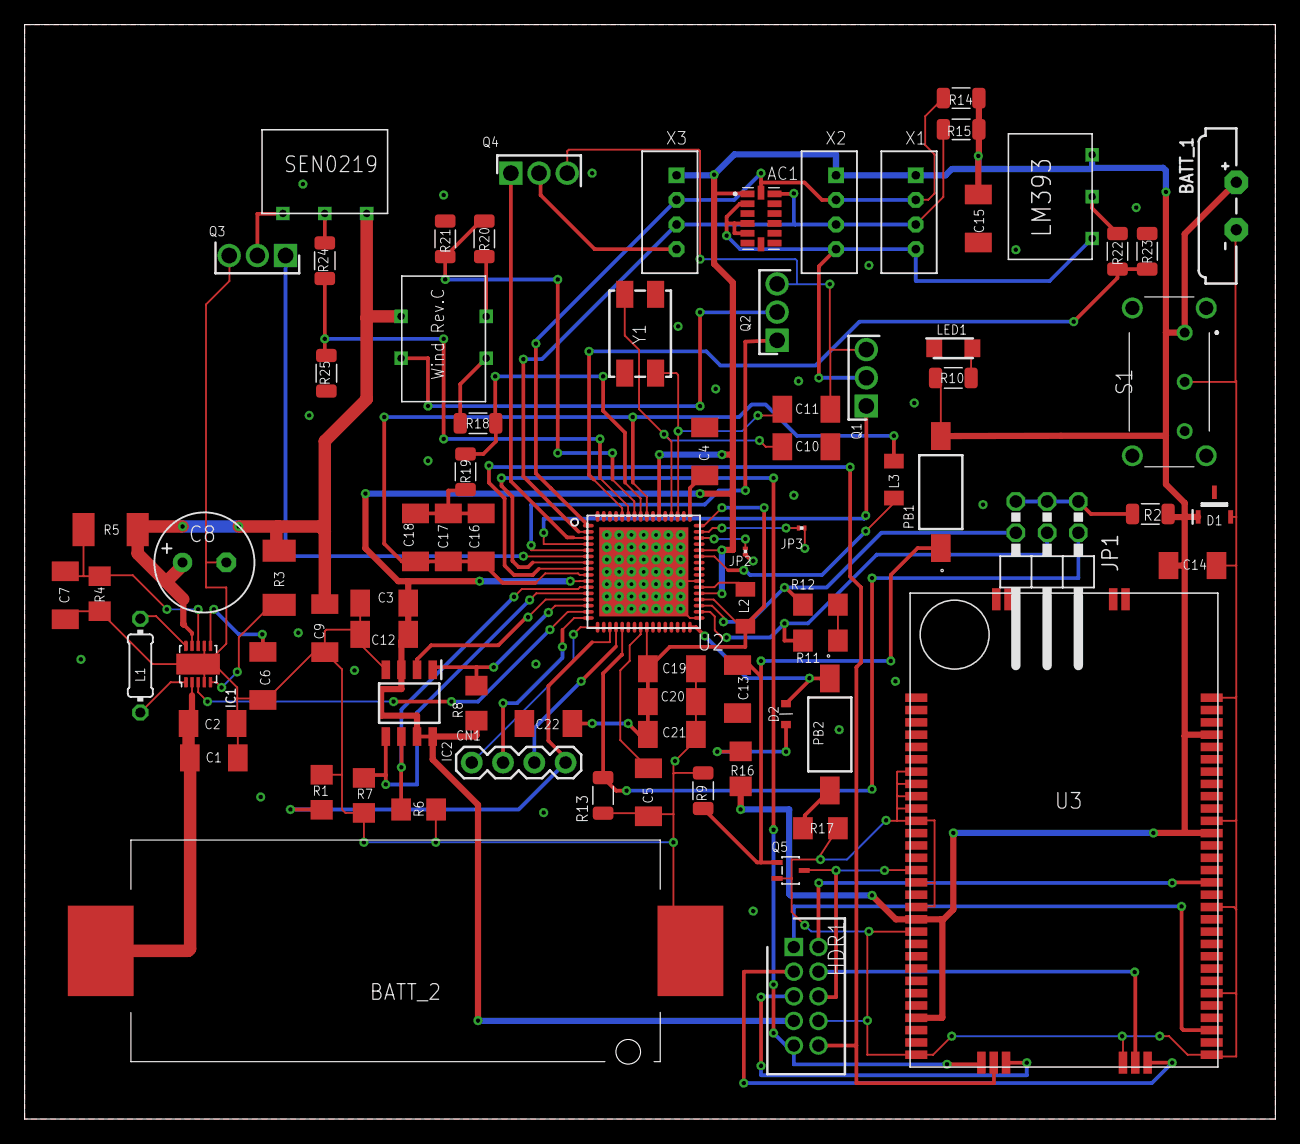
[picture p96: board mote+cc3200v8.brd from above]

Board: 2 copper layers, 101.6 x 88.9 mm, 80 parts (0 on the bottom side), 63 nets.
