ECE-412-Capstone-Sensor-Suite/Team-20-Sensor-Suite/Design Files/mote+cc3200v4.brd

## EAGLE design Design Files/mote+cc3200v4.brd (2021-05-17)

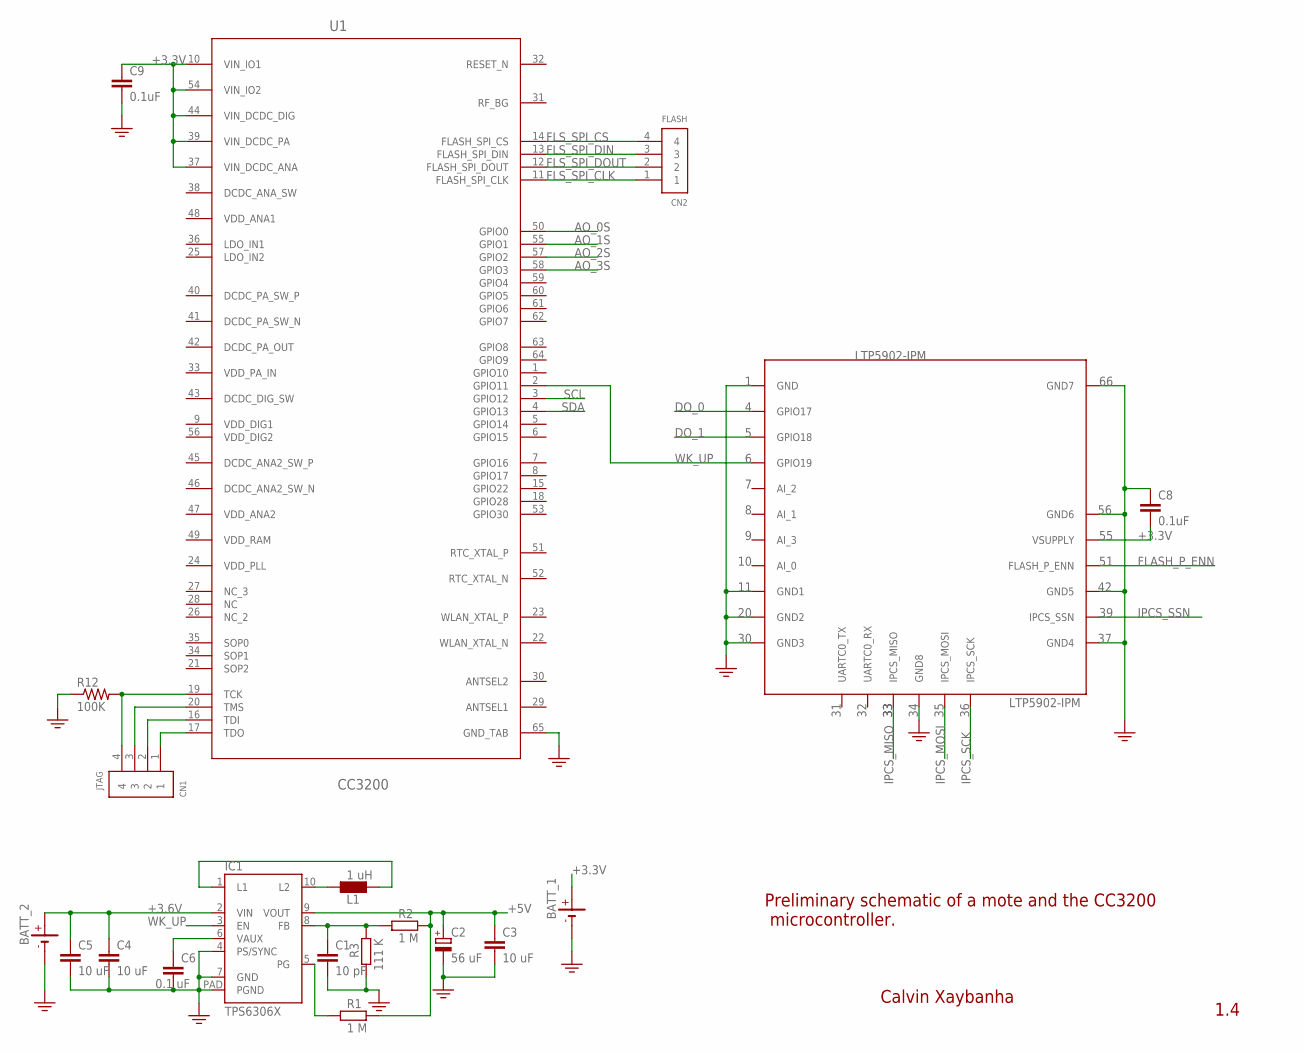
[picture p97: schematic mote+cc3200v4.sch, sheet 1]

Parts:
BATT_1, BATT_2: BATTERY_BR1225/FA
C1: 10 pF; C1808
C2: 56 uF; E3,5-8
C3, C4, C5: 10 uF; C1808
C6: 0.1 uF; C1808
C8, C9: 0.1uF; C5B3.5
CN1: JTAG; 1X04-BIG
CN2: FLASH; 1X04-BIG
IC1: TPS6306X; S-PWSON-N10
L1: 1 uH; 0204/7
R1, R2: 1 M; R5025
R3: 111 K; R1206
R12: 100K; 0207/10
U1: CC3200; RGC0064A
U5: LTP5902; LTP5901

Connections:
3.3V: U5.P$1 (GND), U5.P$9 (GND1), U5.P$10 (GND2), U5.P$11 (GND3); also elsewhere on the board
+3.3V: BATT_1.+, C8.2, C9.1, U1.10 (VIN_IO1), U1.37 (VIN_DCDC_ANA), U1.39 (VIN_DCDC_PA), U1.44 (VIN_DCDC_DIG), U1.54 (VIN_IO2), U5.P$22 (VSUPPLY); also elsewhere on the board
+3.6V: BATT_2.+, C4.1, C5.1, IC1.2 (VIN)
+5V: C2.+, C3.1, IC1.9 (VOUT), R1.2, R2.2; also elsewhere on the board
AO_0S: U1.50 (GPIO0)
AO_1S: U1.55 (GPIO1); also elsewhere on the board
AO_2S: U1.57 (GPIO2); also elsewhere on the board
AO_3S: U1.58 (GPIO3); also elsewhere on the board
DCDC_ANA_SW: U1.38 (DCDC_ANA_SW)
DCDC_DIG_SW: U1.43 (DCDC_DIG_SW)
DCDC_PA_OUT: U1.42 (DCDC_PA_OUT)
DCDC_PA_SW_N: U1.41 (DCDC_PA_SW_N)
DCDC_PA_SW_P: U1.40 (DCDC_PA_SW_P)
DO_0: U5.P$2 (GPIO17)
DO_1: U5.P$3 (GPIO18)
FB_TPS: C1.1, IC1.8 (FB), R2.1, R3.2
FLASH_P_ENN: U5.P$21 (FLASH_P_ENN)
FLS_SPI_CLK: CN2.1, U1.11 (FLASH_SPI_CLK)
FLS_SPI_CS: CN2.4, U1.14 (FLASH_SPI_CS)
FLS_SPI_DIN: CN2.3, U1.13 (FLASH_SPI_DIN)
FLS_SPI_DOUT: CN2.2, U1.12 (FLASH_SPI_DOUT)
GND: BATT_1.-, BATT_2.-, C1.2, C2.-, C3.2, C4.2, C5.2, C6.2, C8.1, C9.2, IC1.4 (PS/SYNC), IC1.7 (GND), IC1.PAD (PGND), R3.1, R12.1, U1.65 (GND_TAB), U5.P$15 (GND8), U5.P$18 (GND4), U5.P$20 (GND5), U5.P$23 (GND6), U5.P$24 (GND7); also elsewhere on the board
IPCS_MISO: U5.P$14 (IPCS_MISO)
IPCS_MOSI: U5.P$16 (IPCS_MOSI)
IPCS_SCK: U5.P$17 (IPCS_SCK)
IPCS_SSN: U5.P$19 (IPCS_SSN)
LDO_IN1: U1.36 (LDO_IN1)
LDO_IN2: U1.25 (LDO_IN2)
L_TPS1: IC1.1 (L1), L1.2
L_TPS2: IC1.10 (L2), L1.1
unnamed: CN1.4, R12.2, U1.19 (TCK)
unnamed: CN1.3, U1.20 (TMS)
unnamed: CN1.2, U1.16 (TDI)
unnamed: CN1.1, U1.17 (TDO)
PG_TPS: IC1.5 (PG), R1.1
SCL: U1.3 (GPIO12); also elsewhere on the board
SDA: U1.4 (GPIO13); also elsewhere on the board
VAUX_TPS: C6.1, IC1.6 (VAUX)
VDD_ANA1: U1.48 (VDD_ANA1)
VDD_ANA2: U1.47 (VDD_ANA2)
VDD_DIG1: U1.9 (VDD_DIG1)
VDD_DIG2: U1.56 (VDD_DIG2)
VDD_PA_IN: U1.33 (VDD_PA_IN)
VDD_PLL: U1.24 (VDD_PLL)
VDD_RAM: U1.49 (VDD_RAM)
WK_UP: IC1.3 (EN), U1.2 (GPIO11), U5.P$4 (GPIO19)

Notes on the sheet:
Preliminary schematic of a mote and the CC3200 microcontroller.
1.4
Calvin Xaybanha
LTP5902-IPM

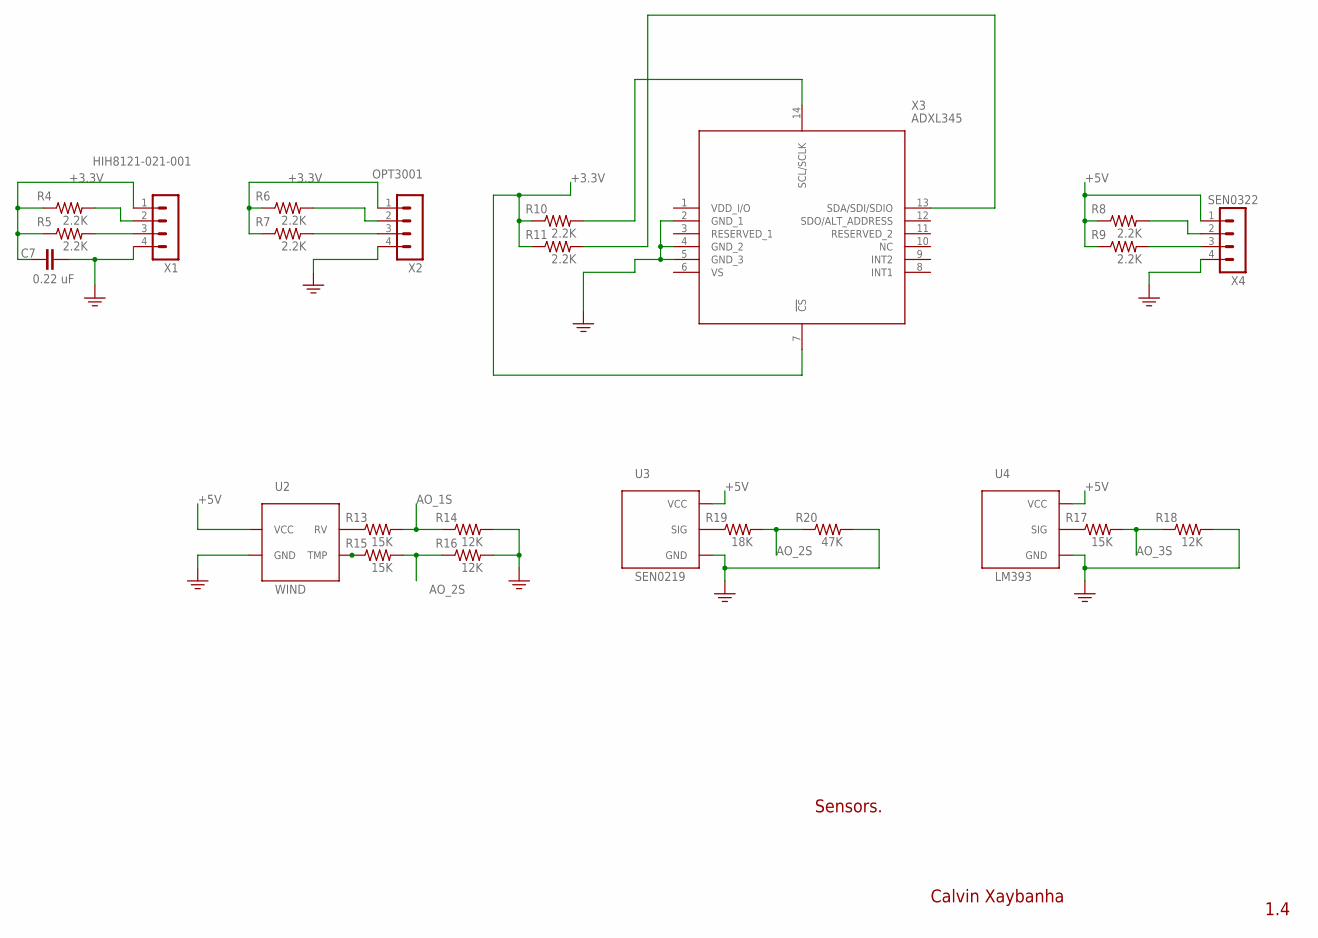
[picture p98: schematic mote+cc3200v4.sch, sheet 2]

Parts:
C7: 0.22 uF; C5B3.5
R4, R5, R6, R7, R8, R9, R10, R11: 2.2K; 0207/9
R13, R15, R17: 15K; 0207/9
R14, R16, R18: 12K; 0207/9
R19: 18K; 0207/9
R20: 47K; 0207/9
U2: WIND
U3: SEN0219
U4: LM393
X1: HIH8121-021-001; B4B-PH-K-S
X2: OPT3001; B4B-PH-K-S
X3: ADXL345; CC-14-1
X4: SEN0322; B4B-PH-K-S

Connections:
3.3V: R14.2, R16.2; also elsewhere on the board
+3.3V: C7.1, R4.1, R5.1, R6.1, R7.1, R10.1, R11.1, X1.1, X2.1, X3.7 (!CS); also elsewhere on the board
+5V: R8.1, R9.1, U2.P$1 (VCC), U3.P$1 (VCC), U4.P$1 (VCC), X4.1; also elsewhere on the board
AO_1S: R13.2, R14.1; also elsewhere on the board
AO_2S: R15.2, R16.1, R19.2, R20.1; also elsewhere on the board
AO_3S: R17.2, R18.1; also elsewhere on the board
GND: C7.2, R18.2, R20.2, U2.P$2 (GND), U3.P$3 (GND), U4.P$3 (GND), X1.4, X2.4, X3.2 (GND_1), X3.4 (GND_2), X3.5 (GND_3), X4.4; also elsewhere on the board
unnamed: R7.2, X2.3
unnamed: R11.2, X3.13 (SDA/SDI/SDIO)
unnamed: R13.1, U2.P$3 (RV)
unnamed: R17.1, U4.P$2 (SIG)
unnamed: R15.1, U2.P$4 (TMP)
unnamed: R19.1, U3.P$2 (SIG)
SCL: R4.2, R6.2, R8.2, R10.2, X1.2, X2.2, X3.14 (SCL/SCLK), X4.2; also elsewhere on the board
SDA: R5.2, R9.2, X1.3, X4.3; also elsewhere on the board
VDD_I/O: X3.1 (VDD_I/O)

Notes on the sheet:
Calvin Xaybanha
1.4
Sensors.

Board: 2 copper layers, 44 parts (0 on the bottom side), 30 nets, no tracks yet.
