ECE-412-Capstone-Sensor-Suite/Team-20-Sensor-Suite/Design Files/schematic1.brd

## EAGLE design Design Files/schematic1.brd (2021-05-04)

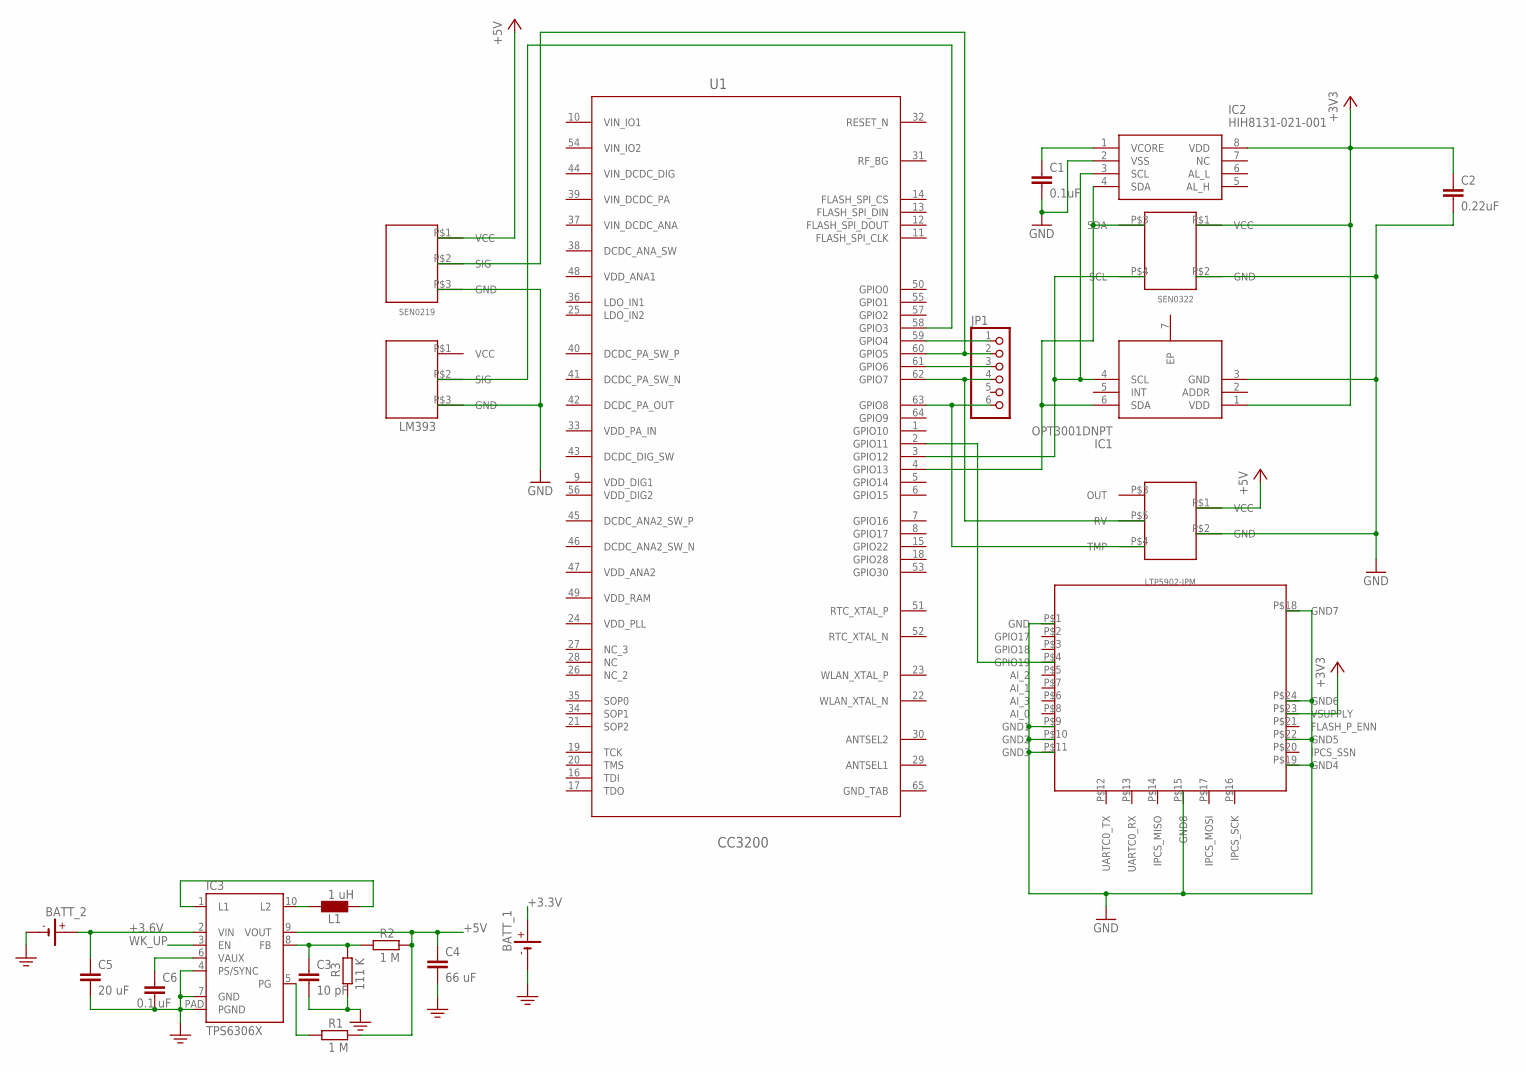
[picture p99: schematic schematic1.sch]

Parts:
BATT_1, BATT_2: BATTERY_BR1225/FA
C1: 0.1uF; C2.5-2
C2: 0.22uF; C2.5-2
C3: 10 pF; C1808
C4: 66 uF; C1808
C5: 20 uF; C1808
C6: 0.1 uF; C1808
IC1: OPT3001DNPT; SON65P200X200X65-7N
IC2: HIH8131-021-001; SOIC127P600X206-8N
IC3: TPS6306X; S-PWSON-N10
JP1: PINHD-1X6CB; 1X06-CLEANBIG
L1: 1 uH; 0204/7
R1, R2: 1 M; R2010
R3: 111 K; R2010
U1: CC3200; RGC0064A
U2: WIND
U3: SEN0322
U4: SEN0219
U5: LM393
U6: LTP5902; LTP5901

Connections:
+3.3V: BATT_1.+
+3.6V: BATT_2.+, C5.1, IC3.2 (VIN)
+3V3: C2.1, IC1.1 (VDD), IC2.8 (VDD), U3.P$1 (VCC), U6.P$23 (VSUPPLY)
+5V: C4.1, IC3.9 (VOUT), R1.2, R2.2, U2.P$1 (VCC), U4.P$1 (VCC)
DCDC_ANA_SW: U1.38 (DCDC_ANA_SW)
DCDC_DIG_SW: U1.43 (DCDC_DIG_SW)
DCDC_PA_OUT: U1.42 (DCDC_PA_OUT)
DCDC_PA_SW_N: U1.41 (DCDC_PA_SW_N)
DCDC_PA_SW_P: U1.40 (DCDC_PA_SW_P)
FB_TPS: C3.1, IC3.8 (FB), R2.1, R3.2
GND: BATT_1.-, BATT_2.-, C1.2, C2.2, C3.2, C4.2, C5.2, C6.2, IC1.3 (GND), IC2.2 (VSS), IC3.4 (PS/SYNC), IC3.7 (GND), IC3.PAD (PGND), R3.1, U2.P$2 (GND), U3.P$2 (GND), U4.P$3 (GND), U5.P$3 (GND), U6.P$1 (GND), U6.P$9 (GND1), U6.P$10 (GND2), U6.P$11 (GND3), U6.P$15 (GND8), U6.P$18 (GND7), U6.P$19 (GND4), U6.P$22 (GND5), U6.P$24 (GND6)
GND_TAB: U1.65 (GND_TAB)
LDO_IN1: U1.36 (LDO_IN1)
LDO_IN2: U1.25 (LDO_IN2)
L_TPS1: IC3.1 (L1), L1.2
L_TPS2: IC3.10 (L2), L1.1
unnamed: JP1.1, U1.59 (GPIO4)
unnamed: JP1.2, U1.60 (GPIO5), U4.P$2 (SIG)
unnamed: U1.2 (GPIO11), U6.P$4 (GPIO19)
unnamed: U1.58 (GPIO3), U5.P$2 (SIG)
unnamed: JP1.3, U1.61 (GPIO6)
unnamed: JP1.4, U1.62 (GPIO7), U2.P$5 (RV)
unnamed: JP1.6, U1.63 (GPIO8), U2.P$4 (TMP)
unnamed: C1.1, IC2.1 (VCORE)
unnamed: IC1.4 (SCL), IC2.3 (SCL), U1.3 (GPIO12), U3.P$4 (SCL)
unnamed: IC1.6 (SDA), IC2.4 (SDA), U1.4 (GPIO13), U3.P$3 (SDA)
PG_TPS: IC3.5 (PG), R1.1
VAUX_TPS: C6.1, IC3.6 (VAUX)
VDD_ANA1: U1.48 (VDD_ANA1)
VDD_ANA2: U1.47 (VDD_ANA2)
VDD_DIG1: U1.9 (VDD_DIG1)
VDD_DIG2: U1.56 (VDD_DIG2)
VDD_PA_IN: U1.33 (VDD_PA_IN)
VDD_PLL: U1.24 (VDD_PLL)
VDD_RAM: U1.49 (VDD_RAM)
VIN_DCDC_ANA: U1.37 (VIN_DCDC_ANA)
VIN_DCDC_DIG: U1.44 (VIN_DCDC_DIG)
VIN_DCDC_PA: U1.39 (VIN_DCDC_PA)
VIN_IO1: U1.10 (VIN_IO1)
VIN_IO2: U1.54 (VIN_IO2)
WK_UP: IC3.3 (EN)

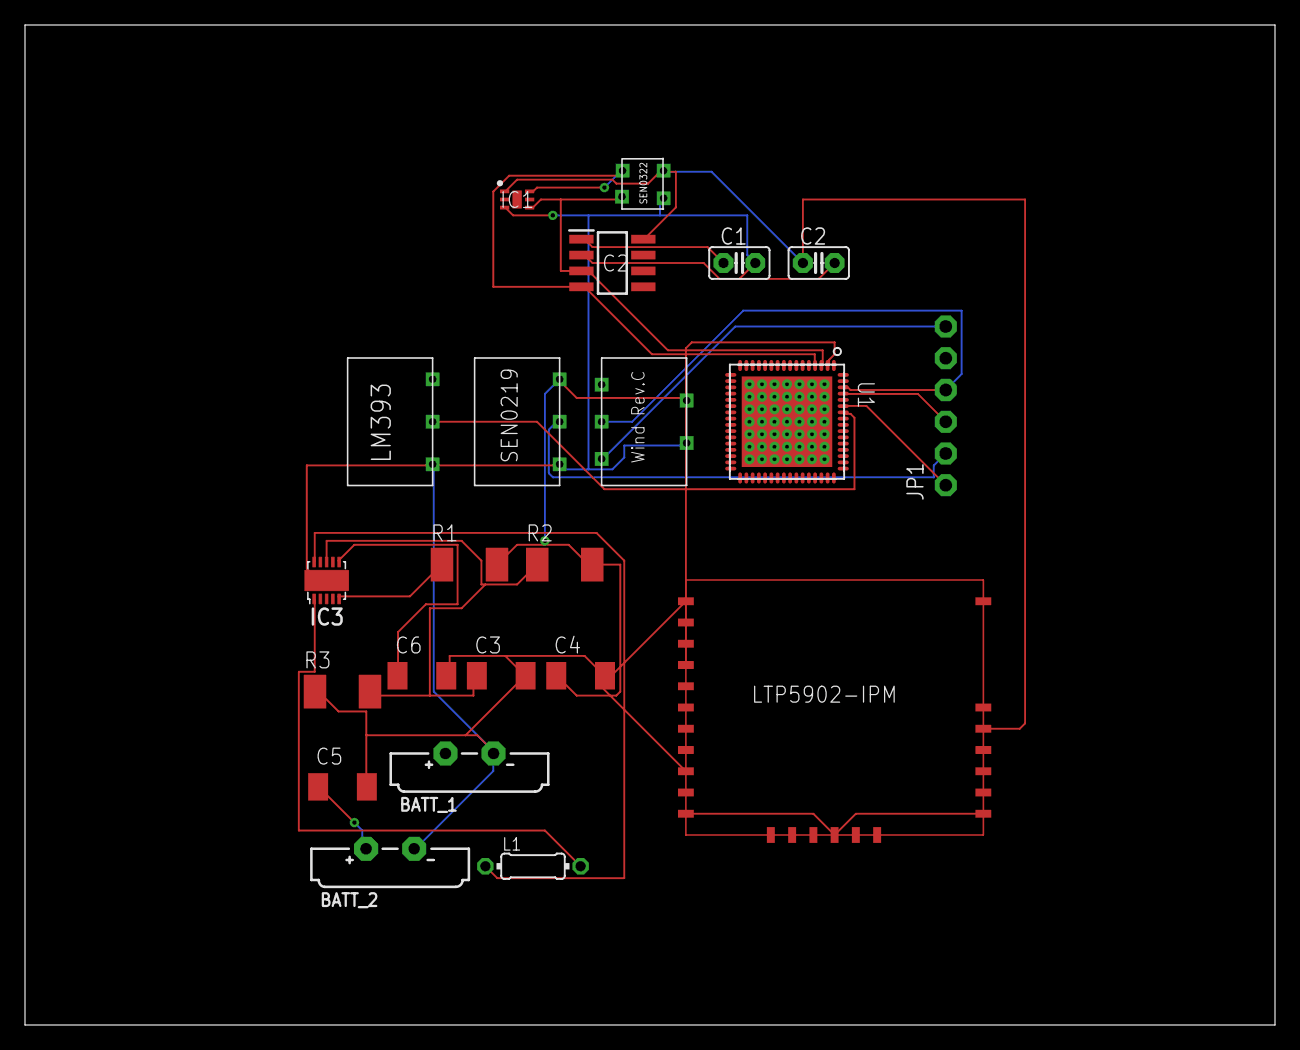
[picture p100: board schematic1.brd from above]

Board: 2 copper layers, 100.0 x 80.0 mm, 22 parts (0 on the bottom side), 19 nets.
