ECE-412-Capstone-Sensor-Suite/Team-20-Sensor-Suite/Firmware/On-chip App/onchipsdk-REL-1.1.0.7/src/app/02-uart/uart_app.py

#!/usr/bin/python

import sys
import threading
import time
import re

try:
    import serial
except ImportError:
    output  = ''
    output += 'Could not load the serial module.\n'
    output += 'Please install PySerial from http://pyserial.sourceforge.net/,'
    output += 'then run this script again.\n'
    raw_input(output)
    sys.exit()

class Crc():
    
    _fcstab = [
        0x0000, 0x1189, 0x2312, 0x329b, 0x4624, 0x57ad, 0x6536, 0x74bf,
        0x8c48, 0x9dc1, 0xaf5a, 0xbed3, 0xca6c, 0xdbe5, 0xe97e, 0xf8f7,
        0x1081, 0x0108, 0x3393, 0x221a, 0x56a5, 0x472c, 0x75b7, 0x643e,
        0x9cc9, 0x8d40, 0xbfdb, 0xae52, 0xdaed, 0xcb64, 0xf9ff, 0xe876,
        0x2102, 0x308b, 0x0210, 0x1399, 0x6726, 0x76af, 0x4434, 0x55bd,
        0xad4a, 0xbcc3, 0x8e58, 0x9fd1, 0xeb6e, 0xfae7, 0xc87c, 0xd9f5,
        0x3183, 0x200a, 0x1291, 0x0318, 0x77a7, 0x662e, 0x54b5, 0x453c,
        0xbdcb, 0xac42, 0x9ed9, 0x8f50, 0xfbef, 0xea66, 0xd8fd, 0xc974,
        0x4204, 0x538d, 0x6116, 0x709f, 0x0420, 0x15a9, 0x2732, 0x36bb,
        0xce4c, 0xdfc5, 0xed5e, 0xfcd7, 0x8868, 0x99e1, 0xab7a, 0xbaf3,
        0x5285, 0x430c, 0x7197, 0x601e, 0x14a1, 0x0528, 0x37b3, 0x263a,
        0xdecd, 0xcf44, 0xfddf, 0xec56, 0x98e9, 0x8960, 0xbbfb, 0xaa72,
        0x6306, 0x728f, 0x4014, 0x519d, 0x2522, 0x34ab, 0x0630, 0x17b9,
        0xef4e, 0xfec7, 0xcc5c, 0xddd5, 0xa96a, 0xb8e3, 0x8a78, 0x9bf1,
        0x7387, 0x620e, 0x5095, 0x411c, 0x35a3, 0x242a, 0x16b1, 0x0738,
        0xffcf, 0xee46, 0xdcdd, 0xcd54, 0xb9eb, 0xa862, 0x9af9, 0x8b70,
        0x8408, 0x9581, 0xa71a, 0xb693, 0xc22c, 0xd3a5, 0xe13e, 0xf0b7,
        0x0840, 0x19c9, 0x2b52, 0x3adb, 0x4e64, 0x5fed, 0x6d76, 0x7cff,
        0x9489, 0x8500, 0xb79b, 0xa612, 0xd2ad, 0xc324, 0xf1bf, 0xe036,
        0x18c1, 0x0948, 0x3bd3, 0x2a5a, 0x5ee5, 0x4f6c, 0x7df7, 0x6c7e,
        0xa50a, 0xb483, 0x8618, 0x9791, 0xe32e, 0xf2a7, 0xc03c, 0xd1b5,
        0x2942, 0x38cb, 0x0a50, 0x1bd9, 0x6f66, 0x7eef, 0x4c74, 0x5dfd,
        0xb58b, 0xa402, 0x9699, 0x8710, 0xf3af, 0xe226, 0xd0bd, 0xc134,
        0x39c3, 0x284a, 0x1ad1, 0x0b58, 0x7fe7, 0x6e6e, 0x5cf5, 0x4d7c,
        0xc60c, 0xd785, 0xe51e, 0xf497, 0x8028, 0x91a1, 0xa33a, 0xb2b3,
        0x4a44, 0x5bcd, 0x6956, 0x78df, 0x0c60, 0x1de9, 0x2f72, 0x3efb,
        0xd68d, 0xc704, 0xf59f, 0xe416, 0x90a9, 0x8120, 0xb3bb, 0xa232,
        0x5ac5, 0x4b4c, 0x79d7, 0x685e, 0x1ce1, 0x0d68, 0x3ff3, 0x2e7a,
        0xe70e, 0xf687, 0xc41c, 0xd595, 0xa12a, 0xb0a3, 0x8238, 0x93b1,
        0x6b46, 0x7acf, 0x4854, 0x59dd, 0x2d62, 0x3ceb, 0x0e70, 0x1ff9,
        0xf78f, 0xe606, 0xd49d, 0xc514, 0xb1ab, 0xa022, 0x92b9, 0x8330,
        0x7bc7, 0x6a4e, 0x58d5, 0x495c, 0x3de3, 0x2c6a, 0x1ef1, 0x0f78
    ]
    
    #======================== public ==========================================
    
    def calculate(self,data):
        ptr = 0
        tempfcs = 0xffff
        while ptr<len(data):
            tempfcs = (tempfcs >> 8) ^ self._fcstab[(tempfcs ^ data[ptr]) & 0xff];
            ptr += 1
        tempfcs ^= 0xffff
        fcs  = []
        fcs.append( (tempfcs>>0) & 0xff )
        fcs.append( (tempfcs>>8) & 0xff )
        return fcs
    
    #======================== private =========================================

class Hdlc(threading.Thread):
    
    _BAUDRATE      = 115200 # the default baudrate used by this module
    
    _HDLC_FLAG     = 0x7e   # the HDLC flag at the beginning/end of a frame
    _HDLC_ESCAPE   = 0x7d   # escape character when the HDLC flag in payload
    _HDLC_MASK     = 0x20   # mask used to recover from escape characters
    
    _EXPECTED_FLAG    = 'flag'
    _EXPECTED_PAYLOAD = 'payload'
    
    def __init__(self,rxcallback):
        
        # store params
        self.rxcallback           = rxcallback
        
        # initialize parent class
        threading.Thread.__init__(self)
        self.name                 = 'HDLC'
        
        # local variables
        self.connected            = False
        self.comPort              = ''
        self.crc                  = Crc()
        self.pyserialHandler      = ''
        self.busySending          = threading.Lock()
    
    def run(self):
        
        while self.connected==True:
            try:
            
                # received a byte
                try:
                    byte = self.pyserialHandler.read(1)
                except Exception as err:
                    # work-around for bug in pyserial
                    # https://sourceforge.net/tracker/?func=detail&aid=3591432&group_id=46487&atid=446302
                    raise serial.SerialException(str(err))
                if not len(byte):
                    raise serial.SerialException()
                byte = ord(byte)
                
                if   self._expectedByte == self._EXPECTED_FLAG:
                    if byte==self._HDLC_FLAG:
                        self.receivedFrame            = {}
                        self.receivedFrame['payload'] = []
                        self._expectedByte            = self._EXPECTED_PAYLOAD
                
                elif self._expectedByte==self._EXPECTED_PAYLOAD:
                    
                    if byte==self._HDLC_FLAG:
                        # end of packet
                        # split payload and fcs
                        if len(self.receivedFrame['payload'])>2:
                            temp_payload                   = self.receivedFrame['payload']
                            self.receivedFrame['payload']  = temp_payload[:-2]
                            self.receivedFrame['fcs']      = temp_payload[-2:]
                            
                            # check fcs, write 'valid' field
                            recalculatedCrc                = self.crc.calculate(self.receivedFrame['payload'])
                            if recalculatedCrc==self.receivedFrame['fcs']:
                                self.receivedFrame['valid'] = True
                            else:
                                self.receivedFrame['valid'] = False
                            
                            # callback
                            if self.receivedFrame['valid']==True:
                                self.rxcallback(self.receivedFrame['payload'])
                        else:
                            print "@Hdlc: received hdlc frame too short"
                        self._restart()
                    
                    else:
                        # receiving packet bytes
                        if byte==self._HDLC_ESCAPE:
                            self._escape = True
                            # do not add this byte to the payload
                        else:
                            if self._escape == True:
                                self.receivedFrame['payload'].append(byte^self._HDLC_MASK)
                                self._escape = False
                            else:
                                self.receivedFrame['payload'].append(byte)
            except serial.SerialException:
                self.connected = False
        
        del self.crc
        del self.pyserialHandler
    
    #======================== public ==========================================
    
    def connect(self,comPort,baudrate=_BAUDRATE):
        self.comPort         = comPort
        try:
            self.pyserialHandler = serial.Serial(self.comPort,baudrate=baudrate)
            self.pyserialHandler.setRTS(False)
            self.pyserialHandler.setDTR(True)
        except serial.serialutil.SerialException as err:
            raise
        else:
            self._restart()
            self.connected = True
            self.name      = '{0}_HDLC'.format(self.comPort)
            self.start()
        return self
    
    def send(self,message):
        
        if not self.connected:
            print 'not connected'
            return
        
        # add fcs bytes
        packetToSend = {}
        packetToSend['payload']   = message
        packetToSend['fcs']       = self.crc.calculate(packetToSend['payload'])
        packetToSend['valid']     = True
        
        # assemble packet
        packetBytes               = packetToSend['payload']+packetToSend['fcs']
        
        # add escape characters
        index = 0
        while index<len(packetBytes):
            if packetBytes[index]==self._HDLC_FLAG or packetBytes[index]==self._HDLC_ESCAPE:
                packetBytes.insert(index,self._HDLC_ESCAPE)
                index += 1
                packetBytes[index] = packetBytes[index]^self._HDLC_MASK
            index += 1
        
        # add flags
        packetBytes.insert(0,self._HDLC_FLAG)
        packetBytes.insert(len(packetBytes),self._HDLC_FLAG)
        
        # reconstitute byteArray
        byteArray = ''
        for byte in packetBytes:
            byteArray += chr(byte)
        
        # send over serial port   
        with self.busySending:
            numWritten = self.pyserialHandler.write(byteArray)
        
        if numWritten!=len(packetBytes):
            print 'wrote '+str(numWritten)+' bytes, expected '+str(len(packetBytes))
    
    def disconnect(self):
        if self.connected==True:
            self.pyserialHandler.close()
        self.comPort         = ''
        self.name            = 'HDLC'
    
    #======================== support methods for Python "with" statement =====
    def __enter__(self):
        pass
    
    def __exit__(self, type, value, tb):
        self.disconnect()

    #======================== private =========================================
    
    def _restart(self):
        self._expectedByte   = self._EXPECTED_FLAG
        self._escape         = False
    
    def _formatFrame(self,frame):
        returnVal  = []
        returnVal += [' - payload: {0}'.format(' '.join(["%.02x"%b for b in frame['payload']]))]
        returnVal += [' - fcs:     {0}'.format(' '.join(["%.02x"%b for b in frame['fcs']]))]
        returnVal += [' - valid:   {0}'.format(frame['valid'])]
        return returnVal

#======================== main ================================================

def rxCallback(uartFrame):
    output  = []
    output += ['uart RX ({0} bytes) '.format(len(uartFrame))]
    output += [' '.join('%02x'%b for b in uartFrame[:100])]
    if len(uartFrame)>100:
        output += ['...']
    output  = ''.join(output)
    print output

def main():
    print 'uart_app OCFDK Sample application'
    hdlc = Hdlc(rxCallback)
    uartTxLen   = 10
    uartTxDelay = 100
    while True:
        command = raw_input('> ')
        command = command.strip()
        if not command:
            continue
        try:
            if   command.startswith('connect'):
                m = re.search('connect\s+(\S+)',command)
                comPort = m.group(1)
                hdlc.connect(comPort)
            elif command.startswith('len'):
                m = re.search('len\s+(\d+)',command)
                uartTxLen = int(m.group(1))
            elif command.startswith('delay'):
                m = re.search('delay\s+(\d+)',command)
                uartTxDelay = int(m.group(1))
            elif command.startswith('tx'):
                m = re.search('tx\s+(\d+)',command)
                numTx = m.group(1)
                print 'Sending {0} UART packets, {1} bytes, delay {2} ms'.format(numTx,uartTxLen,uartTxDelay)
                for i in range(int(numTx)):
                    hdlc.send([0x0a]*uartTxLen)
                    time.sleep(uartTxDelay/1000.0)
                print 'done.'
            elif command.startswith('exit'):
                hdlc.disconnect()
                sys.exit(0)
            elif command.startswith('help'):
                output  = []
                output += ['Commands:']
                output += ['   connect <comPort>']
                output += ['   len <numBytes>']
                output += ['   delay <numMs>']
                output += ['   tx <numPackets>']
                output += ['   exit']
                output  = '\n'.join(output)
                print output
            else:
                print 'unknown command'
        except Exception as err:
            print 'invalid (err={0})'.format(err)

if __name__=='__main__':
    main()
