ECE-412-Capstone-Sensor-Suite/Team-20-Sensor-Suite/Firmware/On-chip App/onchipsdk-REL-1.1.0.7/src/app/04-dc2126a/app_task_cfg.h

/**
Copyright (c) 2013, Dust Networks.  All rights reserved.
*/

#ifndef APP_TASK_CFG_H
#define APP_TASK_CFG_H

#define TASK_APP_REPORT_NAME           "report"
#define TASK_APP_REPORT_PRIORITY       54
#define TASK_APP_REPORT_STK_SIZE       256

#define TASK_APP_LDOPIN_NAME           "ldoPin"
#define TASK_APP_LDOPIN_PRIORITY       53
#define TASK_APP_LDOPIN_STK_SIZE       64

#endif
