ECE-412-Capstone-Sensor-Suite/Team-20-Sensor-Suite/Firmware/On-chip App/onchipsdk-REL-1.1.0.7/src/app/02-uart/app_task_cfg.h

#ifndef APP_TASK_CFG_H
#define APP_TASK_CFG_H

#define TASK_APP_UART_TX_NAME          "uartTx"
#define TASK_APP_UART_TX_PRIORITY      53
#define TASK_APP_UART_TX_STK_SIZE      256

#define TASK_APP_UART_RX_NAME          "uartRx"
#define TASK_APP_UART_RX_PRIORITY      54
#define TASK_APP_UART_RX_STK_SIZE      256

#endif
