ECE-412-Capstone-Sensor-Suite/Team-20-Sensor-Suite/Firmware/On-chip App/onchipsdk-REL-1.1.0.7/src/app/04-fft/app_task_cfg.h

#ifndef APP_TASK_CFG_H
#define APP_TASK_CFG_H

// list tasks in order of priority

#define TASK_APP_SAMPLE_NAME           "sample"
#define TASK_APP_SAMPLE_PRIORITY       53
#define TASK_APP_SAMPLE_STK_SIZE       2048  //32-bit words

#endif
