ECE-412-Capstone-Sensor-Suite/Team-20-Sensor-Suite/Firmware/On-chip App/onchipsdk-REL-1.1.0.7/src/app/04-voting/app_task_cfg.h

#ifndef APP_TASK_CFG_H
#define APP_TASK_CFG_H

#define TASK_APP_BUTTON_NAME           "button"
#define TASK_APP_BUTTON_PRIORITY       53
#define TASK_APP_BUTTON_STK_SIZE       256

#define TASK_APP_SEND_NAME             "send"
#define TASK_APP_SEND_PRIORITY         54
#define TASK_APP_SEND_STK_SIZE         256

#define TASK_APP_VOTINGLED_NAME        "votingLED"
#define TASK_APP_VOTINGLED_PRIORITY    55
#define TASK_APP_VOTINGLED_STK_SIZE    256

#define TASK_APP_STATUSLEDS_NAME       "statusLEDs"
#define TASK_APP_STATUSLEDS_PRIORITY   56
#define TASK_APP_STATUSLEDS_STK_SIZE   256

#endif
