ECE-412-Capstone-Sensor-Suite/Team-20-Sensor-Suite/Firmware/ENERGIA CODE/SmartMesh C library/sm_clib-master/examples/MSP432 energia/Triangle2manager/Triangle2manager.ino

/*
Copyright (c) 2014, Dust Networks.  All rights reserved.

Arduino sketch which connects to a SmartMesh IP mote and periodically sends a
2-byte value to the manager. You can use the SensorDataReceiver application of
the SmartMesh SDK to see that data arrive.

Note: before you can run this sketch, you need import the sm_clib
library. To do so:
- double click on this file to open the Arduino IDE
- In Sketch > Import Library... > Add Library..., select navigate to the
  sm_clib folder and click open.

Note: before running this sketch:
- configure your SmartMesh IP mote to run in slave mode
- on your SmartMesh IP mote, configure the network ID you the mote to connect
  to.
- remove the battery from your SmartMesh IP mote, it will be powered by the
  Arduino Due
- connect your Arduino Due board to your DC9003 SmartMesh IP mote as detailed
  in the documentation.
- make sure the power switch of the DC9003 SmartMesh IP mote is in the ON
  position.

To run this sketch, connect your Arduino Due board to your computer, and Select
File > Upload. 
  
\license See attached DN_LICENSE.txt.
*/

#include <IpMtWrapper.h>
#include <TriangleGenerator.h>
#include <dn_ipmt.h>

IpMtWrapper       ipmtwrapper;
TriangleGenerator generator;

//============================== data generator ==================================

void generateData(uint16_t* returnVal) {
   generator.nextValue(returnVal);
}

//============================== "main" ==========================================

void setup() {
   ipmtwrapper.setup(
      60000,                           // srcPort
      (uint8_t*)ipv6Addr_manager,      // destAddr
      61000,                           // destPort
      10000,                           // dataPeriod (ms)
      generateData                     // dataGenerator
   );
}

void loop() {
   ipmtwrapper.loop();
}
