ECE-412-Capstone-Sensor-Suite/Team-20-Sensor-Suite/(commit log)

2021-02-27 Update I2C_CHAIN.ino
    update I2C Chain code!!
2021-02-28 Create Basic event flow.PNG
2021-03-04 Smart mesh Python scripts and libraries
    [configuration_DO_NOT_DELETE.txt]
2021-03-04 OAP logger to log sensor data onto log file
2021-03-04 OAP logger.md
    This is where we connect to the manager and receive and organize sensor data sent for the OAP(on-chip application) that we loaded onto the motes.
2021-03-04 Adding all required libraries to being on chip programing
    [QuickRefChart-Color.xls]
2021-03-05 organized Onchip library
    [QuickRefChart-Color.xls]
2021-03-05 Create insert
2021-03-06 I2C_ChainV2 upgraded
2021-03-06 replacing o2 library sextion with i2C Chain O2 fxn
2021-04-16 UPDATING I2C CHAIN ENERGIA WITH SMART MESH CODE
2021-04-16 Adding libraries needed for Smartmesh integration into I2C chain
2021-05-01 Adding sensor data sending bia SmartMesh
2021-05-01 Added Design Files Folder
    Schematic, board, and pdf file of schematic added.
    [mote+cc3200.brd, mote+cc3200.sch]
2021-05-03 Fixing send value crash bug
    [I2C_CHAIN_V6.ino]
2021-05-03 Add files via upload
    PCB design Version2
    [schematic1.brd, schematic1.sch]
2021-05-04 MAIN DEPLOYABLE SENSOR MOTE CODE FOR CC3200
2021-05-06 adding red led
2021-05-13 Sensor logger and sensor mote V1.1
2021-05-16 Updated Design Files and Libraries
    Some libraries included in the design were added.
    [mote+cc3200.brd, mote+cc3200.sch]
2021-05-24 Updated design files.
    Overwritten original mote+cc3200 files to revision 1.5. Added CAM data files in zip folder for PCB fabrication.
    [mote+cc3200.brd, mote+cc3200.sch]
2021-05-25 Design files revised.
    Added SOP connections to the design.
    Ground stitched vias on the board were placed.
    [mote+cc3200.brd, mote+cc3200.sch]
2021-05-28 Version 6 of Design
    -Updated board to be 4"x3.5".
    -Changed Isolation from 1 to 16 for ground layers.
    -Generated updated CAM files.
    -Fixed connections to Smart Mesh Headers.
    -Separated the schematic into 4 pages.
    -Added more schematic modules for organization.
    [mote+cc3200v6.brd, mote+cc3200v6.sch]
2021-06-02 adding sensor suite GUI
2021-06-03 Version 7 of the Schematic and Board
    -Revised according to schematic review on 5/28/2021.
    -Added reset button for CC3200.
    -Tied some power and input pins to ground on both controllers.
    [mote+cc3200v7.brd, mote+cc3200v7.sch]
2021-06-10 Mote schematic/PCB Updated
    Analog sensors were given voltage dividers at 1.4V scale to be within the CC3200's ADC range.
    [mote+cc3200v8.brd, mote+cc3200v8.sch]
2021-06-11 Rearranging Github
    [QuickRefChart-Color.xls]
